Pruthvi-Neuracore/The-UMI-no-one-wants-hw/pg-chopstick/README.md

# PG Chopstick

**Collect robot-manipulation data with your own hands, then replay it on a robot with the same gripper.**

<p align="center">
  <a href="docs/media/pg_chopstick.mp4">PG Chopstick overview: the Insta360 X5 chopstick and HandUMI parallel grippers, the robot twins docking on UR5e, ABB GoFa, FANUC CRX and OpenArm, the wrist mount, and the D405 + Quest builds</a>
  <br><em>Overview (46 s). Click for the full-quality video.</em>
</p>

<p align="center">
  PG Chopstick handheld gripper with an Insta360 X5
  PG Chopstick handheld gripper with a RealSense D405 and a Quest Touch Pro controller
</p>

> Each kit also has its own branch: [`pg-chopstick-x5`](https://github.com/Pruthvi-Neuracore/The-UMI-no-one-wants-hw/tree/pg-chopstick-x5) (Insta360 X5) and
> [`pg-chopstick-d405`](https://github.com/Pruthvi-Neuracore/The-UMI-no-one-wants-hw/tree/pg-chopstick-d405) (D405 + Quest).

PG Chopstick is open hardware for handheld data collection. You hold a printed gripper, or wear a camera on your
wrist, and do the task. A camera on the device records what you see. Its robot twin carries the same jaws and the same
camera at the same spot, so a policy trained on your demonstrations sees the same thing on the robot.

<p align="center">
  Bimanual UR5 with PG Chopstick grippers
</p>

## Two camera kits × three ways to grasp

| | **Insta360 X5 kit** | **D405 + Quest kit** |
|---|---|---|
| Camera | Insta360 X5, 360° video | Intel RealSense D405 depth camera, on a tilting mount |
| Pose | from the X5's own IMU and visual mapping of its video | live, from a Meta Quest Touch Pro controller on the device (tracking only) |
| On the device | wireless: the PG pod (ESP32-S3, IMU, battery) | one USB-C cable: Pico 2 + IMU + USB 3 hub in a small box |
| **Chop-UMI**: geared chopstick jaws you pinch | [insta360_x5/chop-umi](insta360_x5/chop-umi/README.md) | [d405/chop-umi](d405/chop-umi/README.md) |
| **Para-UMI**: the HandUMI T-plate parallel gripper, swappable tips | [insta360_x5/para-umi](insta360_x5/para-umi/README.md) | [d405/para-umi](d405/para-umi/README.md) |
| **Hand**: camera on your wrist, bare hand | [insta360_x5/hand](insta360_x5/hand/README.md) | [d405/hand](d405/hand/README.md) |

- **Chop-UMI:** right-hand and left-hand builds and two robot twins, on **OpenArm** (link7 adapter) and on any cobot
  with an **ISO 9409-1-50-4-M6** flange (UR e-series, ABB GoFa, FANUC CRX, ...). On the D405 kit, the Quest controller
  sits in HandUMI's own controller support, facing forward, mirrored for the left hand.
- **Para-UMI:** [HandUMI](https://github.com/Pruthvi-Neuracore/The-UMI-no-one-wants) unchanged. On the X5 kit the
  only new part is the X5 cradle on its camera hinge. The tips swap (AgileX Piper, Robotiq Hand-E, Open-ENPIRE) to
  match the robot's own gripper, and a printed **camera post** for each robot (Hand-E on UR / ABB / FANUC, Piper,
  OpenArm) puts the same camera in the same place relative to the robot's fingers.
- **Hand:** the camera straps to your wrist, or to a dexterous robot hand's forearm. A thumb strap round the palm keeps
  it put and carries a soft **palm button**: curl your middle and ring fingers in to start and stop recording.
- **One button per gripper:** it sits under your index finger. **Green** on the right hand records (start / stop);
  **red** on the left hand cancels the take.

<table>
<tr>
<td align="center">HandUMI T-plate gripper with the Insta360 X5 on its camera post<br><b>Para-UMI</b>: HandUMI with the X5 on its post, swappable tips</td>
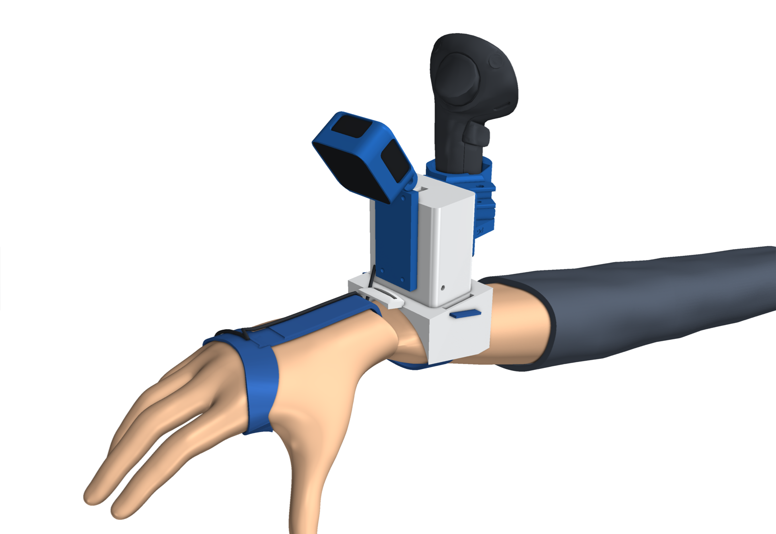
[picture p29: pg-chopstick/d405/hand/img/hand.png]
Insta360 X5 strapped to the wrist over a relaxed hand, with the thumb strap
<td align="center"><br><b>Hand</b>: the camera rides on your wrist</td>
</tr>
<tr>
<td align="center">The Para-UMI device beside a Robotiq Hand-E with the camera post: the X5 in the same place over both<br>Para-UMI's camera on the robot's own gripper</td>
<td align="center">FANUC CRX-5iA pair with chopsticks<br>FANUC CRX-5iA ×2, chopsticks</td>
</tr>
<tr>
<td align="center">The palm button on the thumb strap<br>The palm button, on the thumb strap</td>
<td align="center">The X5 on a Shadow Hand's forearm on a UR5e<br>The same wrist mount on a robot hand</td>
</tr>
</table>

## What the Chop-UMIs share

<p align="center">
  Chopstick jaws opening 0 to 45 degrees per jaw
</p>

- **One interface:** the chopsticks clip to the camera frame with a tongue and two M3 × 55 screws, and every robot plate
  bolts to the frame's back with four M3 inserts. Mix and match.
- **Elastic finger sleeves:** your fingers sit on a pad between two slotted fins, held by a soft hook-and-loop strap
  that fits any finger.
- **Blue tracking dots:** printed as inlays on the jaws, so the camera sees how far they are open.
- **Checked in CAD:** every build is clash-checked closed, half open and fully open, and every robot twin has a URDF.
- **Para-UMI grippers:** these are HandUMI's own design (finger sleeves, record button, tip flange), with the same
  green record / red cancel button covers.
- **PG look:** blue structure, white moving parts, an engraved PG badge on every part.

<p align="center">
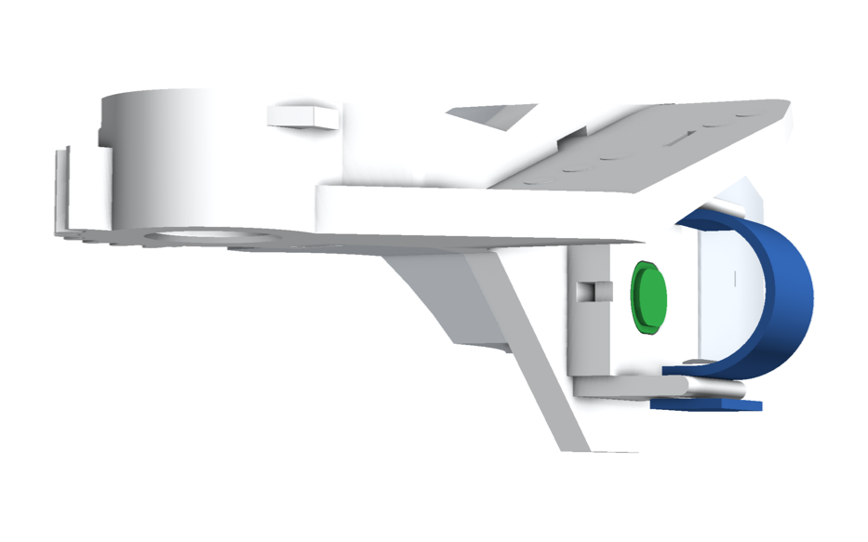
[picture p30: pg-chopstick/d405/chopstick/img/sleeve.png]
Elastic finger sleeve with the green record button
  
  OpenArm adapter and ISO 50 plate
</p>

## Repository layout

```
pg-chopstick/                               (this folder, on main)
  insta360_x5/{chop-umi,para-umi,hand}/     README · bom.md · electronics.md · STEP/ · STL/ · assembly/ · urdf/ · img/
  d405/{chop-umi,para-umi,hand}/            (same)
  tags/                                     ArUco tag sheet, one tag per device
  docs/media/                               pg_chopstick.mp4, pg_chopstick.gif
```

The build code is on the [`cad`](https://github.com/Pruthvi-Neuracore/The-UMI-no-one-wants-hw/tree/cad) branch, in
`pg-chopstick/cad/`: `insta360_x5/` and `d405/` hold each kit's generators (Python, build123d), and `make_video.py`
makes the overview video. Paths written as `cad/...` in these docs are there.

Each variant folder holds everything you need to print and build it: every part as STEP and STL, the assemblies
(GLB and STL), the URDFs, a bill of materials, the wiring, and a detailed README with renders.

## Rebuild from source

Use Python 3.12 with `build123d`, `bd_warehouse`, `trimesh`, `manifold3d`, `scipy`, `pyvista` and `yourdfpy`. On the `cad` branch, in
`pg-chopstick/cad/<kit>/`, run the part scripts, then `kinematics.py --check`, `urdf.py`, `assembly.py --check`, `render_docs.py`,
`robots.py`, `t_gripper.py` (the HandUMI parallel gripper), `robot_cameras.py` (its robot camera posts) and finally
`package.py`, which copies the results into
`pg-chopstick/<kit>/`. Generated intermediates go to
`build/` (not committed).

## Status

- **Designed and checked in CAD:** the chopstick and hand builds of both kits (clash checks, opening limits, gear
  mesh, robot flange fit, URDFs), and the X5 cradle on HandUMI (clash-free at every opening with every tip set).
- **Not yet printed or tested on hardware:** the new parts, the ISO plate's spigot and dowel on a real flange, and the
  firmware for the pod and the box.
- **Software (retargeting, tracking):** not in this repository yet.

Licences: [NOTICE.md](NOTICE.md) (Apache-2.0).
