Pruthvi-Neuracore/The-UMI-no-one-wants-hw/scissor-umi/cad/source/feetech/README.md

# Feetech STS3215 (reference model)

| File | Source | License |
|---|---|---|
| `STS3215_03a.step` | [TheRobotStudio/SO-ARM100](https://github.com/TheRobotStudio/SO-ARM100) `STEP/SO100/STS3215_03a.step` (as vendored in HandUMI) | Apache-2.0 |

It is used for the renders and the clearance checks, and to place the servo's mounting holes in the electronics box.
