Pruthvi-Neuracore/The-UMI-no-one-wants-hw/pg-chopstick/d405/hand/electronics.md

# Electronics: D405 + Quest · Hand

One USB-C cable from the electronics box to the laptop carries the D405 and the Pico. The Quest Touch Pro controller is
self-powered (built-in battery) and tracks itself with its own cameras; it has no wires and its buttons are not used.

```
 D405 depth camera ──USB 3 (out of the cup's top window, into the box's top slot)──┐
                                                                                   ├── USB 3 hub ══ USB-C ══ laptop
 Raspberry Pi Pico 2 ──USB─────────────────────────────────────────────────────────┘
   ├── I²C GP4 SDA / GP5 SCL ── IMU breakout (BNO085 class), flat under the box's top wall
   └── GP15 / GP14 free (no finger sleeve on the hand build; add a fingertip button here if you want one)

 Meta Quest Touch Pro controller in the cradle ── self-tracked by its own cameras (pose only; buttons unused)
```

| Part | Notes |
|---|---|
| USB 3 hub board, USB-C upstream (VL817-type, 4 port) | Stands against the box's front wall (bay 42 × 38 mm, ≤ 14 mm thick). The upstream USB-C leaves through the slot low in the back wall. **Check your board's size** |
| Raspberry Pi Pico 2 | On the box's back wall (M2 standoffs or foam tape), micro-USB to the hub with a short right-angle cable |
| IMU breakout, BNO085 class | Flat under the top wall, rigid to the head |
| D405 cable, USB-C to USB-A, USB 3, about 15 cm | From the cup's top window down into the box's top slot |

**Power.** Everything runs from the laptop's USB 3 port (900 mA covers the D405, the Pico and the IMU). If the camera
drops out, use a port that gives more current or a powered hub.
