Pruthvi-Neuracore/The-UMI-no-one-wants-hw/handumi/docs/img/fea/crank_mechanism_plate_0.png

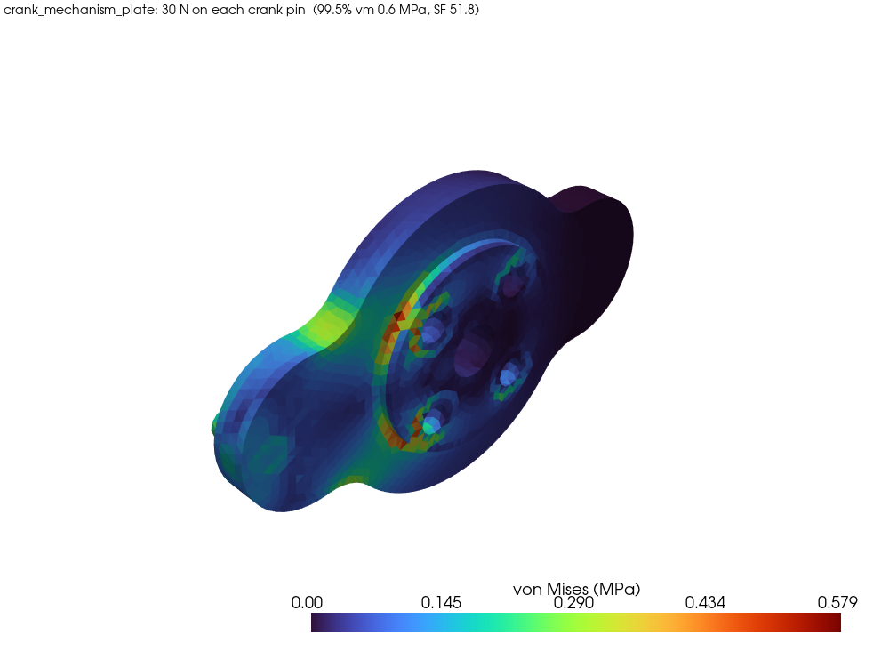
handumi/docs/img/fea/crank_mechanism_plate_0.png
