Pruthvi-Neuracore/The-UMI-no-one-wants-hw/handumi/docs/img/fea/finger_link_0.png

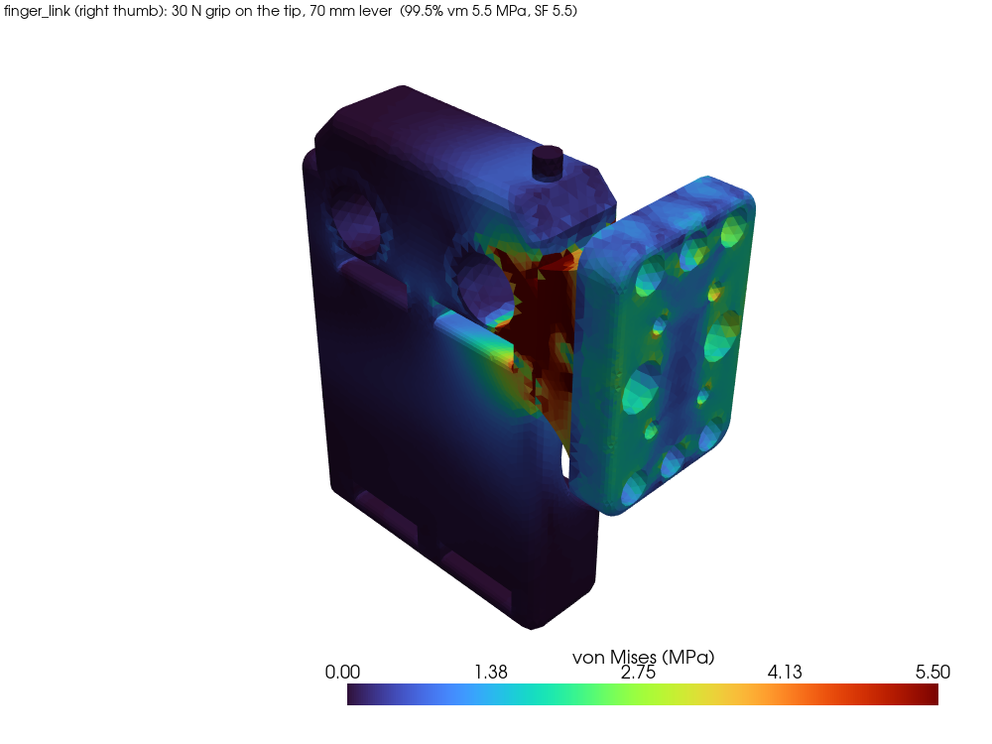
handumi/docs/img/fea/finger_link_0.png
