Pruthvi-Neuracore/The-UMI-no-one-wants-hw/handumi/docs/img/fea/main_support_3.png

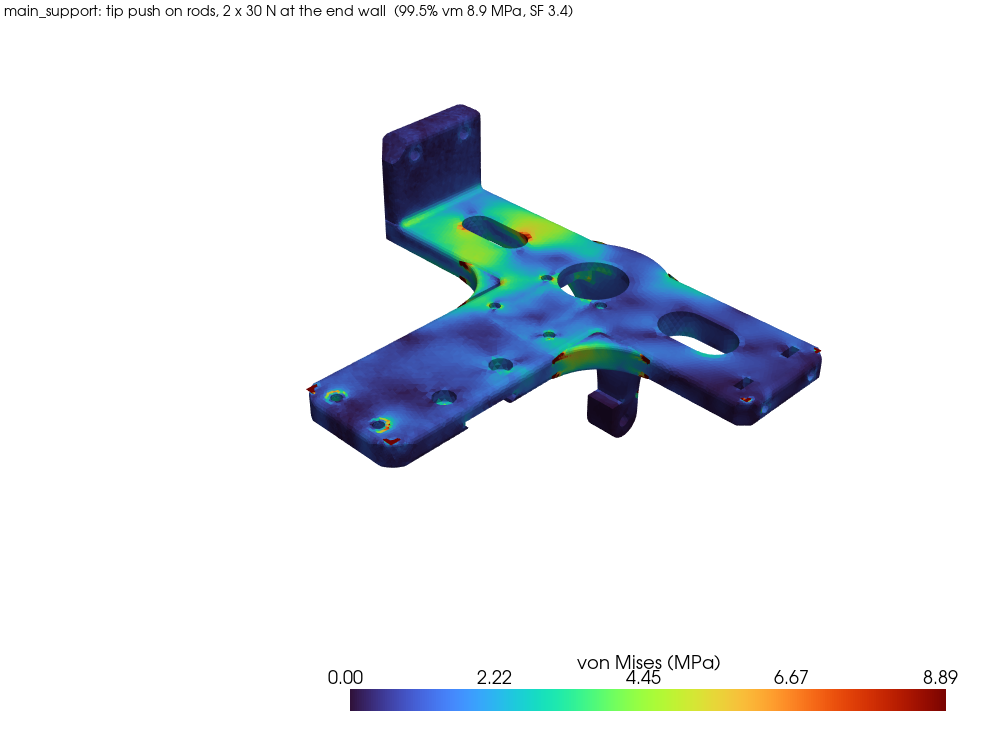
handumi/docs/img/fea/main_support_3.png
