Pruthvi-Neuracore/The-UMI-no-one-wants-hw/pg-chopstick/d405/chop-umi/img/opening.png

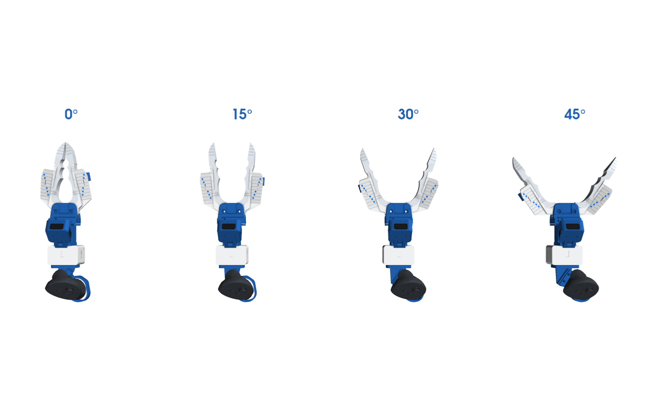
pg-chopstick/d405/chop-umi/img/opening.png
