Pruthvi-Neuracore/The-UMI-no-one-wants-hw/pg-chopstick/d405/hand/img/pod.png

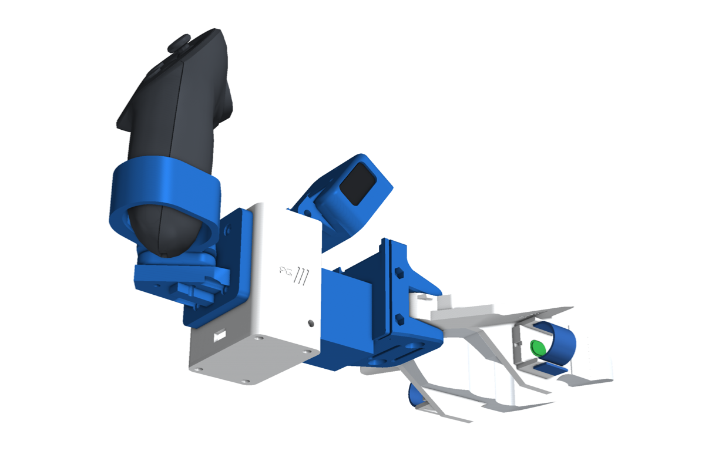
pg-chopstick/d405/hand/img/pod.png
