Pruthvi-Neuracore/The-UMI-no-one-wants-hw/pg-chopstick/insta360_x5/para-umi/img/camera_mount.png

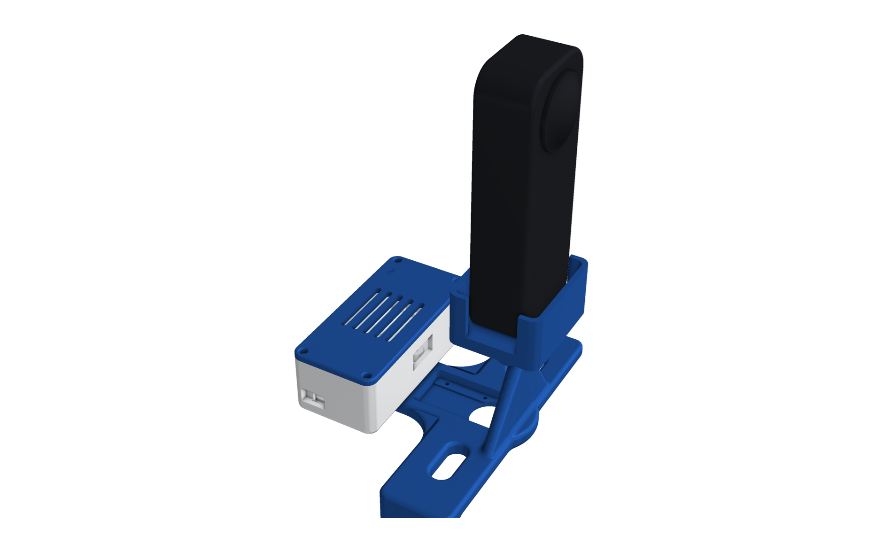
pg-chopstick/insta360_x5/para-umi/img/camera_mount.png
