Pruthvi-Neuracore/The-UMI-no-one-wants-hw/pg-chopstick/insta360_x5/para-umi/img/robot_camera_openarm.png

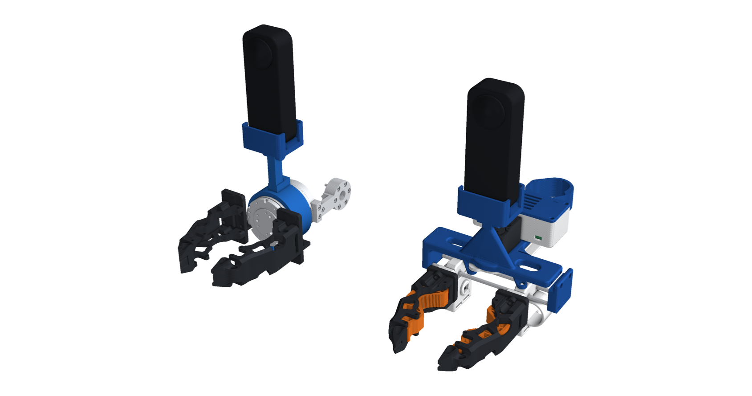
pg-chopstick/insta360_x5/para-umi/img/robot_camera_openarm.png
