Pruthvi-Neuracore/The-UMI-no-one-wants-hw/pg-chopstick/insta360_x5/para-umi/img/tips_open-enpire.png

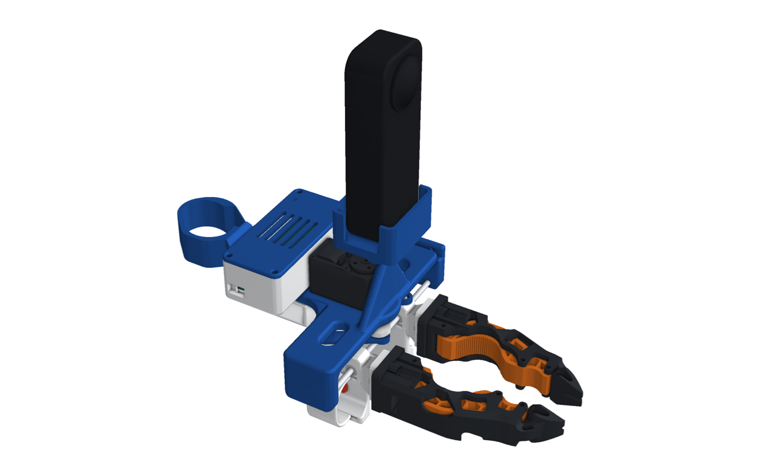
pg-chopstick/insta360_x5/para-umi/img/tips_open-enpire.png
