Pruthvi-Neuracore/The-UMI-no-one-wants-hw/pg-chopstick/insta360_x5/parallel/img/parallel_opening.png

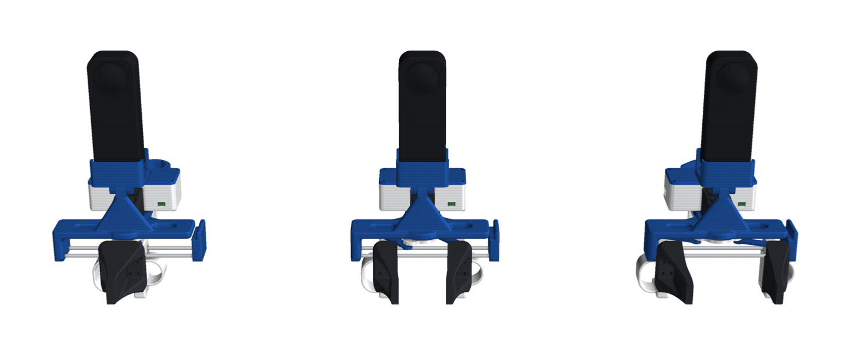
pg-chopstick/insta360_x5/parallel/img/parallel_opening.png
