Pruthvi-Neuracore/The-UMI-no-one-wants-hw/scissor-umi/2f-85/img/hands.png

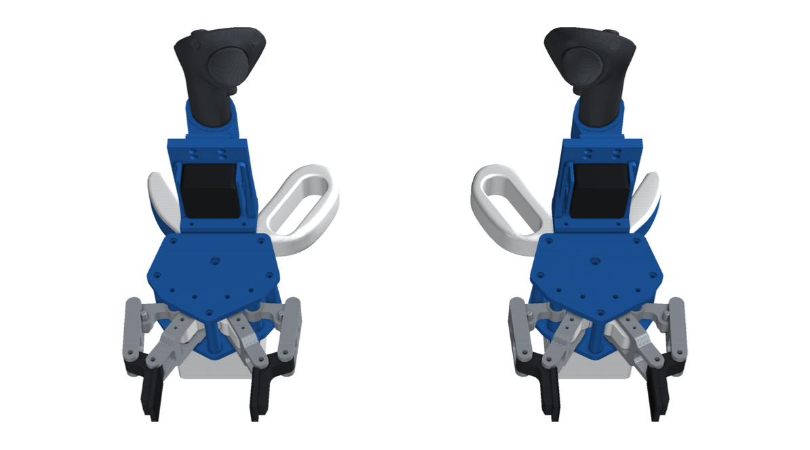
scissor-umi/2f-85/img/hands.png
