Pruthvi-Neuracore/The-UMI-no-one-wants-hw/handumi/docs/bom.md

# Bill of materials

Quantities are for a **pair** (one right-hand and one left-hand device).

## Printed parts

| Part | Material | Qty |
|---|---|---|
| Everything in `hardware/STL/right/` and `hardware/STL/left/` except the button cover | PLA or PETG, ~200 g per device | 1 set each |
| `button_cover_tpu.stl` | TPU 95A | 2 |
| Tips from `hardware/STL/gripper_tips/` (Piper, Open-ENPIRE or Hand-E) | PLA / PETG (ENPIRE soft inserts in TPU) | 2 pairs |

## Mechanics

| Part | Qty |
|---|---|
| MR63ZZ bearing, 3 × 6 × 2.5 mm | 8 |
| LM4UU linear bearing, 4 × 8 × 12 mm | 8 |
| Ø4 mm × 135 mm stainless rod | 4 |
| Feetech STS3215 servo (used as the jaw-width encoder, torque off) | 2 |
| M4×30 bolt + nyloc nut (camera hinge) | 2 |
| M3×5 screws (D405 to its cup) | 4 |
| M3 screws: 4× M3×20, 8× M3×12, 8× M3×15 (mechanism); 4× M3×8 (box to arm); 8× M3×6 (lid) | 32 |
| M3 heat-set inserts, Ø4.0 × 5 (box, lid, M3 tip pattern) | ~24 |
| M2 screws + nuts (mechanism, tips, Pico) | ~40 |
| Hook-and-loop straps, 15 cm | 8 |

## Electronics

| Part | Qty |
|---|---|
| Intel RealSense D405 | 2 |
| Raspberry Pi Pico 2 | 2 |
| BNO085 IMU breakout | 2 |
| USB 3 hub board, USB-C upstream (fits a 38 × 42 × 14 mm bay) | 2 |
| 6 × 6 mm tactile switch, stiff (~250–320 gf) | 2 |
| Short USB cables (D405 to hub, Pico to hub) and one USB-C cable to the laptop per device | 2 sets |
| 74LVC1G125 buffer or 1 kΩ resistor (servo bus) | 2 |
| Thin 2-core wire, ~30 cm | 2 |

Wiring and power are in [electronics.md](electronics.md).
