Pruthvi-Neuracore/The-UMI-no-one-wants-hw/pg-chopstick/d405/chopstick/bom.md

# Bill of materials: D405 + Quest · Chopstick

Per gripper. A bimanual kit is one `chopstick_right` and one `chopstick_left`, plus two robot twins.

## Printed parts

| Part | Material | Handheld | Robot |
|---|---|---|---|
| `d405_frame` | blue PLA | 1 | 1 |
| `d405_cup` | blue PLA | 1 | 1 |
| `ebox`, `ebox_lid` | white PLA | 1, 1 | |
| `quest_cradle` | blue PLA | 1 | |
| `chopstick_base_dc` / `chopstick_base_sa` | blue PLA | 1 | 1 |
| `chopstick_clip_dc` / `chopstick_clip_sa` | blue PLA | 1 | 1 |
| `jaw_left_dc` + `jaw_right_dc_button` (right hand) or `jaw_left_dc_button` + `jaw_right_dc` (left hand) | white PLA + blue dot inlays | 1 + 1 | |
| `jaw_left_sa`, `jaw_right` | white PLA + blue dot inlays | | 1, 1 |
| `tip_tpu_left`, `tip_tpu_right` | white TPU 95A | 1, 1 | 1, 1 |
| `sleeve_button_cover_right` (record) / `_left` (cancel) | green / red TPU 95A | 1 | |
| `openarm_adapter` or `iso_flange_plate` | blue PETG | | 1 |

## Bought parts

| Item | Handheld | Robot | Notes |
|---|---|---|---|
| Intel RealSense D405 | 1 | 1 | |
| M3 × 6 socket screw | 2 | 2 | D405 into the cup |
| M4 × 30 bolt + M4 nyloc nut | 1 | 1 | Tilt hinge |
| Meta Quest Touch Pro controller (paired to a Quest 3S or 3 headset) | 1 | | Tracking only |
| Hook-and-loop strap, 20 mm, + 2 mm foam | 2 × 20 cm | | Controller in the cradle |
| M3 × 8 + M3 heat-set inserts | 4 + 4 | | Cradle to the box |
| M3 × 10 + M3 heat-set inserts | 4 + 4 | 4 + 4 | Box (or mount plate) to the frame's back plate |
| Electronics box parts | 1 set | | [electronics.md](electronics.md) |
| M2 × 6 self-tapping screw | 4 | | Box lid |
| 624 ball bearing | 4 | 2 | |
| Shoulder screw M3, Ø4 × 18 mm shoulder | 2 | 2 | |
| Socket screw M3 × 55, button head, + nut + washer (9 mm OD) | 2 | 4 | Frame + base + clip |
| Heat-set insert M2 × 4 / M3 × 4 | 2 / 2 | 4 / 1 | Base |
| Rubber band | 1 | | |
| Elastic hook-and-loop strap, 16 mm | 2 × 12 cm | | Finger straps |
| Tactile switch 6 × 6 mm, 250–320 gf + 30 cm 2-core wire | 1 | | Index-finger button to the Pico |
| Feetech SM40BL servo set + 4 × M3 × 12 | | 1 | |
| OpenArm: M3 × 16 / ISO 50: M6 × 14 + dowel Ø6 × 10 | | 6 / 4 + 1 | |
