Pruthvi-Neuracore/The-UMI-no-one-wants-hw/pg-chopstick/insta360_x5/chopstick/bom.md

# Bill of materials: Insta360 X5 · Chopstick

Quantities are per gripper. A bimanual kit is one `chopstick_right` and one `chopstick_left`, plus two robot twins.

## Printed parts

| Part | Material | Handheld | Robot |
|---|---|---|---|
| `x5_lite_frame` | blue PLA | 1 | |
| `x5_frame`, `x5_clip_b` | blue PLA | | 1, 1 |
| `chopstick_base_dc` / `chopstick_base_sa` | blue PLA | 1 | 1 |
| `chopstick_clip_dc` / `chopstick_clip_sa` | blue PLA | 1 | 1 |
| `jaw_left_dc` + `jaw_right_dc_button` (right hand) or `jaw_left_dc_button` + `jaw_right_dc` (left hand) | white PLA + blue dot inlays | 1 + 1 | |
| `jaw_left_sa`, `jaw_right` | white PLA + blue dot inlays | | 1, 1 |
| `tip_tpu_left`, `tip_tpu_right` | white TPU 95A | 1, 1 | 1, 1 |
| `sleeve_button_cover_right` (right hand, record) / `_left` (left hand, cancel) | green / red TPU 95A | 1 | |
| `pg_pod`, `pg_pod_lid` | white PLA | 1, 1 | |
| `openarm_adapter` or `iso_flange_plate` | blue PETG | | 1 |

## Bought parts

| Item | Handheld | Robot | Notes |
|---|---|---|---|
| Insta360 X5 | 1 | 1 | Voice control on, auto power-off off, 4K 120 fps, battery cover removed |
| 624 ball bearing (4 × 13 × 5) | 4 | 2 | |
| Shoulder screw M3, Ø4 × 18 mm shoulder | 2 | 2 | Jaw pivots |
| Socket screw M3 × 55, button head, + M3 nut + washer (9 mm OD) | 2 | 4 | Frame + base + clip |
| Heat-set insert M2 × 4 / M3 × 4 | 2 / 2 | 4 / 1 | Base |
| Socket cap screw M2 × 4 | 2 | 4 | Locating screws |
| Rubber band | 1 | | Opens the jaws |
| Elastic hook-and-loop strap, 16 mm wide | 2 × 12 cm | | Finger straps |
| Tactile switch 6 × 6 mm, 250–320 gf, 4.3 mm tall | 1 | | Index-finger button |
| Thin 2-core silicone wire | 25 cm | | Button to the pod |
| Button-head screw 1/4"-20 × 5/8" | 1 | | Pod + frame + camera |
| PG pod electronics | 1 set | | See [electronics.md](electronics.md) |
| ArUco tag, DICT_4X4_50, 14 mm | 1 | | `pg-chopstick/tags/` |
| Feetech SM40BL servo set + 4 × M3 × 12 | | 1 | Drives the left jaw |
| Mount: M3 heat-set inserts (Ø4.0, ≤ 6 mm) + M3 × 10 | | 4 + 4 | X5 frame to the plate |
| OpenArm: M3 × 16 | | 6 | Adapter to link7 |
| ISO 50: M6 × 14, dowel pin Ø6 × 10 | | 4, 1 | Plate to the tool flange |
| Super glue | ✓ | ✓ | TPU tips |
