Pruthvi-Neuracore/The-UMI-no-one-wants-hw/pg-chopstick/insta360_x5/hand/bom.md

# Bill of materials: Insta360 X5 · Hand

| Item | Qty | Notes |
|---|---|---|
| `x5_lite_frame` | 1 | blue PLA |
| `pg_pod`, `pg_wrist_saddle` | 1 each | white PLA |
| Insta360 X5 | 1 | |
| Button-head screw 1/4"-20 × 5/8" | 1 | Pod + frame + camera |
| M2 × 6 self-tapping screw | 4 | Saddle to the pod |
| PG pod electronics (XIAO ESP32-S3, IMU, 300 mAh LiPo, slide switch) | 1 set | [electronics.md](electronics.md) |
| Hook-and-loop strap, 25 mm wide | about 35 cm | Round the forearm |
| Thin foam pad | 1 | Under the saddle |
| `pg_wrist_saddle_robot` (robot hand only, instead of `pg_wrist_saddle`) | 1 | PETG, for round robot forearms up to Ø137 mm |
