Pruthvi-Neuracore/The-UMI-no-one-wants-hw/assembly/d405/hand/bom.md

# Bill of materials: D405 + Quest · Hand

| Item | Qty | Notes |
|---|---|---|
| `d405_frame`, `d405_cup`, `quest_cradle` | 1 each | blue PLA |
| `ebox`, `ebox_wrist_saddle` | 1 each | white PLA |
| Intel RealSense D405 + 2 × M3 × 6 | 1 | |
| M4 × 30 bolt + M4 nyloc nut | 1 | Tilt hinge |
| Meta Quest 3S Touch Plus controller (and the headset) | 1 | Tracking only |
| Hook-and-loop strap, 20 mm, + 2 mm foam | 2 × 20 cm | Controller in the cradle |
| M3 × 8 + M3 heat-set insert | 4 + 4 | Cradle to the box |
| M3 × 10 + M3 heat-set insert | 4 + 4 | Box to the frame's back plate |
| M2 × 6 self-tapping screw | 4 | Saddle to the box |
| Electronics box parts | 1 set | [electronics.md](electronics.md) |
| Hook-and-loop strap, 25 mm | about 35 cm | Round the forearm |
| Thin foam pad | 1 | Under the saddle |
