Pruthvi-Neuracore/The-UMI-no-one-wants-hw/assembly/d405/parallel/bom.md

# Bill of materials: D405 + Quest · Parallel

Per gripper. A bimanual kit is one `chopstick_right` and one `chopstick_left`, plus two robot twins.

## Printed parts

| Part | Material | Handheld | Robot |
|---|---|---|---|
| `d405_frame` | blue PLA | 1 | 1 |
| `d405_cup` | blue PLA | 1 | 1 |
| `ebox`, `ebox_lid` | white PLA | 1, 1 | |
| `quest_cradle` | blue PLA | 1 | |
| `parallel_base_dc` / `parallel_base_sa` | blue PLA | 1 | 1 |
| `chopstick_clip_dc` / `chopstick_clip_sa` | blue PLA | 1 | 1 |
| `parallel_carriage_left`, `_right` | white PLA | 1, 1 | 1, 1 |
| `parallel_pinion` / `parallel_pinion_servo` | white PLA | 1 | 1 |
| `parallel_finger_left_sleeve` + `parallel_finger_right_button` (right hand), or `_left_button` + `_right_sleeve` (left hand) | white PLA + blue dot inlays | 1 + 1 | |
| `parallel_finger_left`, `_right` | white PLA + blue dot inlays | | 1, 1 |
| `parallel_pad_left`, `_right` | white TPU 95A | 1, 1 | 1, 1 |
| `parallel_button_cover_right` (record) / `_left` (cancel) | green / red TPU 95A | 1 | |
| `openarm_adapter` or `iso_flange_plate` | blue PETG | | 1 |

## Bought parts

| Item | Handheld | Robot | Notes |
|---|---|---|---|
| Intel RealSense D405 | 1 | 1 | |
| M3 × 6 socket screw | 2 | 2 | D405 into the cup |
| M4 × 30 bolt + M4 nyloc nut | 1 | 1 | Tilt hinge |
| Meta Quest 3S Touch Plus controller (and the headset) | 1 | | Tracking only |
| Hook-and-loop strap, 20 mm, + 2 mm foam | 2 × 20 cm | | Controller in the cradle |
| M3 × 8 + M3 heat-set inserts | 4 + 4 | | Cradle to the box |
| M3 × 10 + M3 heat-set inserts | 4 + 4 | 4 + 4 | Box (or mount plate) to the frame's back plate |
| Electronics box parts | 1 set | | [electronics.md](electronics.md) |
| M2 × 6 self-tapping screw | 4 | | Box lid |
| Steel rod Ø6 h6 × 156 mm | 2 | 2 | |
| LM6UU linear bushing | 4 | 4 | |
| Compression spring, ID ≥ 6.5, OD ≤ 11, free about 95 mm | 2 | | Between the carriages |
| M4 × 45 shoulder bolt or Ø4 pin + nyloc nut | 1 | | Pinion axle |
| Socket screw M3 × 14 + M3 heat-set insert | 4 + 4 | 4 + 4 | Fingers to carriages |
| Socket screw M3 × 55, button head, + nut + washer (9 mm OD) | 2 | 4 | Frame + base + clip |
| Elastic hook-and-loop strap, 16 mm | 2 × 12 cm | | Finger straps |
| Tactile switch 6 × 6 mm, 250–320 gf + 30 cm 2-core wire | 1 | | Index-finger button to the Pico |
| Feetech SM40BL servo set + 4 × M3 | | 1 | Turns the pinion |
| OpenArm: M3 × 16 / ISO 50: M6 × 14 + dowel Ø6 × 10 | | 6 / 4 + 1 | |
