Pruthvi-Neuracore/The-UMI-no-one-wants-hw/assembly/insta360_x5/parallel/bom.md

# Bill of materials: Insta360 X5 · Parallel

Per gripper. A bimanual kit is one `parallel_right` and one `parallel_left`, plus two robot twins.

## Printed parts

| Part | Material | Handheld | Robot |
|---|---|---|---|
| `x5_lite_frame` / `x5_frame` + `x5_clip_b` | blue PLA | 1 | 1 + 1 |
| `parallel_base_dc` / `parallel_base_sa` | blue PLA | 1 | 1 |
| `chopstick_clip_dc` / `chopstick_clip_sa` | blue PLA | 1 | 1 |
| `parallel_carriage_left`, `_right` | white PLA | 1, 1 | 1, 1 |
| `parallel_pinion` / `parallel_pinion_servo` | white PLA (or PETG) | 1 | 1 |
| `parallel_finger_left_sleeve` + `parallel_finger_right_button` (right hand), or `_left_button` + `_right_sleeve` (left hand) | white PLA + blue dot inlays | 1 + 1 | |
| `parallel_finger_left`, `_right` | white PLA + blue dot inlays | | 1, 1 |
| `parallel_pad_left`, `_right` | white TPU 95A | 1, 1 | 1, 1 |
| `parallel_button_cover_right` (record) / `_left` (cancel) | green / red TPU 95A | 1 | |
| `pg_pod`, `pg_pod_lid` | white PLA | 1, 1 | |
| `openarm_adapter` or `iso_flange_plate` | blue PETG | | 1 |

## Bought parts

| Item | Handheld | Robot | Notes |
|---|---|---|---|
| Insta360 X5 | 1 | 1 | |
| Steel rod Ø6 h6 × 156 mm | 2 | 2 | Press fit in the end walls |
| LM6UU linear bushing (Ø12 × 19) | 4 | 4 | Press fit in the carriages |
| Compression spring, ID ≥ 6.5, OD ≤ 11, free length about 95 mm | 2 | | On the rods, between the carriages |
| M4 × 45 shoulder bolt or Ø4 pin, + nyloc nut | 1 | | Pinion axle |
| Socket screw M3 × 14 + M3 heat-set insert | 4 + 4 | 4 + 4 | Fingers to carriages |
| Socket screw M3 × 55, button head, + nut + washer (9 mm OD) | 2 | 4 | Frame + base + clip |
| Elastic hook-and-loop strap, 16 mm | 2 × 12 cm | | Finger straps |
| Tactile switch 6 × 6 mm, 250–320 gf + 25 cm 2-core wire | 1 | | Index-finger button |
| Button-head screw 1/4"-20 × 5/8" | 1 | | Pod + frame + camera |
| PG pod electronics | 1 set | | [electronics.md](electronics.md) |
| Feetech SM40BL servo set + 4 × M3 | | 1 | Turns the pinion |
| Mount hardware | | as for the chopstick | |
