Pruthvi-Neuracore/The-UMI-no-one-wants-hw/handumi/docs/assembly_guide/page_00_parts.png

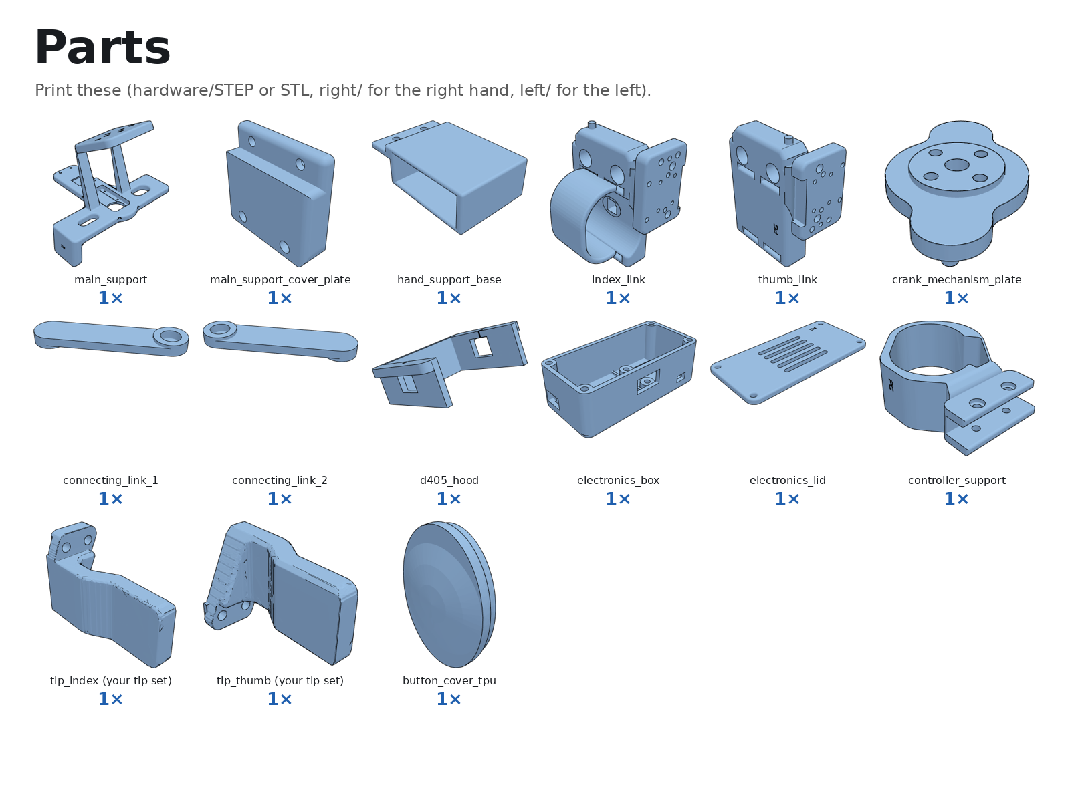
handumi/docs/assembly_guide/page_00_parts.png
