Pruthvi-Neuracore/The-UMI-no-one-wants-hw/handumi/hardware/STL/right/main_support.stl

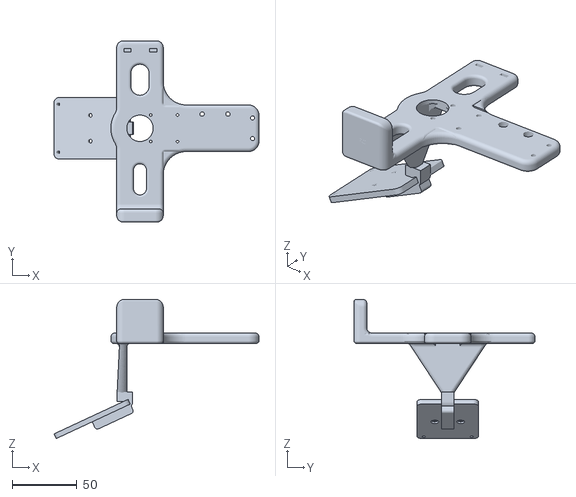
[picture p60: CAD file, 2026-11-05]
handumi/hardware/STL/right/main_support.stl
158.5 x 140.0 x 107.6
