Pruthvi-Neuracore/The-UMI-no-one-wants-hw/pg-chopstick/d405/para-umi/STEP/right/main_support.step

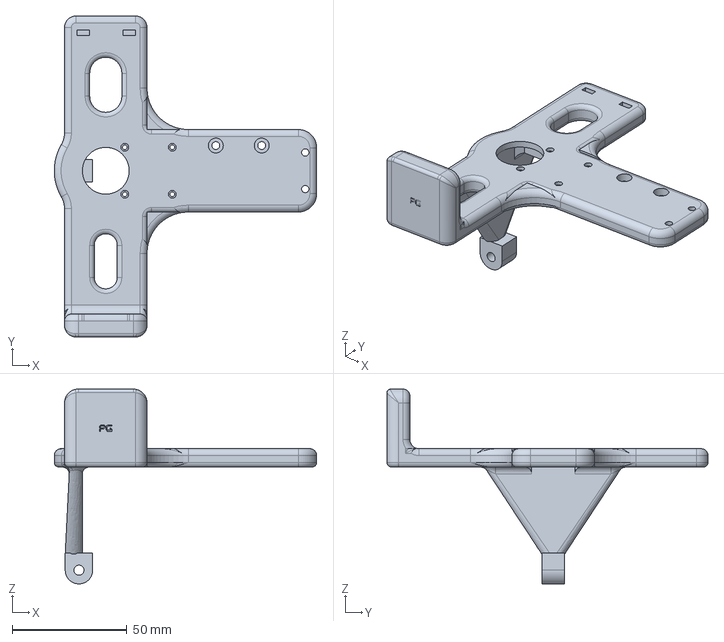
[picture p61: CAD file, 2026-10-13]
pg-chopstick/d405/para-umi/STEP/right/main_support.step
114.5 x 140.0 x 85.0 mm
