Pruthvi-Neuracore/The-UMI-no-one-wants-hw/assembly/d405/chopstick/assembly/chopstick_right.stl

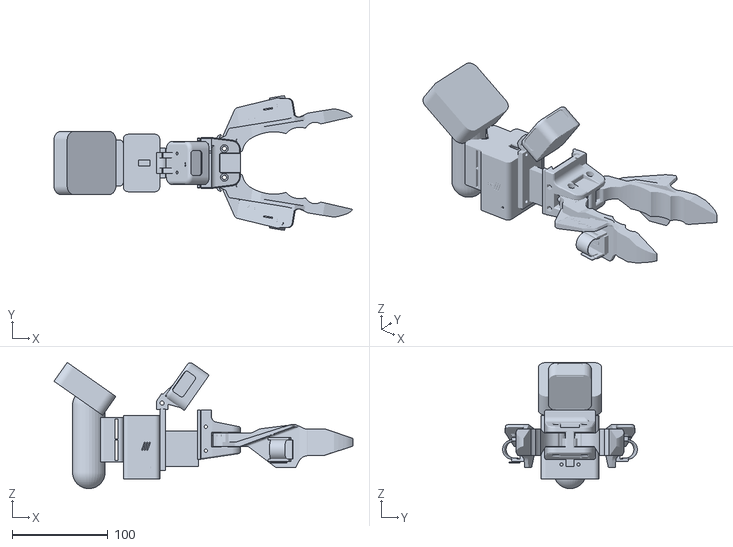
[picture p62: CAD file, 2026-10-12]
assembly/d405/chopstick/assembly/chopstick_right.stl
311.8 x 140.5 x 131.6
