Pruthvi-Neuracore/The-UMI-no-one-wants-hw/assembly/d405/chopstick/STEP/tip_tpu_left.step

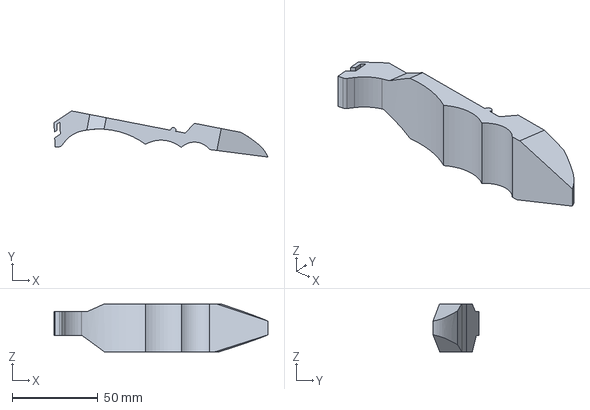
[picture p63: CAD file, 2026-10-12]
assembly/d405/chopstick/STEP/tip_tpu_left.step
124.9 x 27.0 x 28.0 mm
