Pruthvi-Neuracore/The-UMI-no-one-wants-hw/assembly/d405/chopstick/urdf/meshes/d405_frame.stl

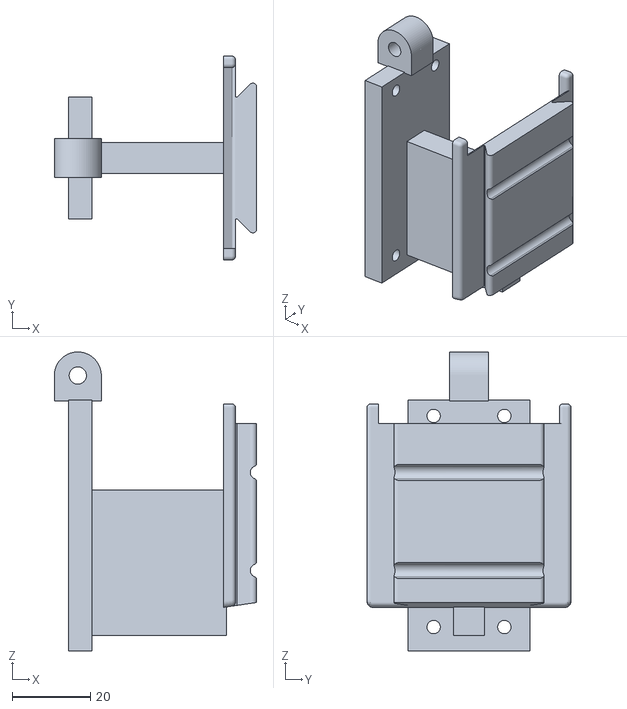
[picture p64: CAD file, 2026-10-12]
assembly/d405/chopstick/urdf/meshes/d405_frame.stl
51.6 x 52.0 x 76.2
