Pruthvi-Neuracore/The-UMI-no-one-wants-hw/assembly/d405/hand/assembly/hand.stl

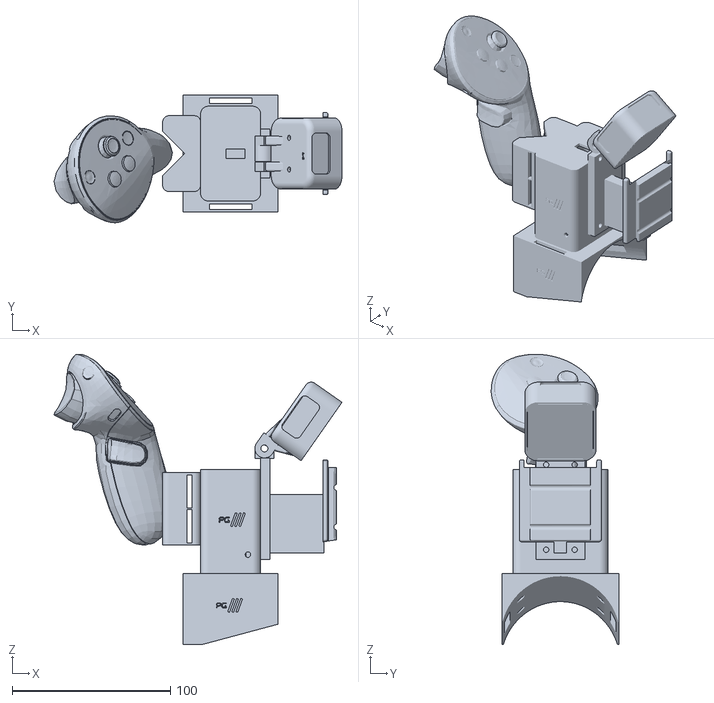
[picture p65: CAD file, 2026-10-12]
assembly/d405/hand/assembly/hand.stl
182.3 x 80.8 x 183.8
