Pruthvi-Neuracore/The-UMI-no-one-wants-hw/assembly/d405/hand/STEP/quest_cradle.step

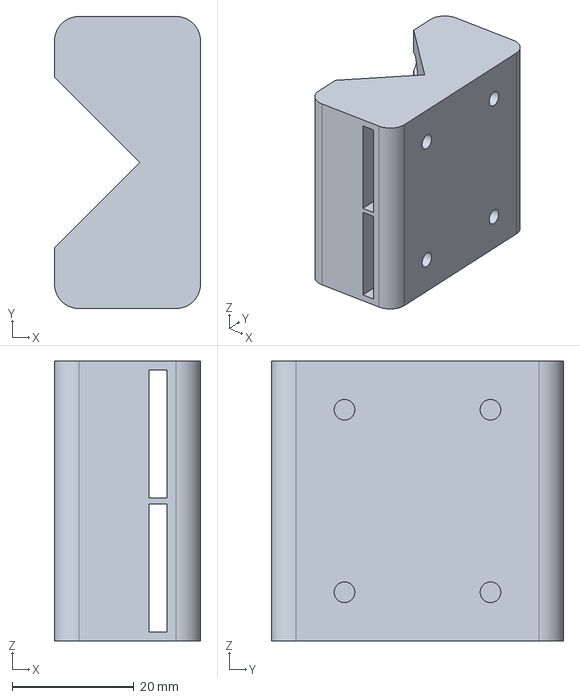
[picture p66: CAD file, 2026-10-12]
assembly/d405/hand/STEP/quest_cradle.step
24.0 x 48.0 x 46.0 mm
