Pruthvi-Neuracore/The-UMI-no-one-wants-hw/assembly/d405/hand/STL/ebox.stl

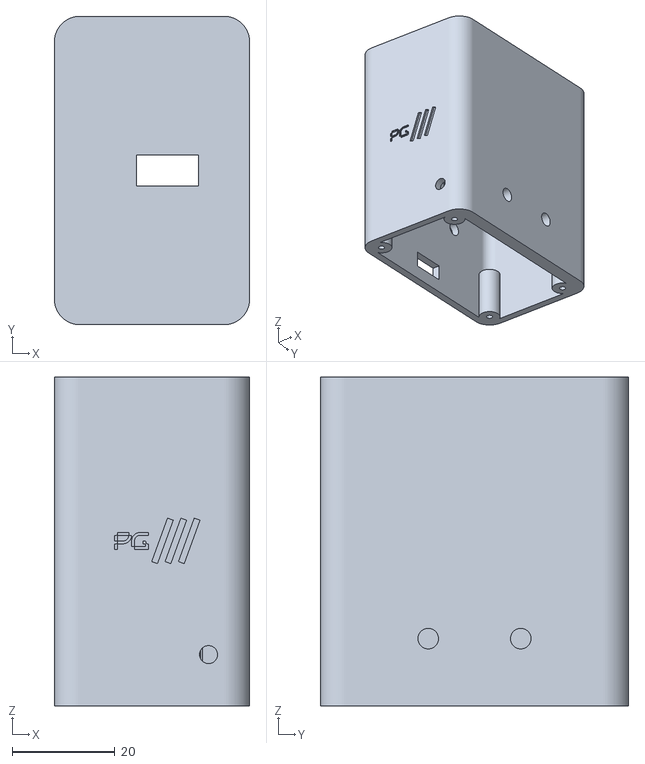
[picture p67: CAD file, 2026-10-12]
assembly/d405/hand/STL/ebox.stl
38.0 x 60.0 x 64.0
