Pruthvi-Neuracore/The-UMI-no-one-wants-hw/assembly/d405/parallel/assembly/d405_parallel_right_robotiq-hand-e.stl

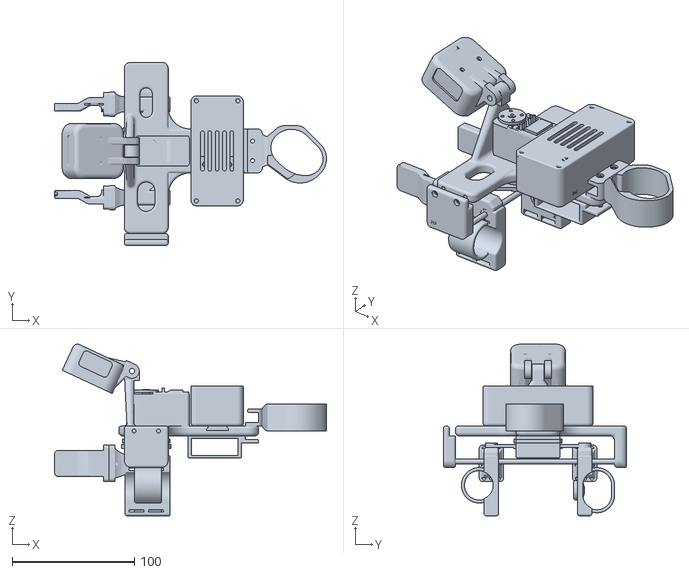
[picture p68: CAD file, 2026-10-12]
assembly/d405/parallel/assembly/d405_parallel_right_robotiq-hand-e.stl
222.6 x 150.0 x 140.6
