Pruthvi-Neuracore/The-UMI-no-one-wants-hw/assembly/d405/parallel/STEP/parallel_finger_right_sleeve.step

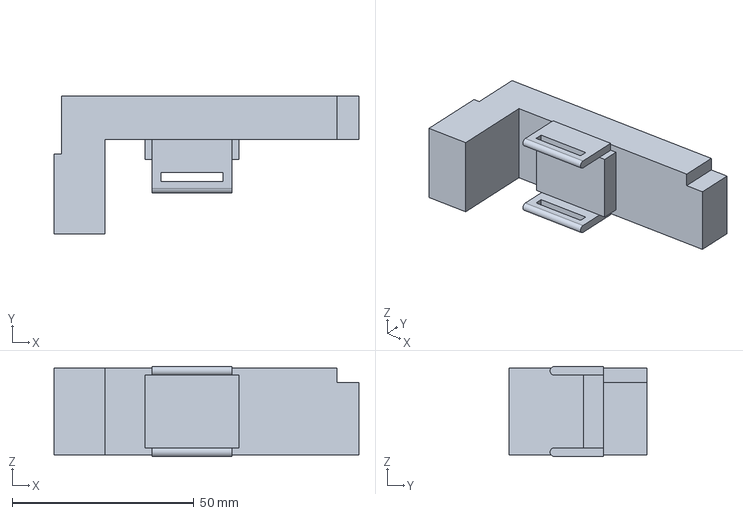
[picture p69: CAD file, 2026-10-12]
assembly/d405/parallel/STEP/parallel_finger_right_sleeve.step
84.0 x 38.0 x 24.8 mm
