Pruthvi-Neuracore/The-UMI-no-one-wants-hw/assembly/d405/parallel/STEP/right/right_thumb_link.step

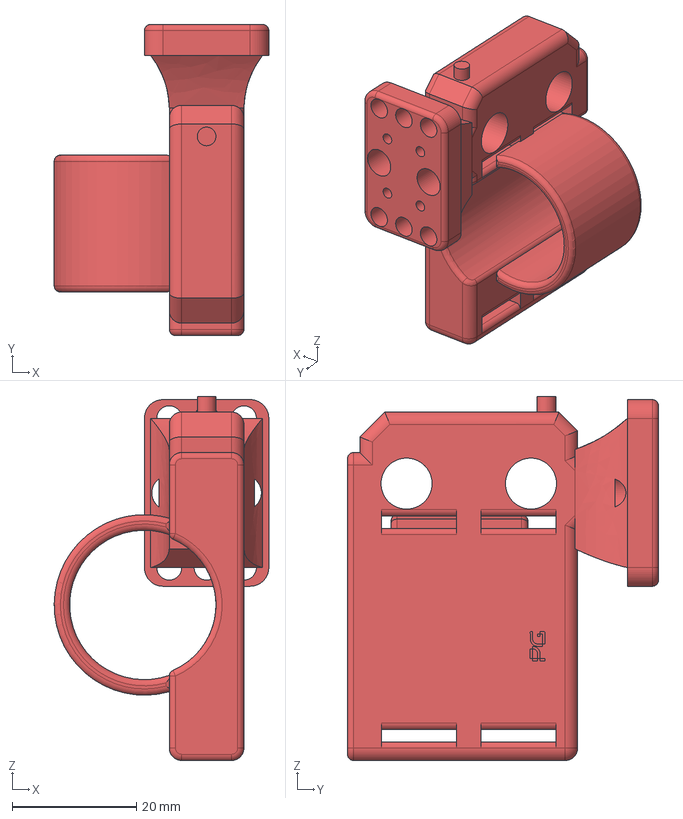
[picture p70: CAD file, 2026-10-12]
assembly/d405/parallel/STEP/right/right_thumb_link.step
34.5 x 50.0 x 58.5 mm
