Pruthvi-Neuracore/The-UMI-no-one-wants-hw/assembly/d405/parallel/STL/gripper_tips/Robotiq-Hand-E/Hand-E-Finger.stl

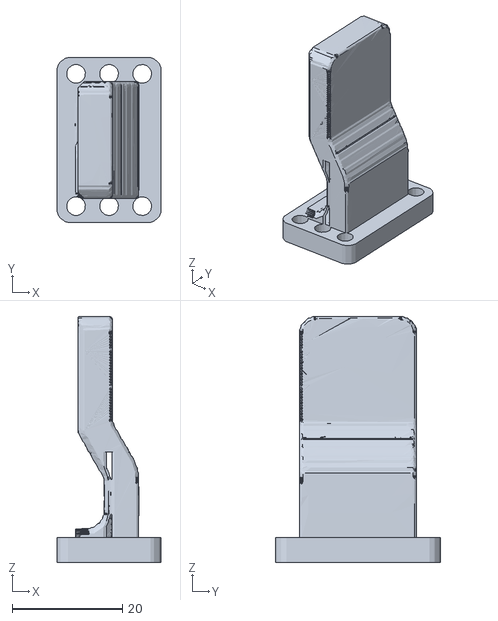
[picture p71: CAD file, 2026-10-12]
assembly/d405/parallel/STL/gripper_tips/Robotiq-Hand-E/Hand-E-Finger.stl
19.0 x 29.9 x 44.6
