Pruthvi-Neuracore/The-UMI-no-one-wants-hw/assembly/d405/parallel/STL/parallel_finger_left_dots.stl

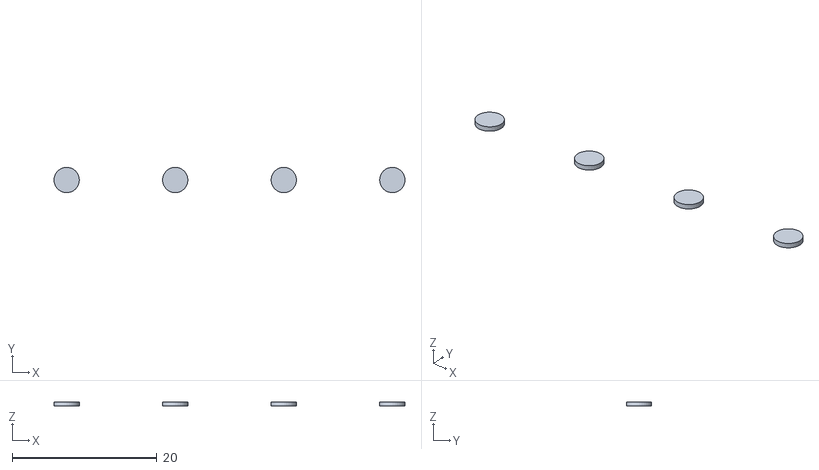
[picture p72: CAD file, 2026-10-12]
assembly/d405/parallel/STL/parallel_finger_left_dots.stl
48.5 x 3.50 x 0.6
