Pruthvi-Neuracore/The-UMI-no-one-wants-hw/assembly/d405/parallel/STL/right/hand_support_base.stl

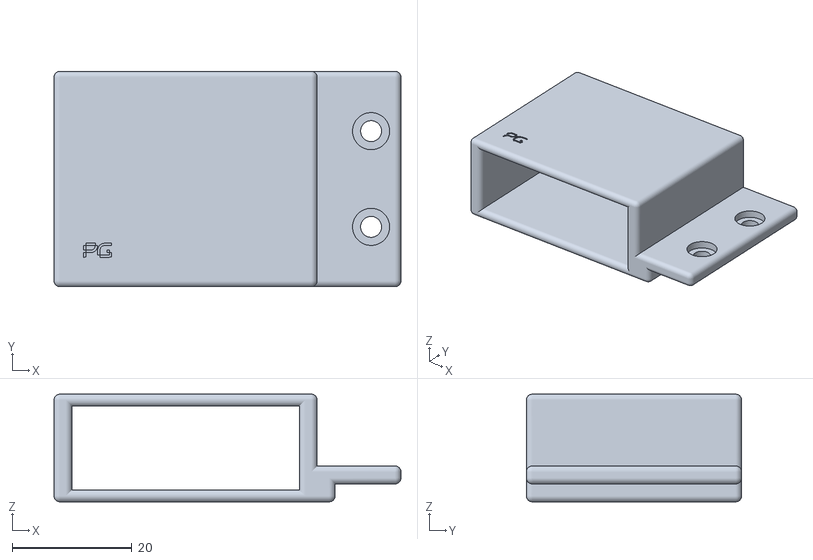
[picture p73: CAD file, 2026-10-12]
assembly/d405/parallel/STL/right/hand_support_base.stl
58.0 x 36.0 x 18.0
