Pruthvi-Neuracore/The-UMI-no-one-wants-hw/assembly/d405/parallel/urdf/meshes/parallel_pinion_servo_pinionframe.stl

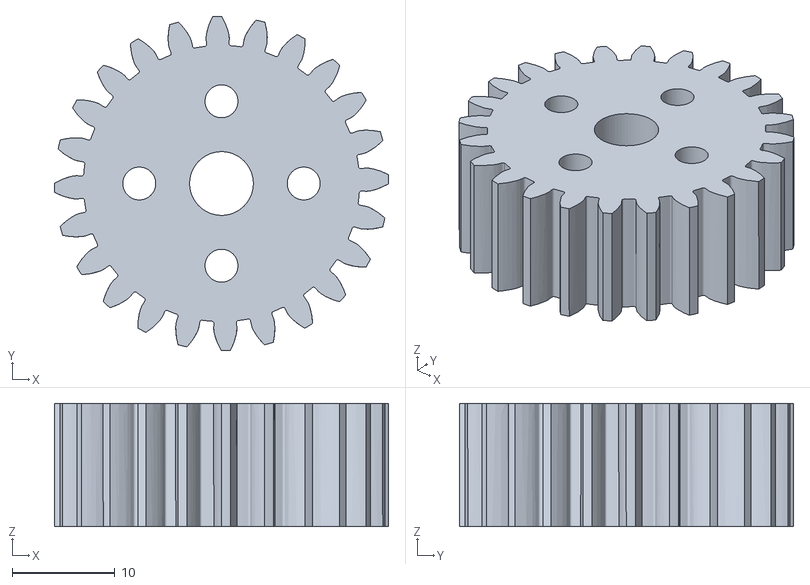
[picture p74: CAD file, 2026-10-12]
assembly/d405/parallel/urdf/meshes/parallel_pinion_servo_pinionframe.stl
32.5 x 32.5 x 12.0
