Pruthvi-Neuracore/The-UMI-no-one-wants-hw/assembly/insta360_x5/chopstick/assembly/chopstick_right.stl

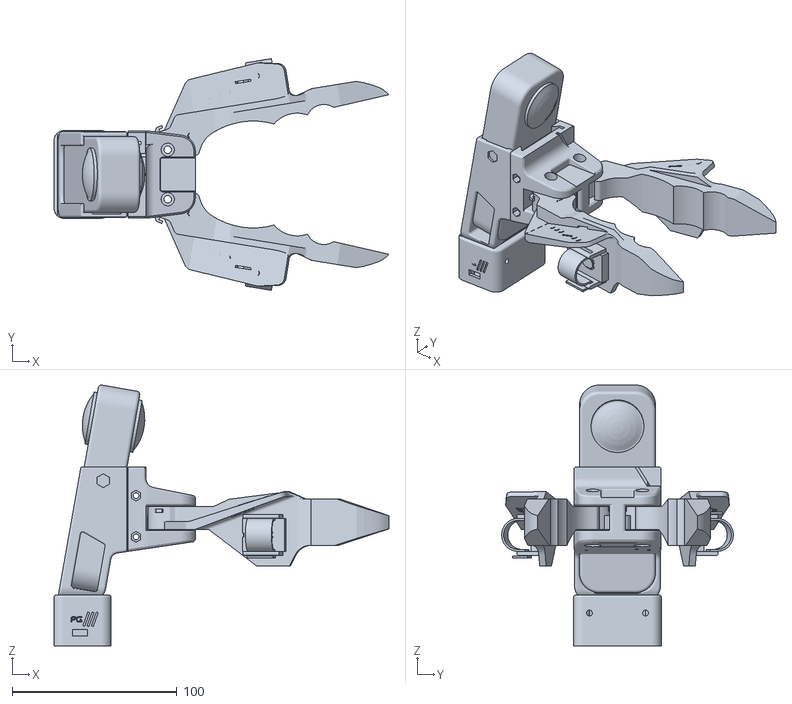
[picture p75: CAD file, 2026-10-12]
assembly/insta360_x5/chopstick/assembly/chopstick_right.stl
203.2 x 140.5 x 158.3
