Pruthvi-Neuracore/The-UMI-no-one-wants-hw/assembly/insta360_x5/chopstick/STEP/chopstick_clip_dc.step

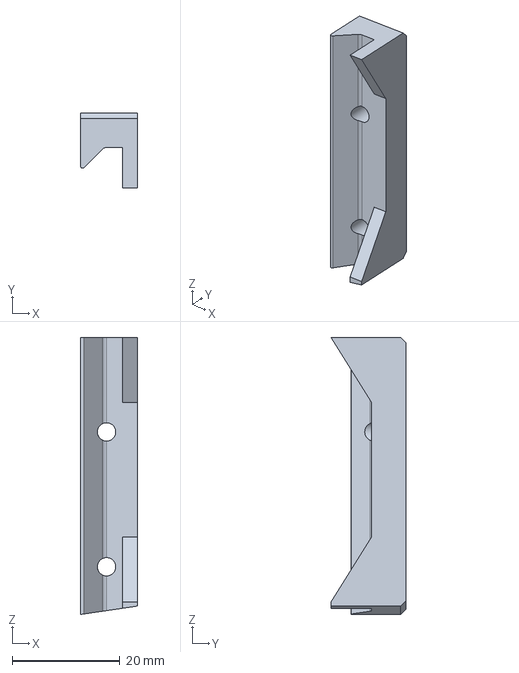
[picture p76: CAD file, 2026-10-12]
assembly/insta360_x5/chopstick/STEP/chopstick_clip_dc.step
10.6 x 13.9 x 51.3 mm
