Pruthvi-Neuracore/The-UMI-no-one-wants-hw/assembly/insta360_x5/chopstick/urdf/meshes/sleeve_button_cover_right_jawframe.stl

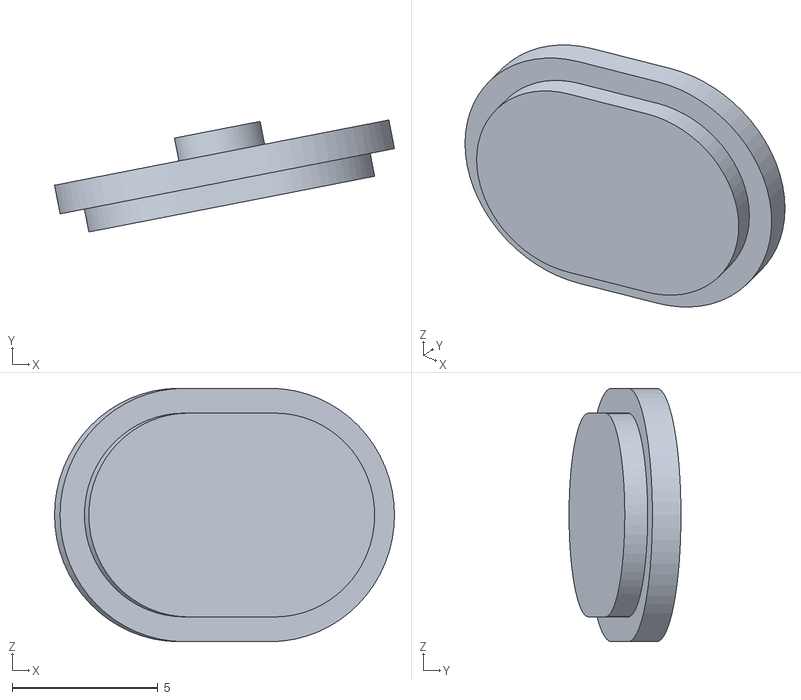
[picture p77: CAD file, 2026-10-12]
assembly/insta360_x5/chopstick/urdf/meshes/sleeve_button_cover_right_jawframe.stl
11.7 x 3.84 x 8.70
