Pruthvi-Neuracore/The-UMI-no-one-wants-hw/assembly/insta360_x5/hand/assembly/hand.stl

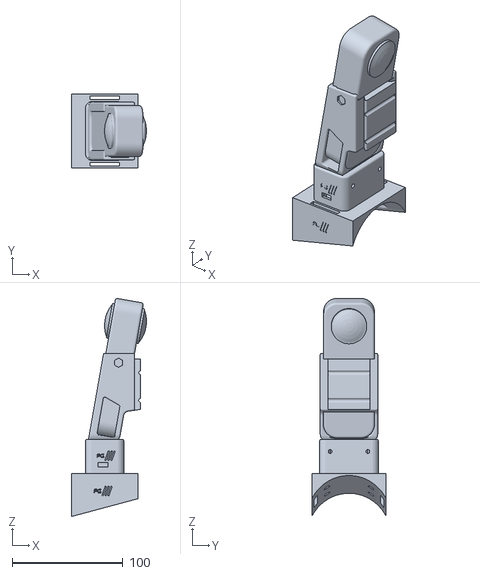
[picture p78: CAD file, 2026-10-12]
assembly/insta360_x5/hand/assembly/hand.stl
67.7 x 67.2 x 197.0
