Pruthvi-Neuracore/The-UMI-no-one-wants-hw/assembly/insta360_x5/hand/STEP/pg_wrist_saddle.step

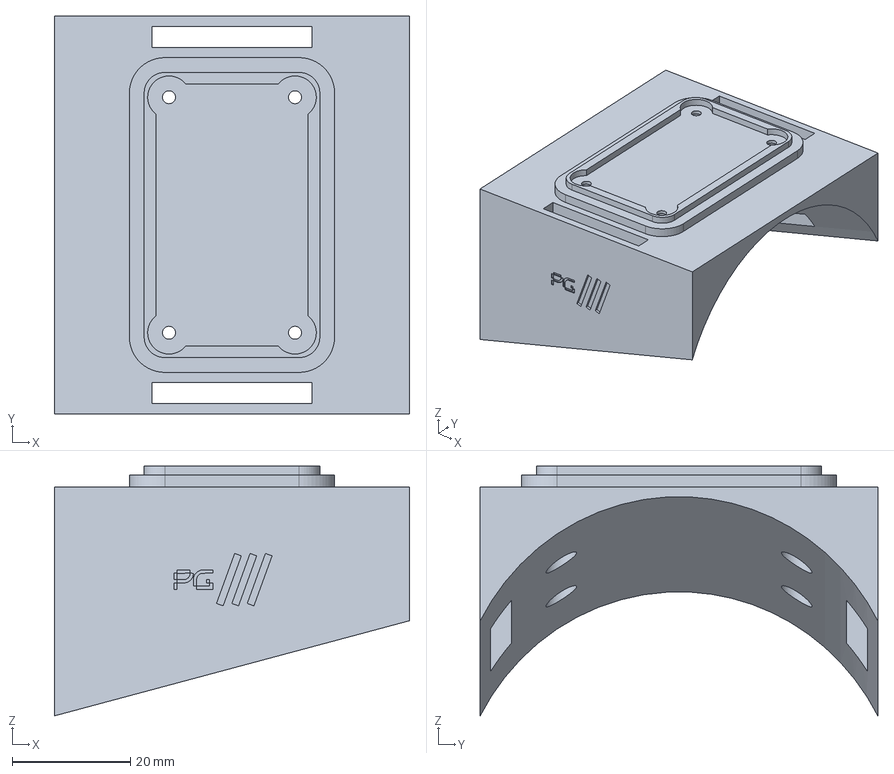
[picture p79: CAD file, 2026-10-12]
assembly/insta360_x5/hand/STEP/pg_wrist_saddle.step
60.0 x 67.2 x 42.2 mm
