Pruthvi-Neuracore/The-UMI-no-one-wants-hw/assembly/insta360_x5/hand/urdf/meshes/pg_pod.stl

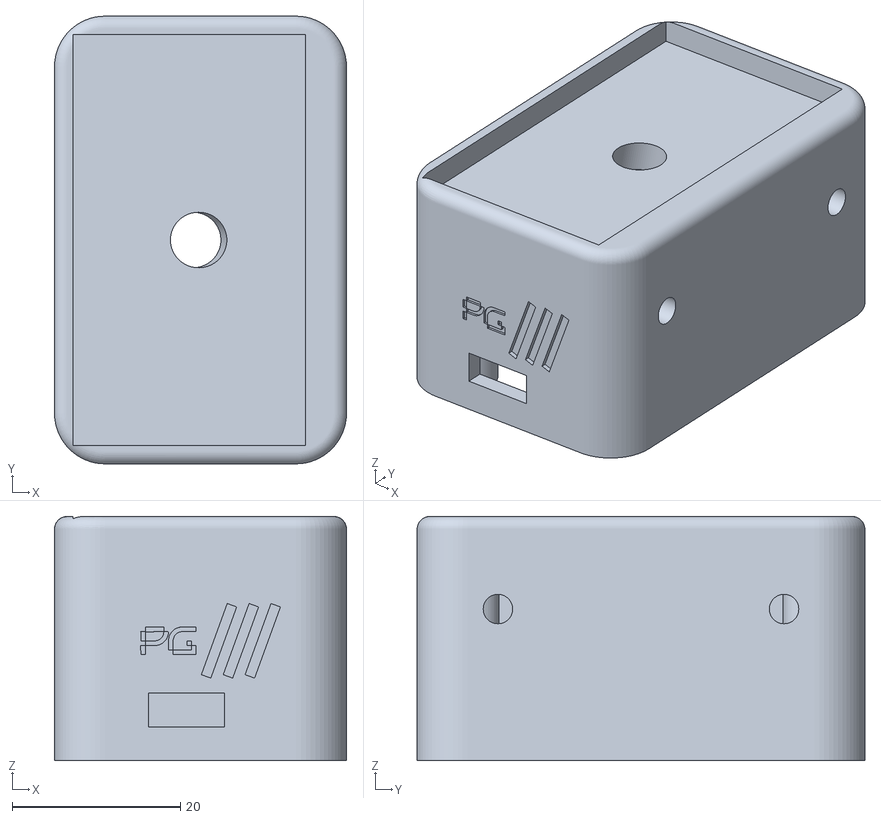
[picture p80: CAD file, 2026-10-12]
assembly/insta360_x5/hand/urdf/meshes/pg_pod.stl
34.7 x 53.2 x 29.0
