Pruthvi-Neuracore/The-UMI-no-one-wants-hw/assembly/insta360_x5/parallel/assembly/parallel_openarm.stl

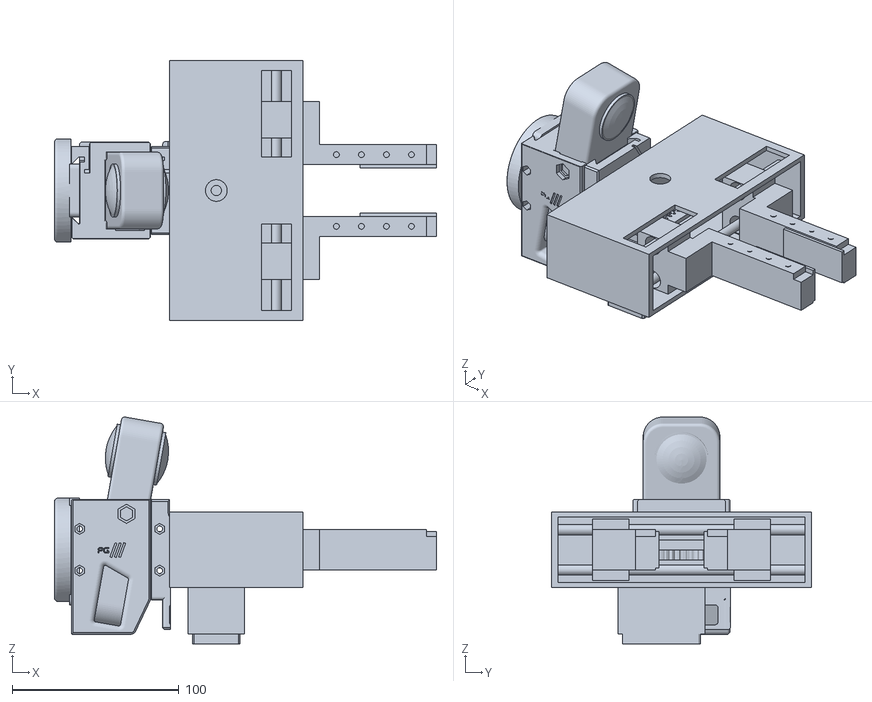
[picture p81: CAD file, 2026-10-12]
assembly/insta360_x5/parallel/assembly/parallel_openarm.stl
229.0 x 156.0 x 136.1
