Pruthvi-Neuracore/The-UMI-no-one-wants-hw/assembly/insta360_x5/parallel/STEP/parallel_pad_right.step

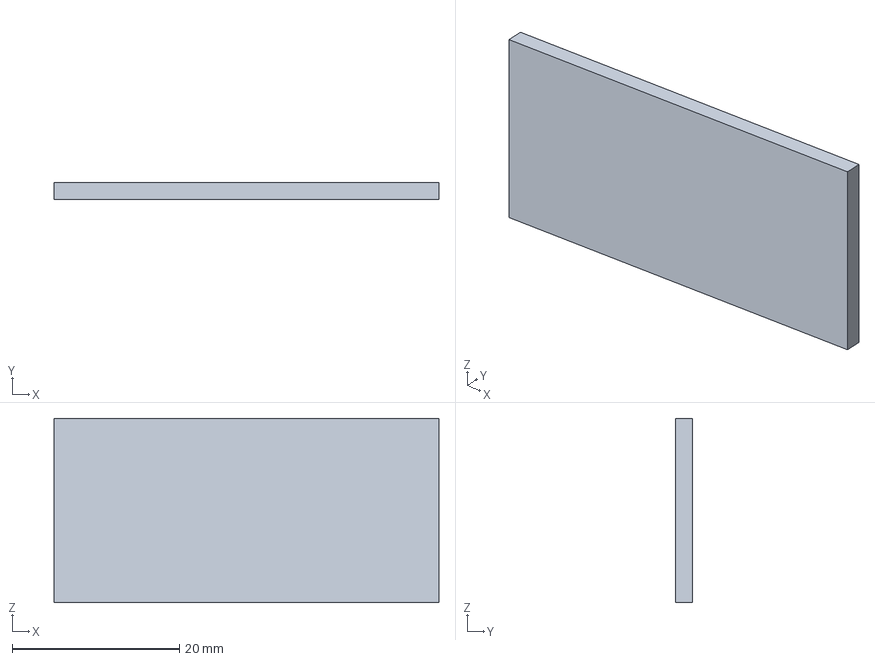
[picture p82: CAD file, 2026-10-12]
assembly/insta360_x5/parallel/STEP/parallel_pad_right.step
46.0 x 2.00 x 22.0 mm
