Pruthvi-Neuracore/The-UMI-no-one-wants-hw/cad/d405/handumi/hardware/STEP/left/d405_wrist_mount.step

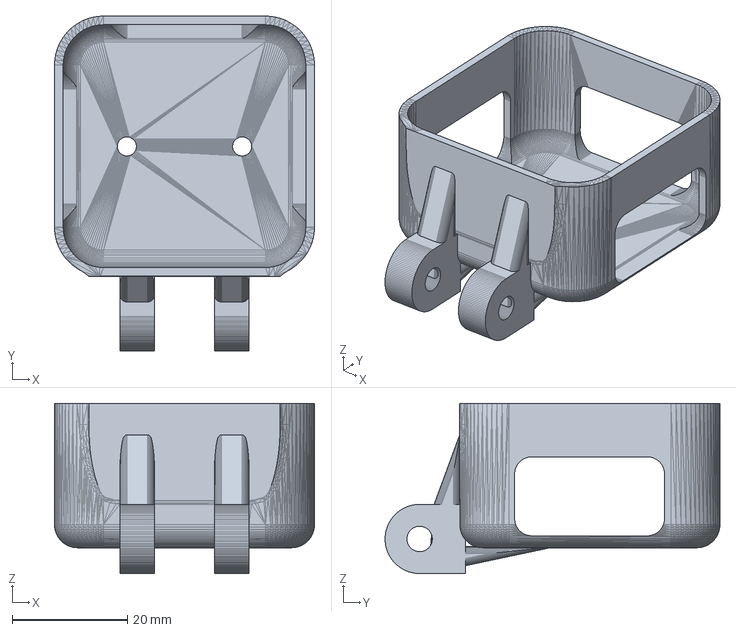
[picture p83: CAD file, 2026-10-12]
cad/d405/handumi/hardware/STEP/left/d405_wrist_mount.step
45.1 x 58.1 x 29.5 mm
