Pruthvi-Neuracore/The-UMI-no-one-wants-hw/cad/d405/source/upstream/robot_gripper.step

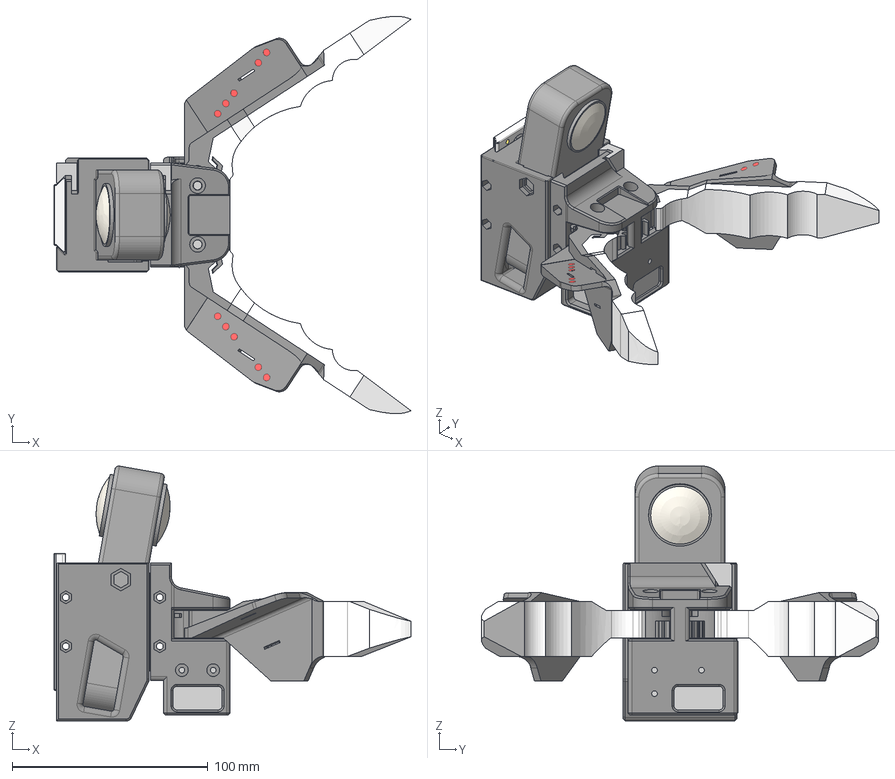
[picture p84: CAD file, 2026-10-12]
cad/d405/source/upstream/robot_gripper.step
182.4 x 203.0 x 130.2 mm
ChopstickBase-SA
Insta360X5 Frame
Left Finger SA Spur Gear 24 teeth 1%
Plate - FrankaRobot
Chopstick - TPU left finger
Right Finger DC/SA Spur Gear 24 teeth 1%
ChopstickClip-SA
Insta360X5 ClipB
Insta360 X5
Servo
Chopstick - TPU right finger
