Pruthvi-Neuracore/The-UMI-no-one-wants-hw/handumi/assembly/umi_right_agilex-piper.stl

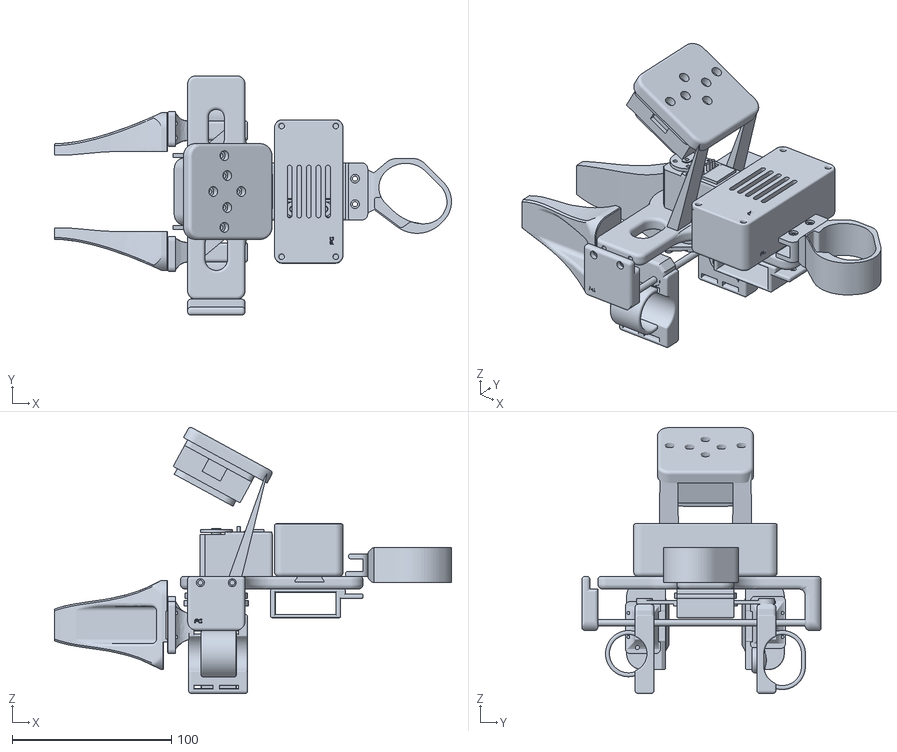
[picture p85: CAD file, 2026-11-06]
handumi/assembly/umi_right_agilex-piper.stl
249.0 x 150.0 x 166.9
