Pruthvi-Neuracore/The-UMI-no-one-wants-hw/handumi/hardware/STEP/gripper_tips/OpenArm/OpenArm-LEFT-Finger.step

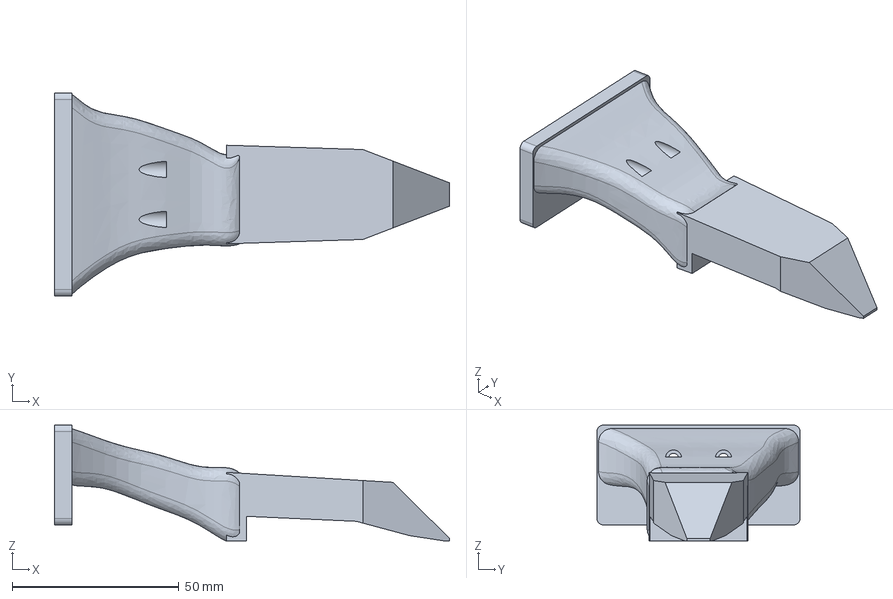
[picture p86: CAD file, 2026-11-05]
handumi/hardware/STEP/gripper_tips/OpenArm/OpenArm-LEFT-Finger.step
118.6 x 61.0 x 34.8 mm
