Pruthvi-Neuracore/The-UMI-no-one-wants-hw/handumi/hardware/STEP/left/d405_hood.step

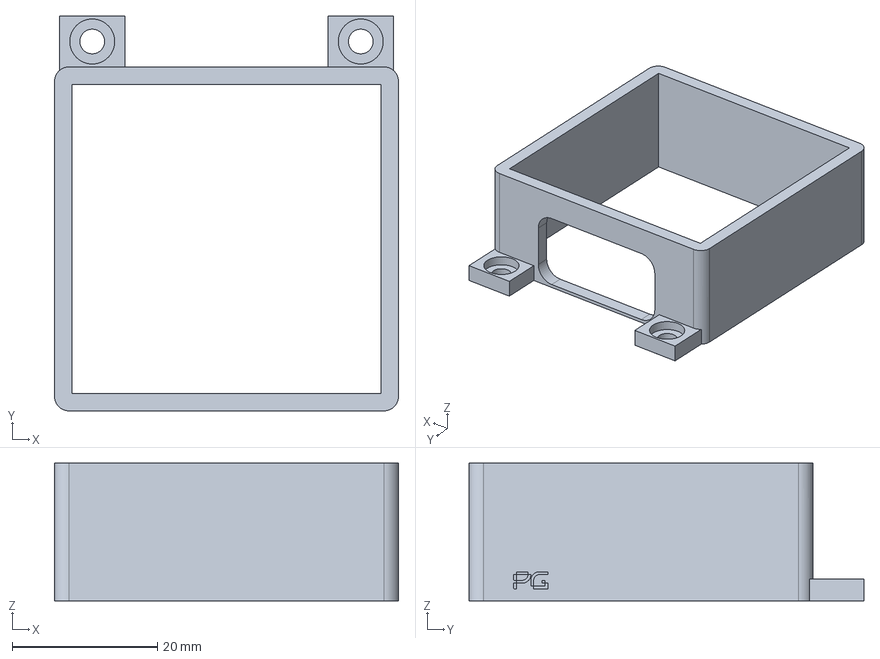
[picture p87: CAD file, 2026-11-05]
handumi/hardware/STEP/left/d405_hood.step
47.4 x 54.4 x 19.0 mm
