Pruthvi-Neuracore/The-UMI-no-one-wants-hw/handumi/hardware/STEP/right/d405_hood.step

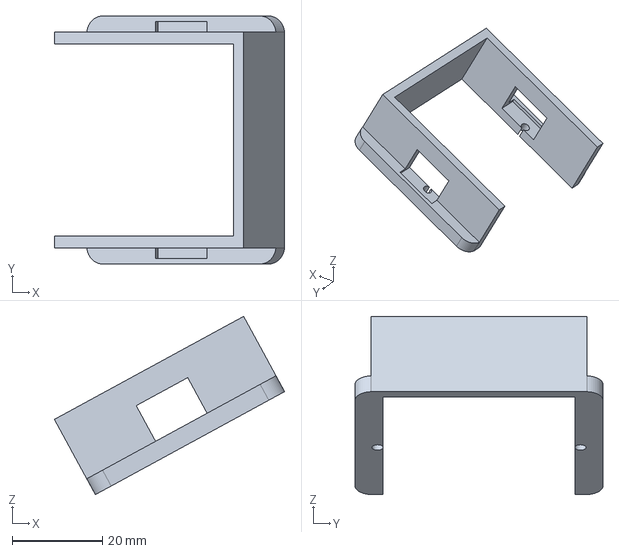
[picture p88: CAD file, 2026-11-06]
handumi/hardware/STEP/right/d405_hood.step
51.1 x 55.0 x 39.5 mm
