Pruthvi-Neuracore/The-UMI-no-one-wants-hw/handumi/hardware/STEP/robot/hande_camera_plate.step

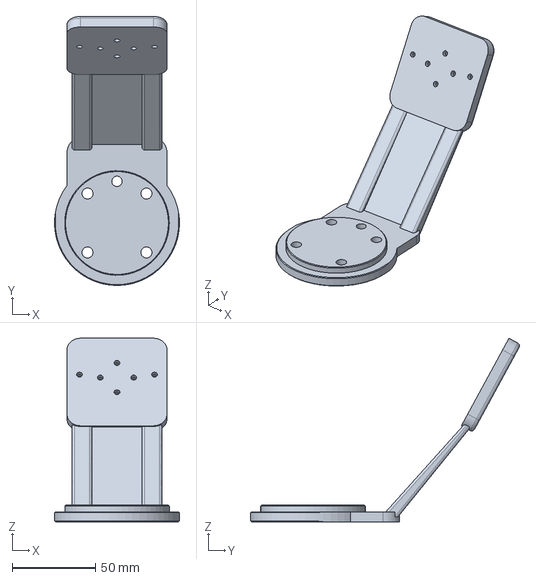
[picture p89: CAD file, 2026-11-06]
handumi/hardware/STEP/robot/hande_camera_plate.step
75.0 x 161.4 x 110.1 mm
