Pruthvi-Neuracore/The-UMI-no-one-wants-hw/handumi/hardware/STL/gripper_tips/Open-ENPIRE/ENPIRE-LEFT-Jaw.stl

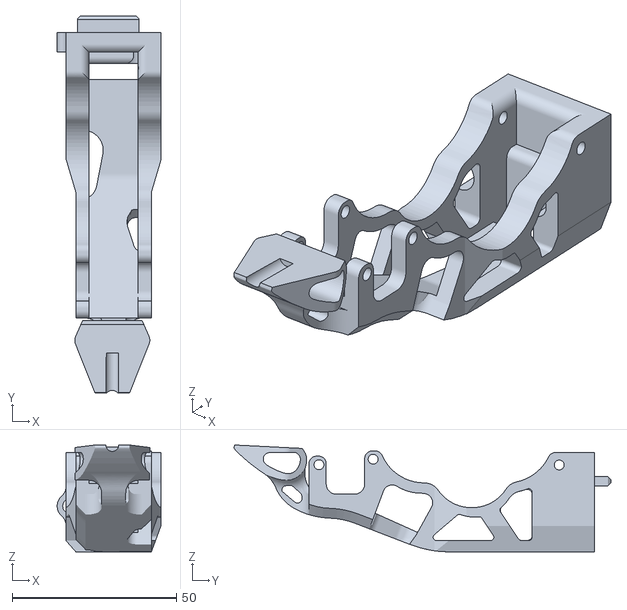
[picture p90: CAD file, 2026-11-05]
handumi/hardware/STL/gripper_tips/Open-ENPIRE/ENPIRE-LEFT-Jaw.stl
31.6 x 114.9 x 32.6
