Pruthvi-Neuracore/The-UMI-no-one-wants-hw/handumi/hardware/STL/gripper_tips/OpenArm/OpenArm-LEFT-Soft.stl

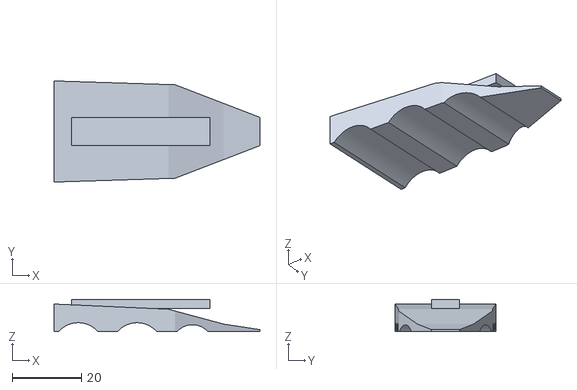
[picture p91: CAD file, 2026-11-05]
handumi/hardware/STL/gripper_tips/OpenArm/OpenArm-LEFT-Soft.stl
59.5 x 29.2 x 9.36
