Pruthvi-Neuracore/The-UMI-no-one-wants-hw/handumi/hardware/STL/gripper_tips/Robotiq-Hand-E/Hand-E-Finger.stl

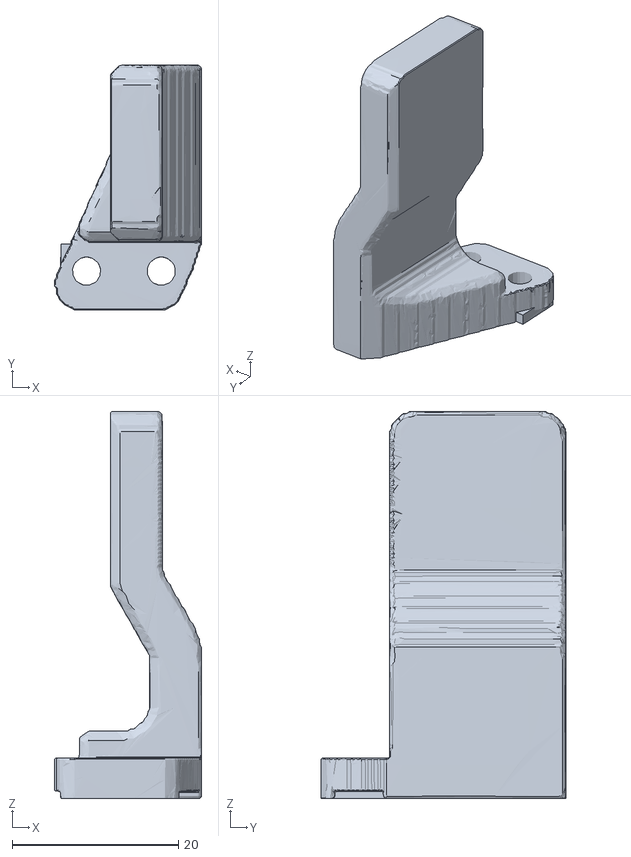
[picture p92: CAD file, 2026-11-05]
handumi/hardware/STL/gripper_tips/Robotiq-Hand-E/Hand-E-Finger.stl
17.8 x 29.5 x 46.6
