Pruthvi-Neuracore/The-UMI-no-one-wants-hw/handumi/hardware/STL/left/left_thumb_link.stl

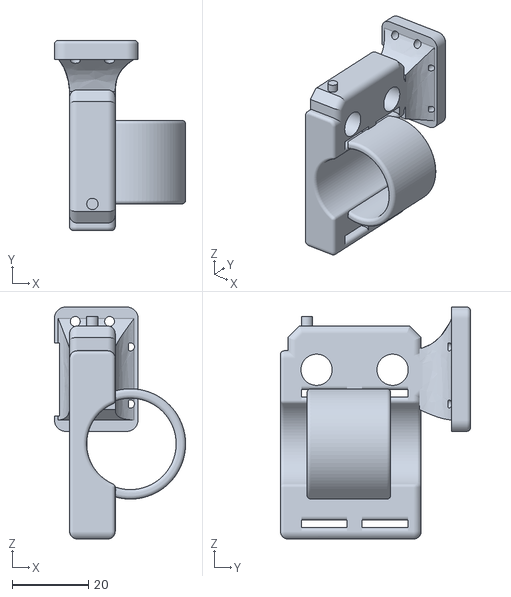
[picture p93: CAD file, 2026-11-05]
handumi/hardware/STL/left/left_thumb_link.stl
34.5 x 50.0 x 61.0
