Pruthvi-Neuracore/The-UMI-no-one-wants-hw/pg-chopstick/d405/chop-umi/assembly/chop-umi_right.stl

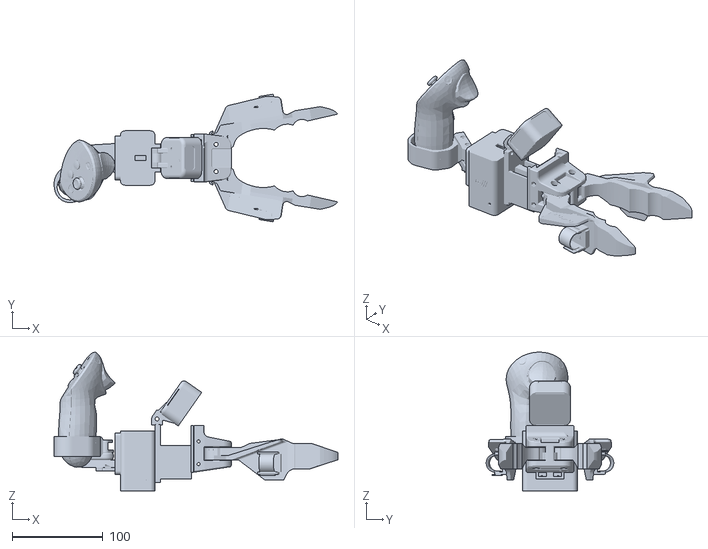
[picture p94: CAD file, 2026-11-05]
pg-chopstick/d405/chop-umi/assembly/chop-umi_right.stl
312.6 x 140.5 x 152.8
