Pruthvi-Neuracore/The-UMI-no-one-wants-hw/pg-chopstick/d405/chop-umi/STEP/jaw_left_dc_button.step

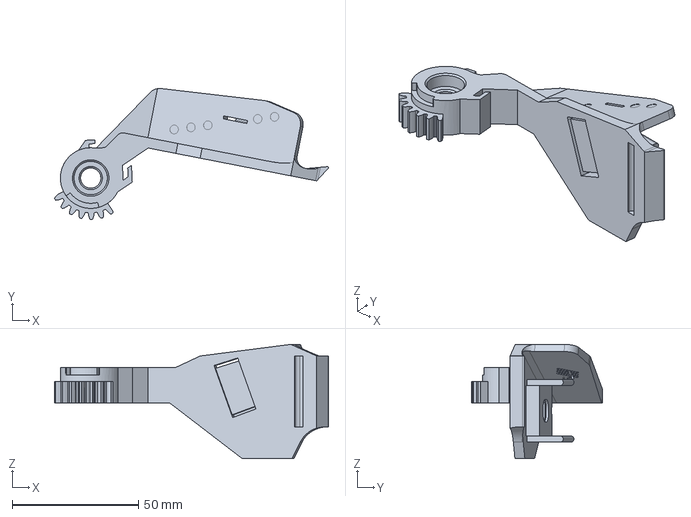
[picture p95: CAD file, 2026-10-13]
pg-chopstick/d405/chop-umi/STEP/jaw_left_dc_button.step
108.3 x 51.8 x 45.2 mm
