Pruthvi-Neuracore/The-UMI-no-one-wants-hw/pg-chopstick/d405/chop-umi/STL/d405_cup.stl

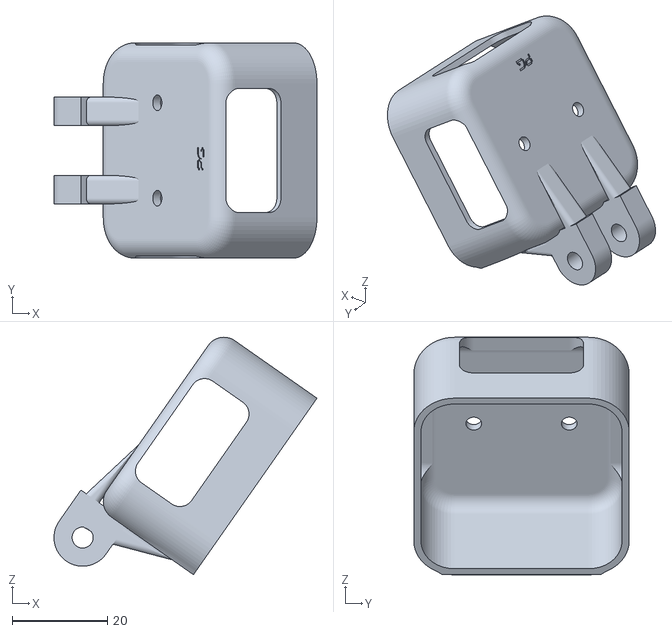
[picture p96: CAD file, 2026-10-13]
pg-chopstick/d405/chop-umi/STL/d405_cup.stl
55.1 x 45.1 x 49.8
