Pruthvi-Neuracore/The-UMI-no-one-wants-hw/pg-chopstick/d405/chop-umi/urdf/meshes/quest_controller_envelope_left.stl

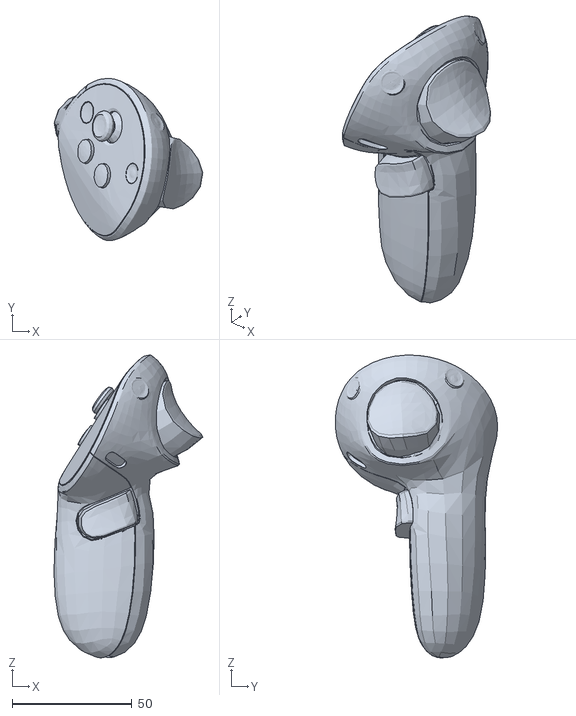
[picture p97: CAD file, 2026-11-05]
pg-chopstick/d405/chop-umi/urdf/meshes/quest_controller_envelope_left.stl
62.2 x 67.9 x 126.8
