Pruthvi-Neuracore/The-UMI-no-one-wants-hw/pg-chopstick/d405/chopstick/assembly/chopstick_openarm.stl

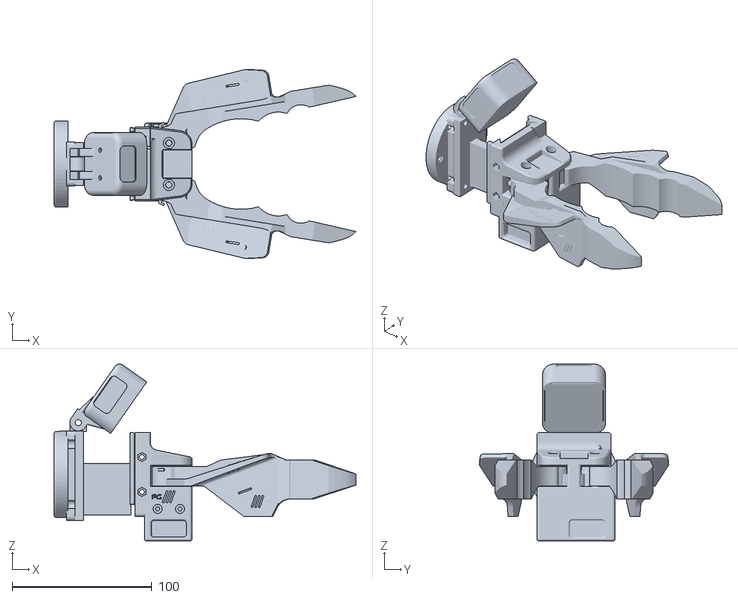
[picture p98: CAD file, 2026-10-13]
pg-chopstick/d405/chopstick/assembly/chopstick_openarm.stl
216.5 x 135.7 x 126.9
