Pruthvi-Neuracore/The-UMI-no-one-wants-hw/pg-chopstick/d405/hand/STEP/d405_frame_hand.step

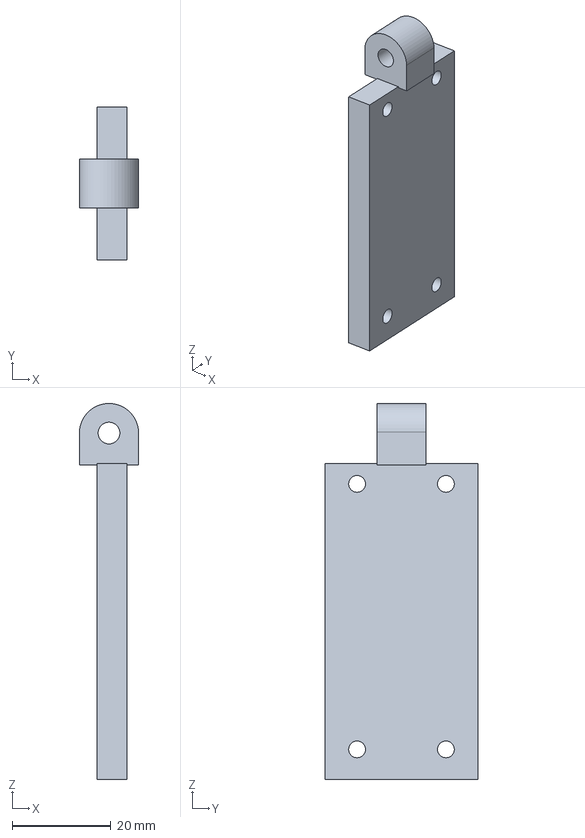
[picture p99: CAD file, 2026-10-13]
pg-chopstick/d405/hand/STEP/d405_frame_hand.step
12.0 x 31.0 x 76.2 mm
