Pruthvi-Neuracore/The-UMI-no-one-wants-hw/pg-chopstick/d405/hand/STL/quest_support_right.stl

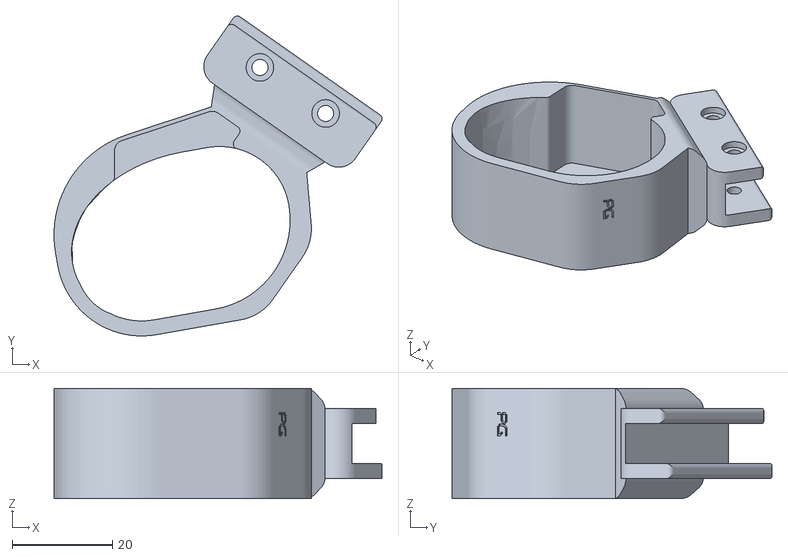
[picture p100: CAD file, 2026-10-13]
pg-chopstick/d405/hand/STL/quest_support_right.stl
65.4 x 63.8 x 22.0
