Pruthvi-Neuracore/The-UMI-no-one-wants-hw/pg-chopstick/d405/para-umi/assembly/para-umi_right_agilex-piper.stl

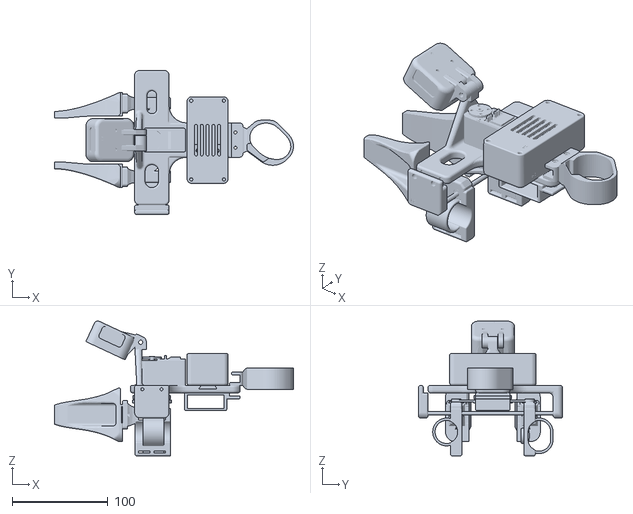
[picture p101: CAD file, 2026-10-13]
pg-chopstick/d405/para-umi/assembly/para-umi_right_agilex-piper.stl
249.0 x 150.0 x 140.6
