Pruthvi-Neuracore/The-UMI-no-one-wants-hw/pg-chopstick/d405/para-umi/STEP/robot/camera_post_piper.step

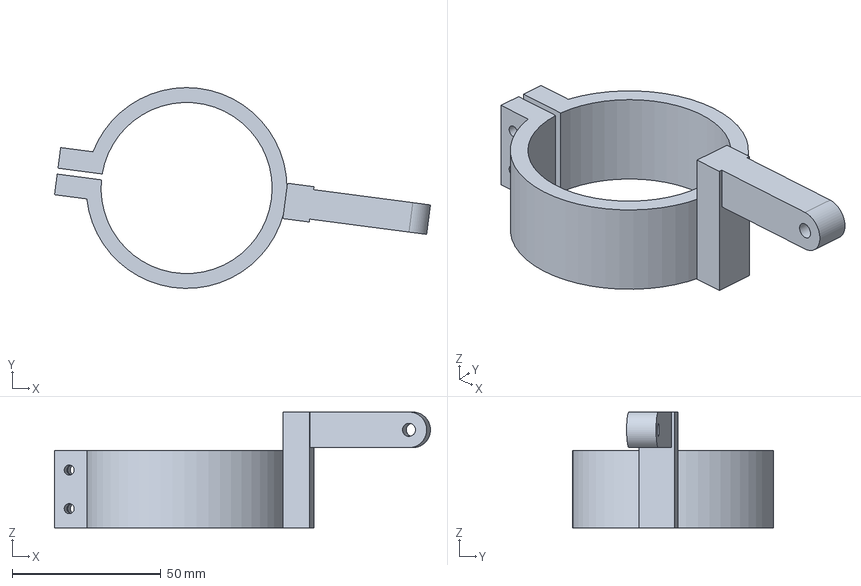
[picture p102: CAD file, 2026-10-13]
pg-chopstick/d405/para-umi/STEP/robot/camera_post_piper.step
126.6 x 67.6 x 39.0 mm
