Pruthvi-Neuracore/The-UMI-no-one-wants-hw/pg-chopstick/d405/para-umi/STL/gripper_tips/Open-ENPIRE/robot/OpenArm_Hard.stl

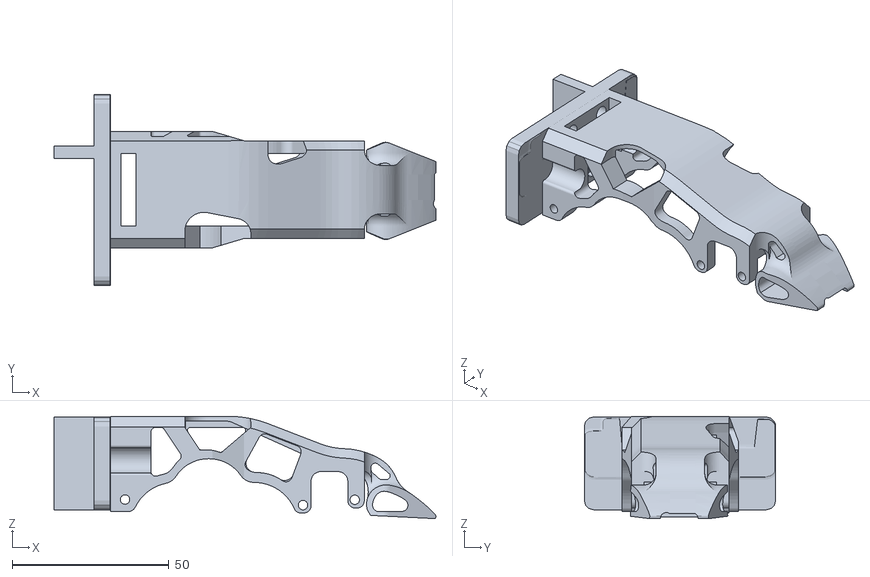
[picture p103: CAD file, 2026-10-13]
pg-chopstick/d405/para-umi/STL/gripper_tips/Open-ENPIRE/robot/OpenArm_Hard.stl
121.7 x 61.0 x 32.6
