Pruthvi-Neuracore/The-UMI-no-one-wants-hw/pg-chopstick/d405/parallel/STEP/left/left_index_middle_finger_link.step

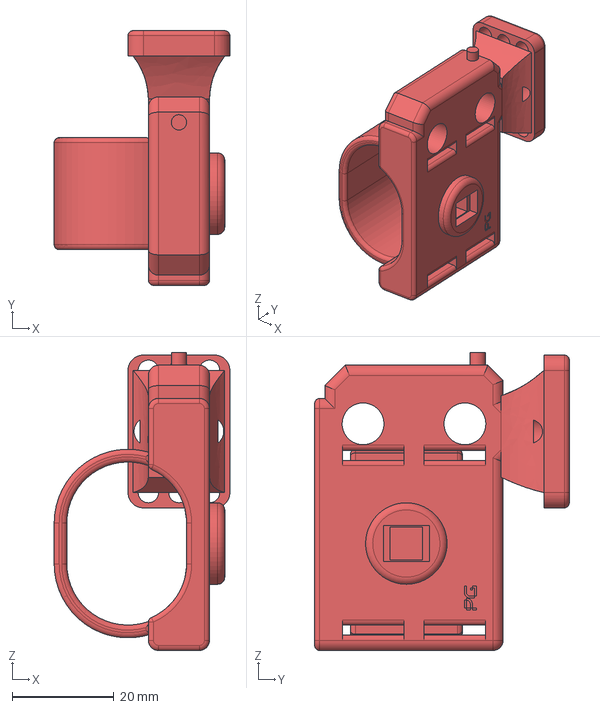
[picture p104: CAD file, 2026-10-13]
pg-chopstick/d405/parallel/STEP/left/left_index_middle_finger_link.step
34.5 x 50.0 x 58.5 mm
