Pruthvi-Neuracore/The-UMI-no-one-wants-hw/pg-chopstick/insta360_x5/chop-umi/STEP/x5_frame.step

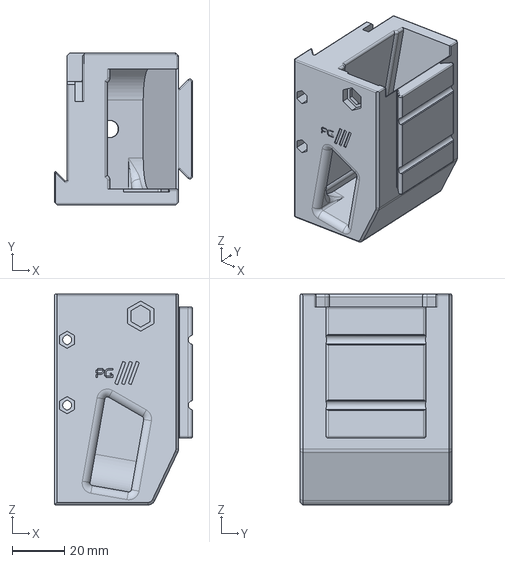
[picture p105: CAD file, 2026-10-13]
pg-chopstick/insta360_x5/chop-umi/STEP/x5_frame.step
52.8 x 58.0 x 80.7 mm
