Pruthvi-Neuracore/The-UMI-no-one-wants-hw/pg-chopstick/insta360_x5/chop-umi/urdf/meshes/jaw_right_jawframe.stl

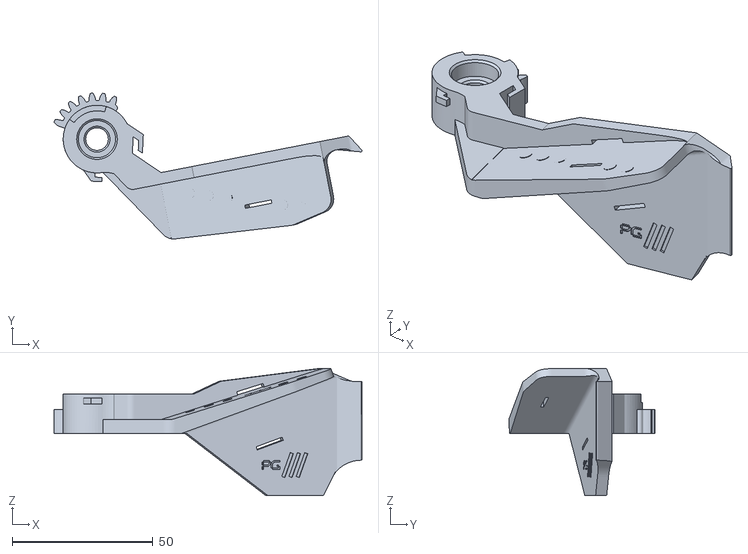
[picture p106: CAD file, 2026-10-13]
pg-chopstick/insta360_x5/chop-umi/urdf/meshes/jaw_right_jawframe.stl
109.3 x 51.8 x 45.2
