Pruthvi-Neuracore/The-UMI-no-one-wants-hw/pg-chopstick/insta360_x5/chopstick/assembly/chopstick_iso50.stl

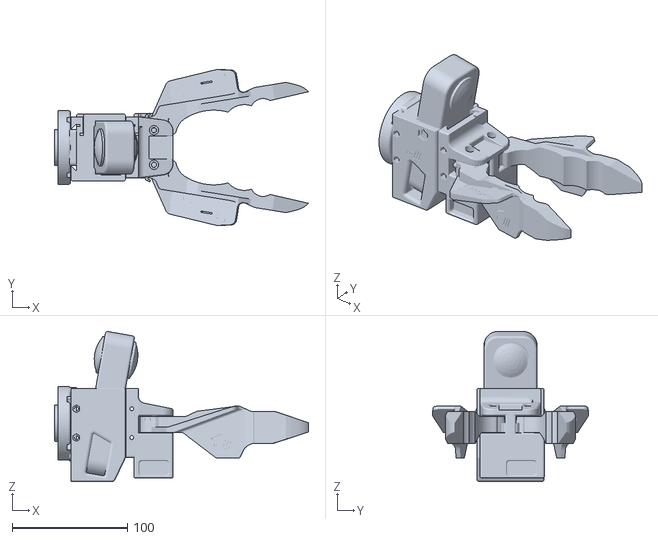
[picture p107: CAD file, 2026-10-13]
pg-chopstick/insta360_x5/chopstick/assembly/chopstick_iso50.stl
220.5 x 135.7 x 130.2
