Pruthvi-Neuracore/The-UMI-no-one-wants-hw/pg-chopstick/insta360_x5/chopstick/STEP/pg_pod_lid.step

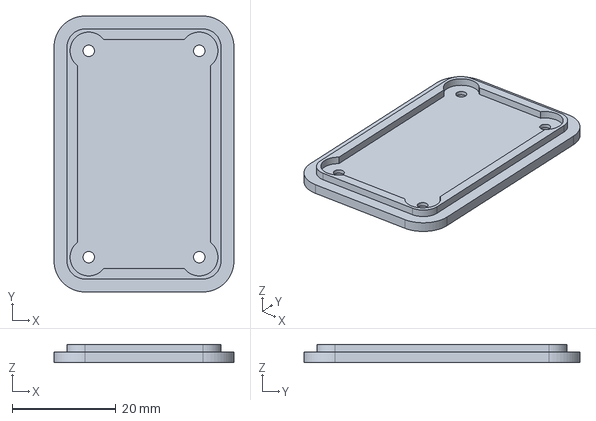
[picture p108: CAD file, 2026-10-13]
pg-chopstick/insta360_x5/chopstick/STEP/pg_pod_lid.step
34.7 x 53.2 x 3.50 mm
