Pruthvi-Neuracore/The-UMI-no-one-wants-hw/pg-chopstick/insta360_x5/chopstick/STL/jaw_right_dc_dots.stl

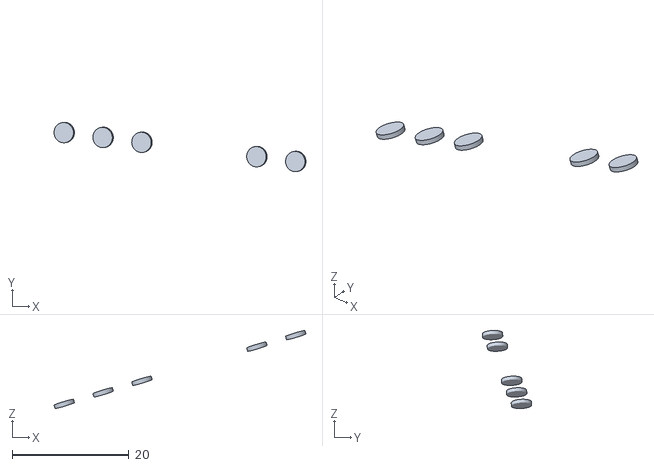
[picture p109: CAD file, 2026-10-13]
pg-chopstick/insta360_x5/chopstick/STL/jaw_right_dc_dots.stl
43.2 x 8.48 x 13.4
