Pruthvi-Neuracore/The-UMI-no-one-wants-hw/pg-chopstick/insta360_x5/chopstick/urdf/meshes/openarm_adapter.stl

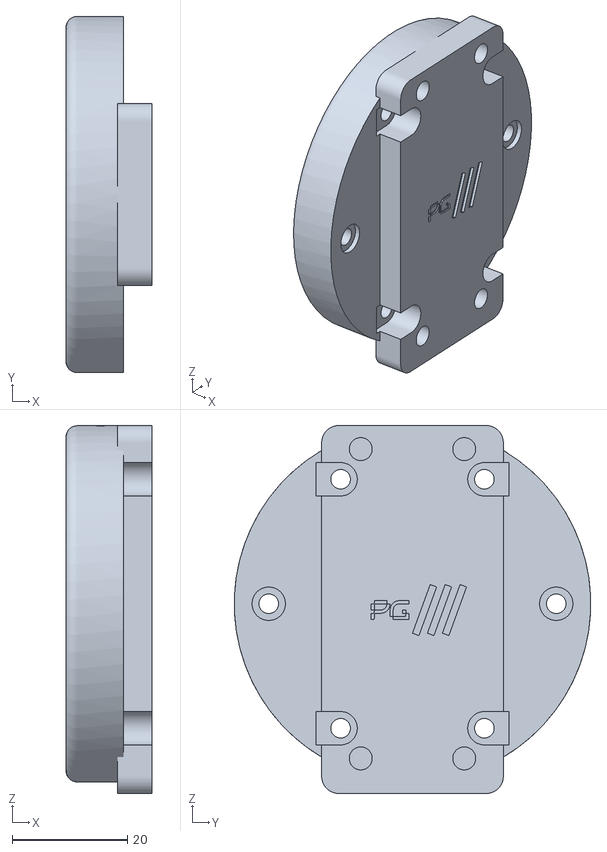
[picture p110: CAD file, 2026-10-13]
pg-chopstick/insta360_x5/chopstick/urdf/meshes/openarm_adapter.stl
15.0 x 62.0 x 64.0
