Pruthvi-Neuracore/The-UMI-no-one-wants-hw/pg-chopstick/insta360_x5/hand/STL/palm_button.stl

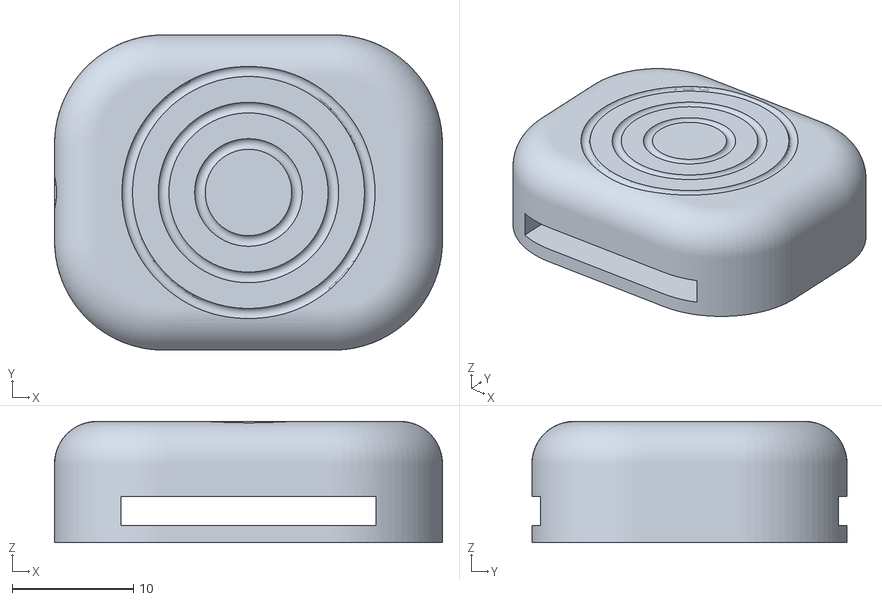
[picture p111: CAD file, 2026-10-13]
pg-chopstick/insta360_x5/hand/STL/palm_button.stl
32.0 x 26.0 x 10.0
