Pruthvi-Neuracore/The-UMI-no-one-wants-hw/pg-chopstick/insta360_x5/para-umi/STEP/left/left_controller_support.step

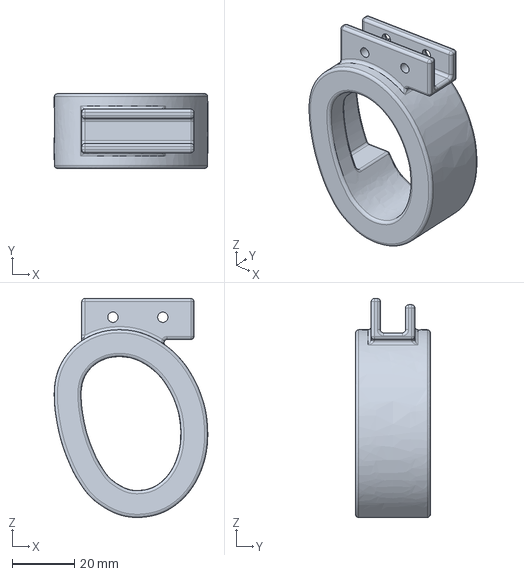
[picture p113: CAD file, 2026-10-13]
pg-chopstick/insta360_x5/para-umi/STEP/left/left_controller_support.step
49.2 x 24.0 x 70.2 mm
