Pruthvi-Neuracore/The-UMI-no-one-wants-hw/pg-chopstick/insta360_x5/parallel/assembly/x5_parallel_right_open-enpire.stl

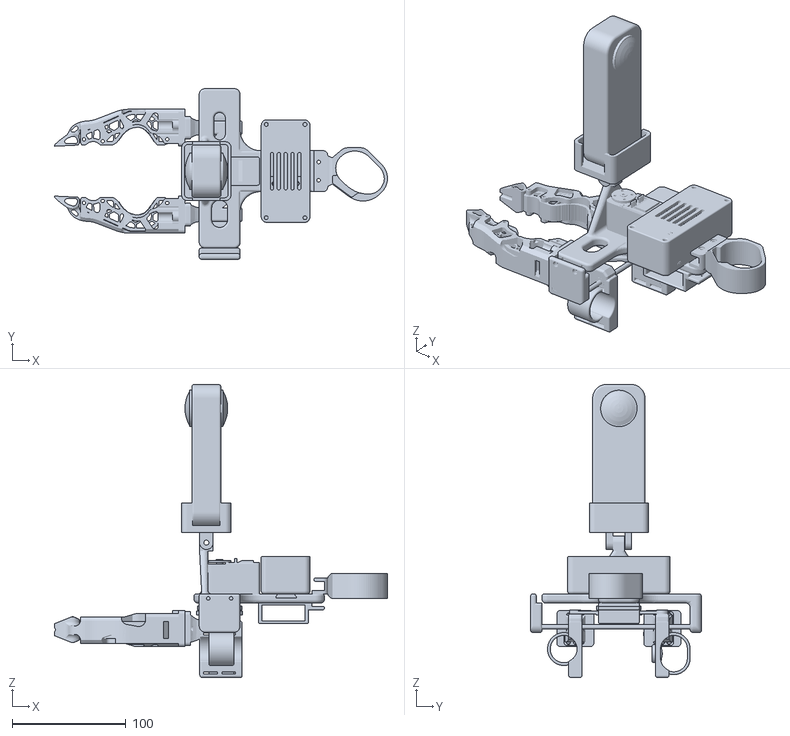
[picture p114: CAD file, 2026-10-13]
pg-chopstick/insta360_x5/parallel/assembly/x5_parallel_right_open-enpire.stl
292.6 x 150.0 x 257.5
