Pruthvi-Neuracore/The-UMI-no-one-wants-hw/scissor-umi/2f-140/STEP/tab_mast.step

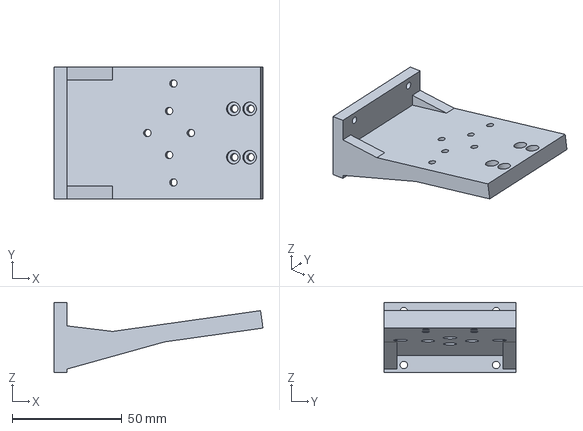
[picture p115: CAD file, 2026-11-05]
scissor-umi/2f-140/STEP/tab_mast.step
95.0 x 60.0 x 32.0 mm
