Pruthvi-Neuracore/The-UMI-no-one-wants-hw/scissor-umi/2f-85/STEP/inner_knuckle_2f85.step

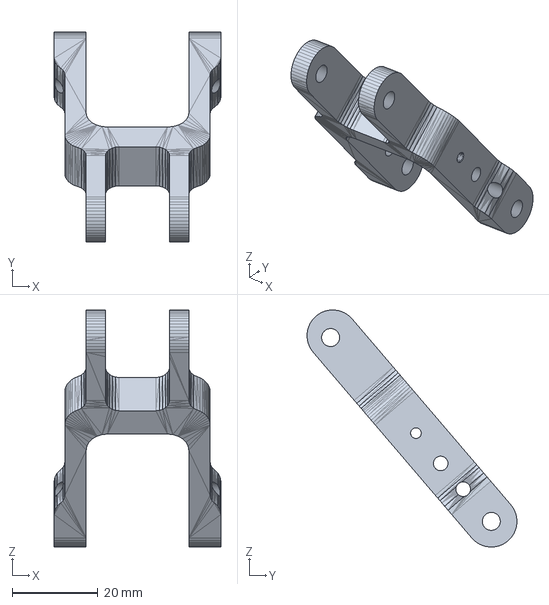
[picture p116: CAD file, 2026-11-05]
scissor-umi/2f-85/STEP/inner_knuckle_2f85.step
39.0 x 49.1 x 55.4 mm
