Pruthvi-Neuracore/The-UMI-no-one-wants-hw/assembly/d405/chopstick/STEP/chopstick_base_sa.step

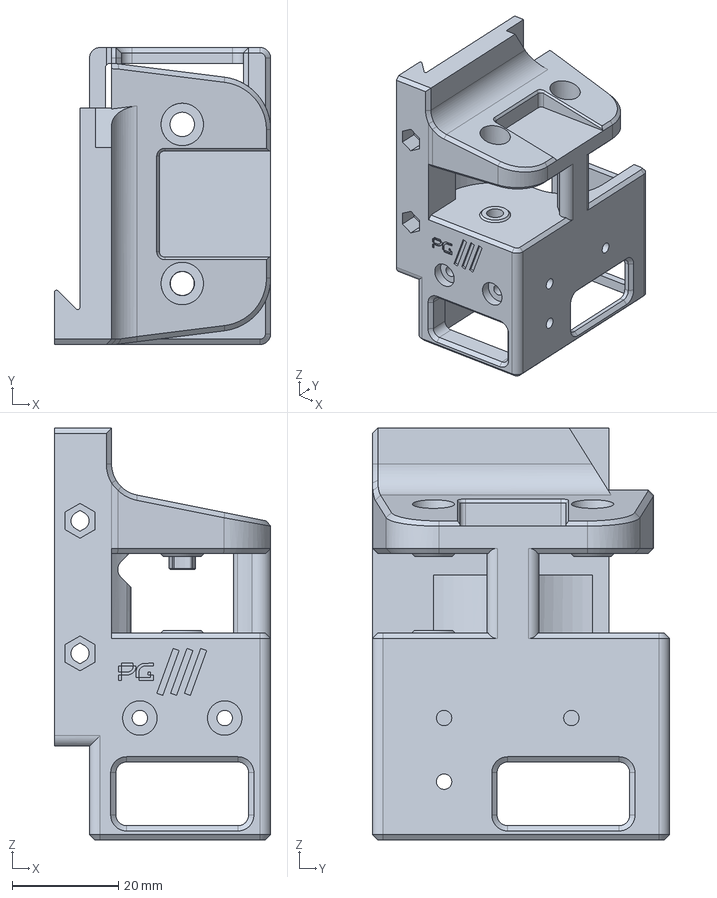
[picture p117: CAD file, 2026-10-12]
assembly/d405/chopstick/STEP/chopstick_base_sa.step
40.8 x 56.0 x 77.7 mm
