Pruthvi-Neuracore/The-UMI-no-one-wants-hw/assembly/d405/hand/STEP/ebox_wrist_saddle.step

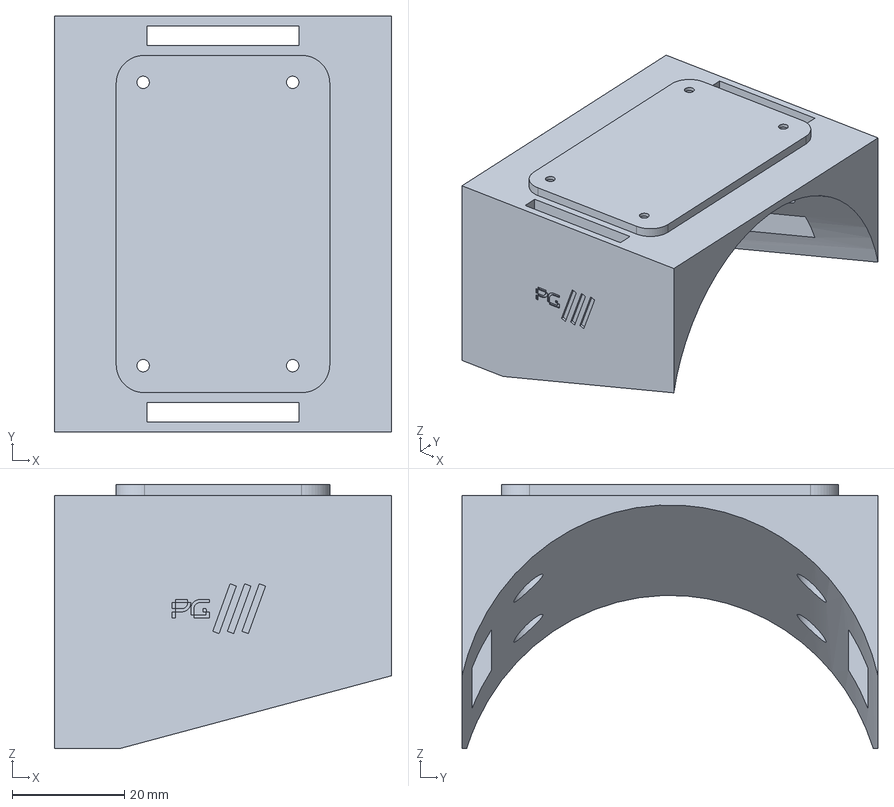
[picture p118: CAD file, 2026-10-12]
assembly/d405/hand/STEP/ebox_wrist_saddle.step
60.0 x 74.0 x 47.0 mm
