Pruthvi-Neuracore/The-UMI-no-one-wants-hw/assembly/d405/parallel/assembly/parallel_openarm.stl

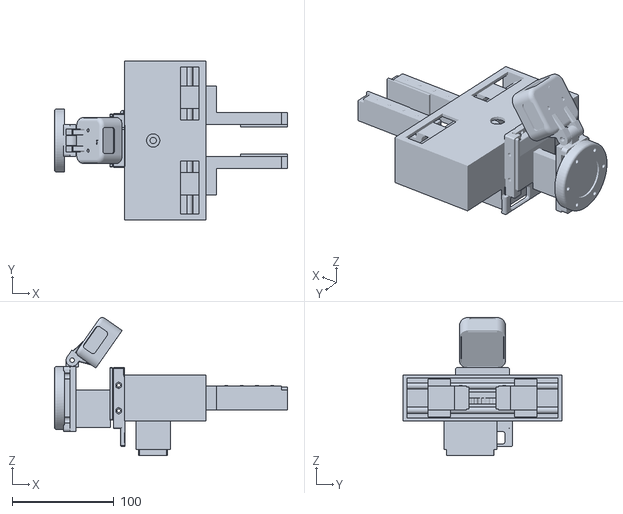
[picture p119: CAD file, 2026-10-12]
assembly/d405/parallel/assembly/parallel_openarm.stl
229.0 x 156.0 x 135.7
