Pruthvi-Neuracore/The-UMI-no-one-wants-hw/assembly/d405/parallel/STEP/parallel_carriage_left.step

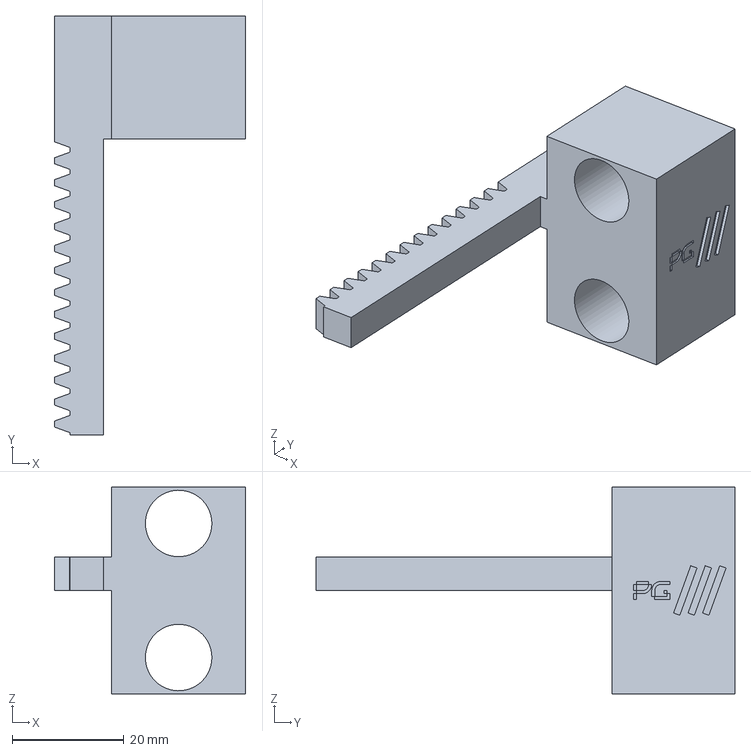
[picture p120: CAD file, 2026-10-12]
assembly/d405/parallel/STEP/parallel_carriage_left.step
34.2 x 75.0 x 37.0 mm
