Pruthvi-Neuracore/The-UMI-no-one-wants-hw/assembly/d405/parallel/STL/ebox_lid.stl

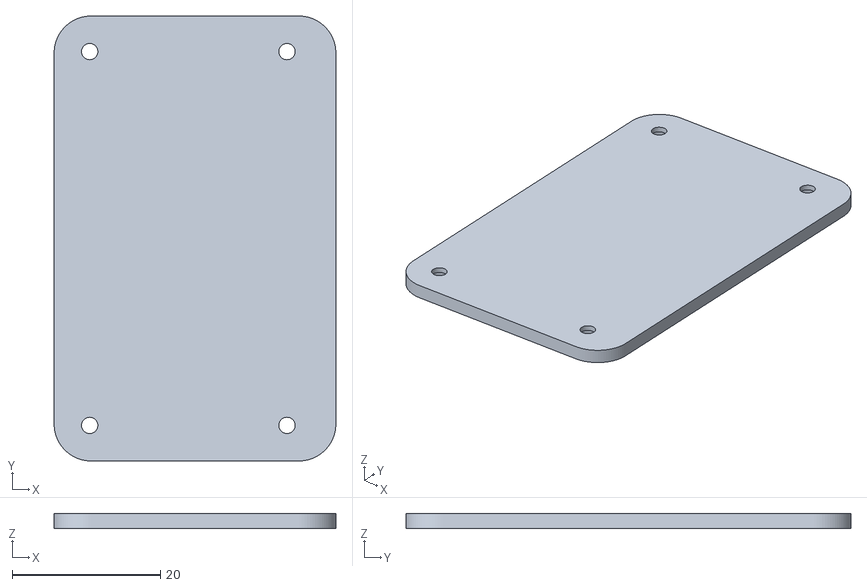
[picture p121: CAD file, 2026-10-12]
assembly/d405/parallel/STL/ebox_lid.stl
38.0 x 60.0 x 2.00
