Pruthvi-Neuracore/The-UMI-no-one-wants-hw/assembly/d405/parallel/urdf/meshes/servo_envelope.stl

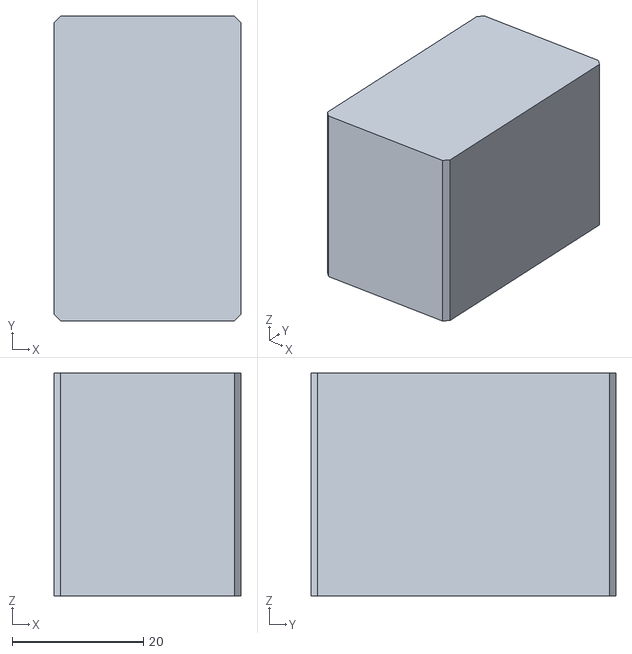
[picture p122: CAD file, 2026-10-12]
assembly/d405/parallel/urdf/meshes/servo_envelope.stl
28.5 x 46.5 x 34.0
