Pruthvi-Neuracore/The-UMI-no-one-wants-hw/assembly/insta360_x5/parallel/assembly/parallel_left.stl

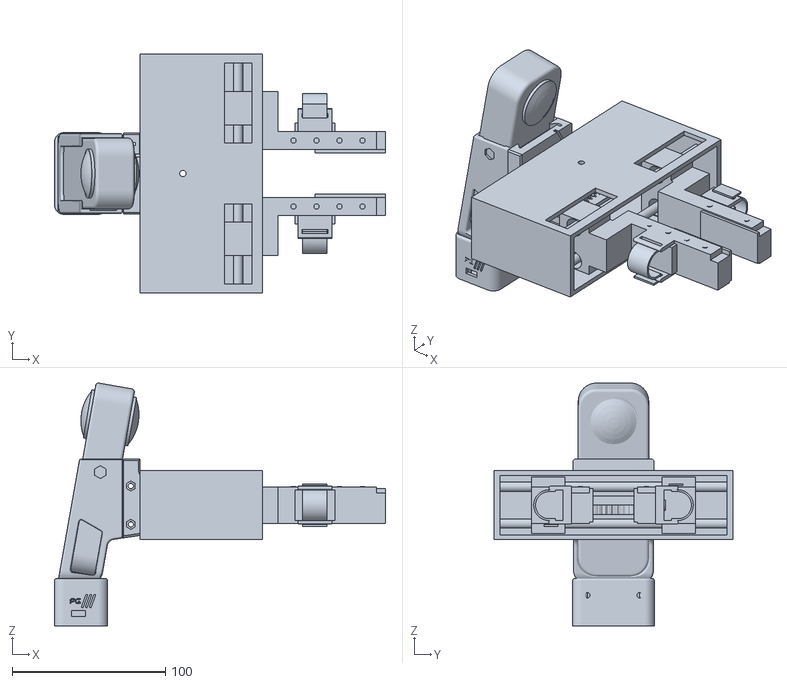
[picture p123: CAD file, 2026-10-12]
assembly/insta360_x5/parallel/assembly/parallel_left.stl
215.7 x 156.0 x 158.3
