Pruthvi-Neuracore/The-UMI-no-one-wants-hw/assembly/insta360_x5/parallel/STEP/parallel_pinion.step

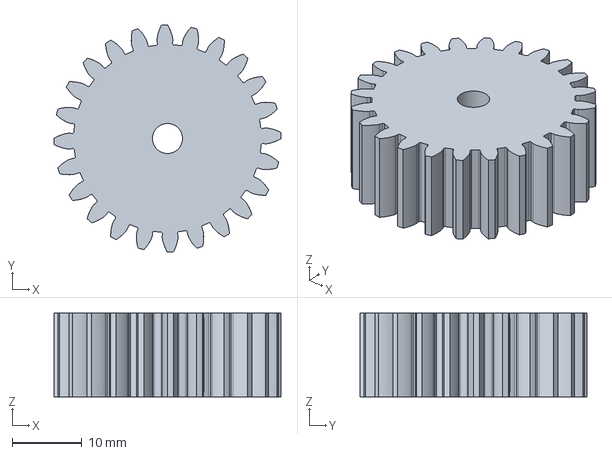
[picture p124: CAD file, 2026-10-12]
assembly/insta360_x5/parallel/STEP/parallel_pinion.step
32.5 x 32.5 x 12.0 mm
