Pruthvi-Neuracore/The-UMI-no-one-wants-hw/handumi/assembly/umi_right_openarm.stl

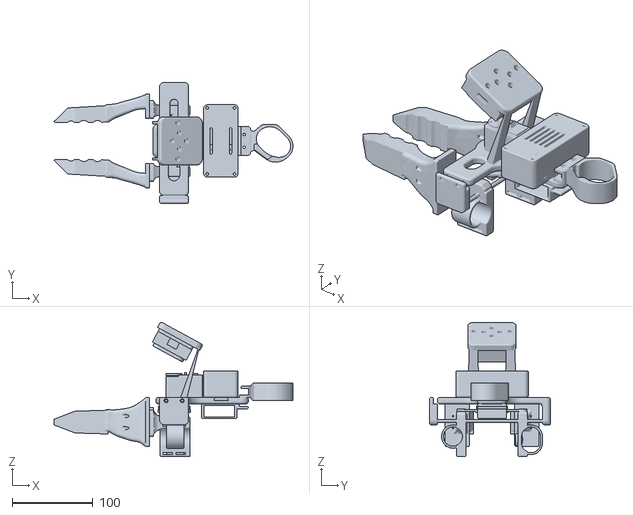
[picture p125: CAD file, 2026-11-06]
handumi/assembly/umi_right_openarm.stl
296.6 x 150.0 x 166.9
