Pruthvi-Neuracore/The-UMI-no-one-wants-hw/handumi/hardware/STEP/right/right_index_middle_finger_link.step

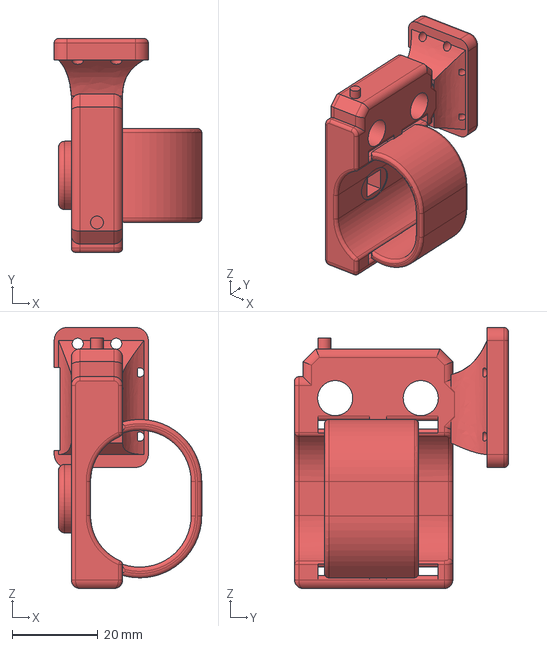
[picture p126: CAD file, 2026-11-05]
handumi/hardware/STEP/right/right_index_middle_finger_link.step
34.5 x 50.0 x 61.0 mm
