Pruthvi-Neuracore/The-UMI-no-one-wants-hw/handumi/hardware/STL/gripper_tips/Robotiq-Hand-E/Hand-E-Rack-Shim.stl

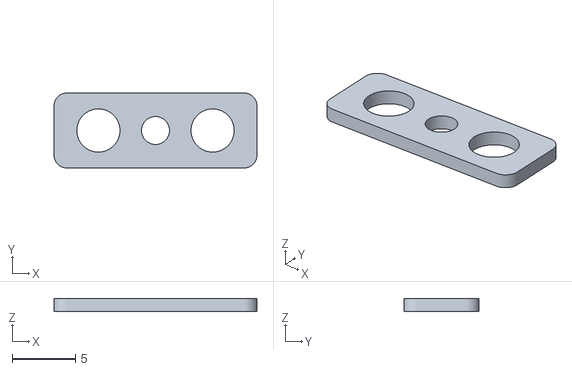
[picture p127: CAD file, 2026-11-05]
handumi/hardware/STL/gripper_tips/Robotiq-Hand-E/Hand-E-Rack-Shim.stl
16.0 x 5.90 x 1.00
