Pruthvi-Neuracore/The-UMI-no-one-wants-hw/handumi/hardware/STL/left/crank_mechanism_plate.stl

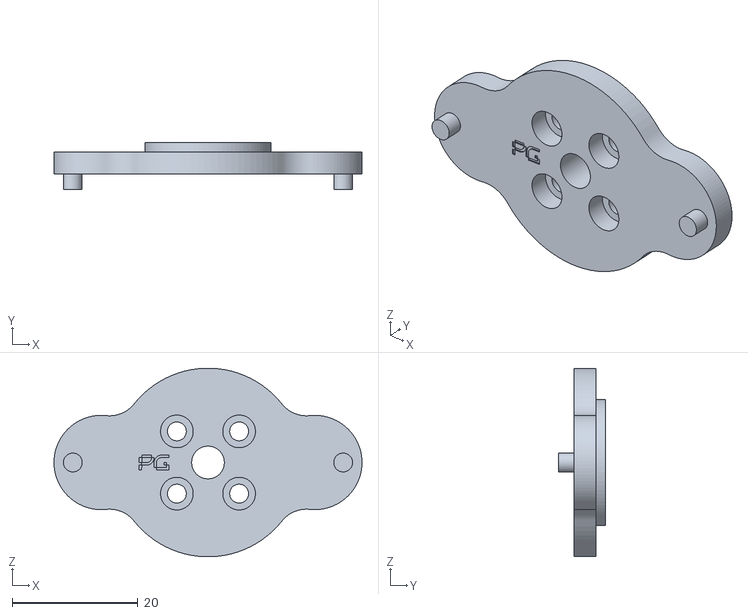
[picture p128: CAD file, 2026-10-13]
handumi/hardware/STL/left/crank_mechanism_plate.stl
49.0 x 7.50 x 30.0
