Pruthvi-Neuracore/The-UMI-no-one-wants-hw/pg-chopstick/d405/chop-umi/STEP/quest_arm_right.step

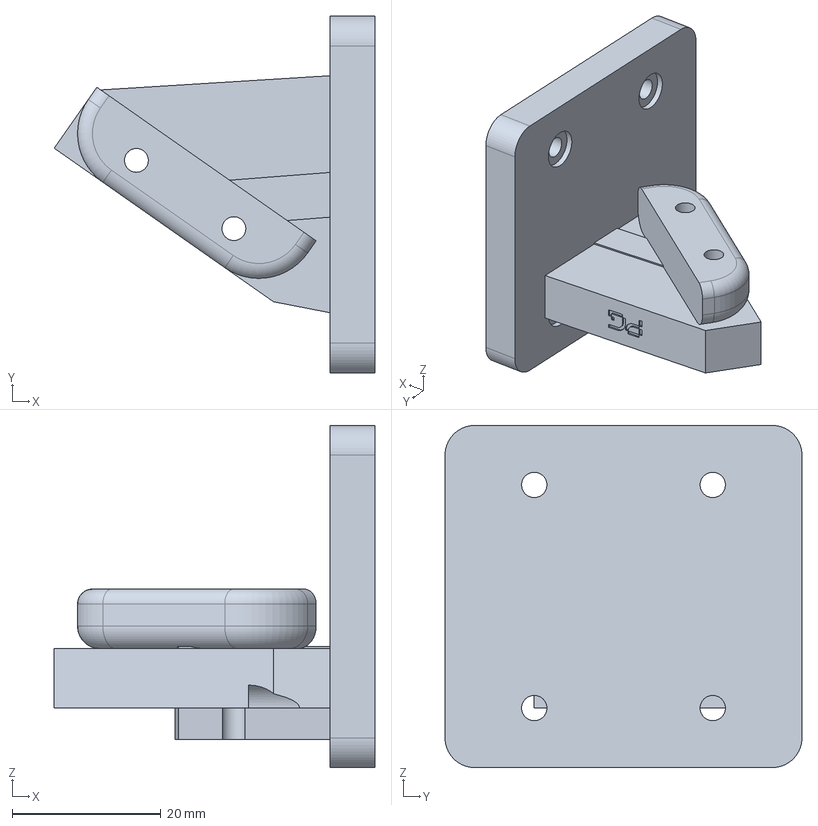
[picture p129: CAD file, 2026-10-13]
pg-chopstick/d405/chop-umi/STEP/quest_arm_right.step
43.1 x 48.0 x 46.0 mm
