Pruthvi-Neuracore/The-UMI-no-one-wants-hw/pg-chopstick/d405/chopstick/STEP/chopstick_clip_sa.step

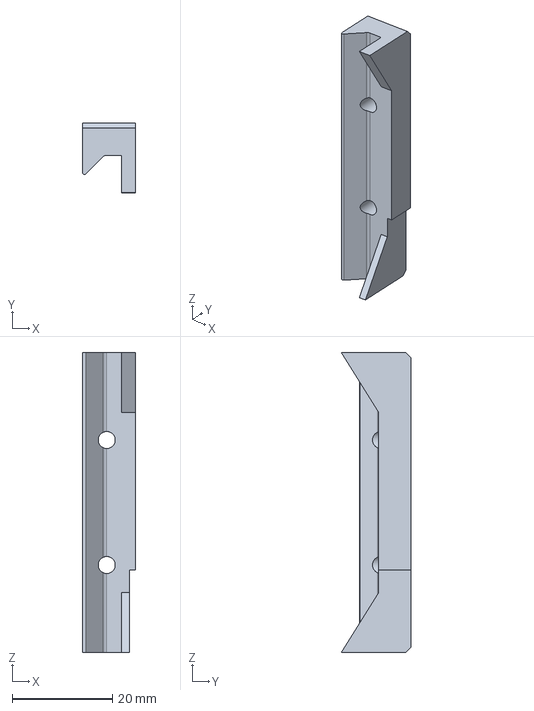
[picture p130: CAD file, 2026-10-13]
pg-chopstick/d405/chopstick/STEP/chopstick_clip_sa.step
10.6 x 13.9 x 60.0 mm
