Pruthvi-Neuracore/The-UMI-no-one-wants-hw/pg-chopstick/d405/parallel/STEP/left/end_cover.step

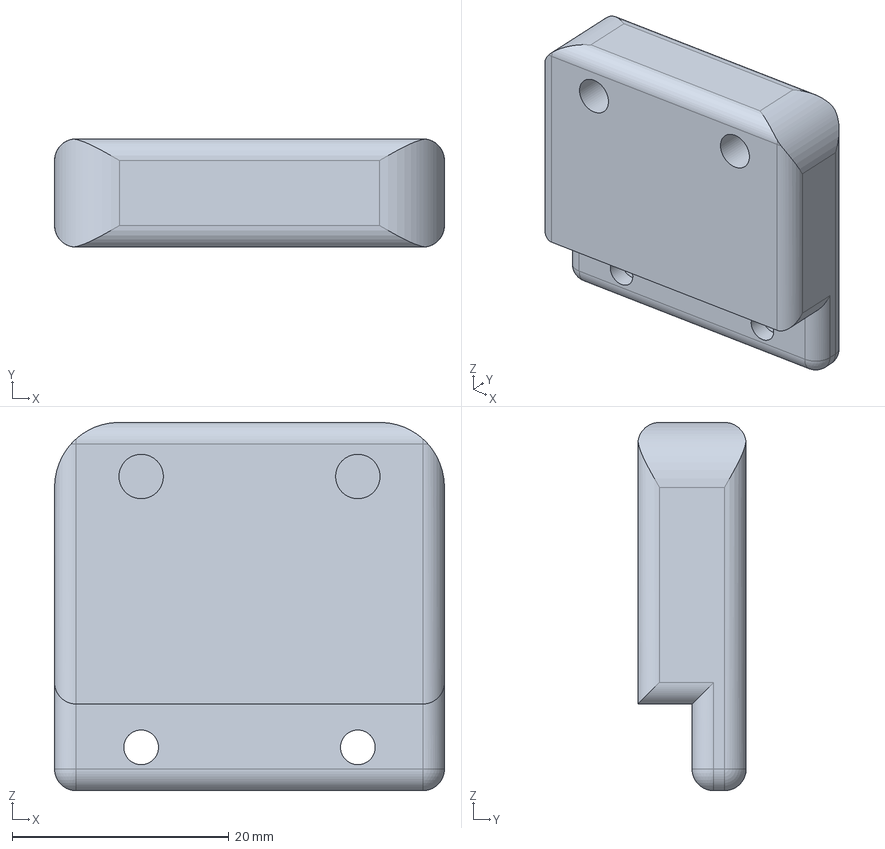
[picture p131: CAD file, 2026-10-13]
pg-chopstick/d405/parallel/STEP/left/end_cover.step
36.0 x 10.0 x 34.0 mm
