Pruthvi-Neuracore/The-UMI-no-one-wants-hw/pg-chopstick/insta360_x5/chop-umi/STEP/x5_lite_frame.step

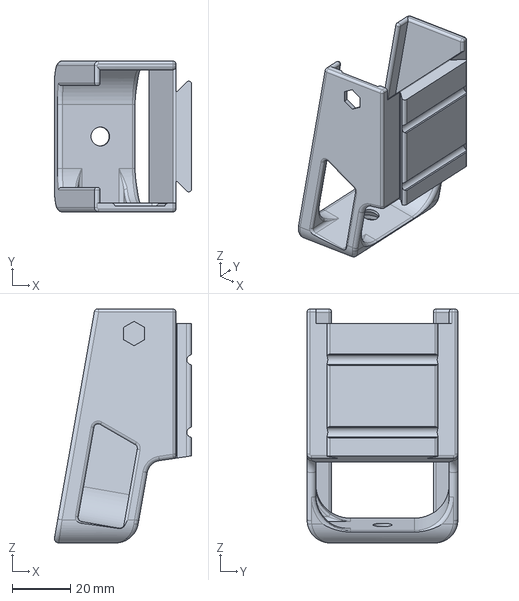
[picture p132: CAD file, 2026-10-13]
pg-chopstick/insta360_x5/chop-umi/STEP/x5_lite_frame.step
47.3 x 52.0 x 80.7 mm
