Pruthvi-Neuracore/The-UMI-no-one-wants-hw/pg-chopstick/insta360_x5/chopstick/STEP/chopstick_base_dc.step

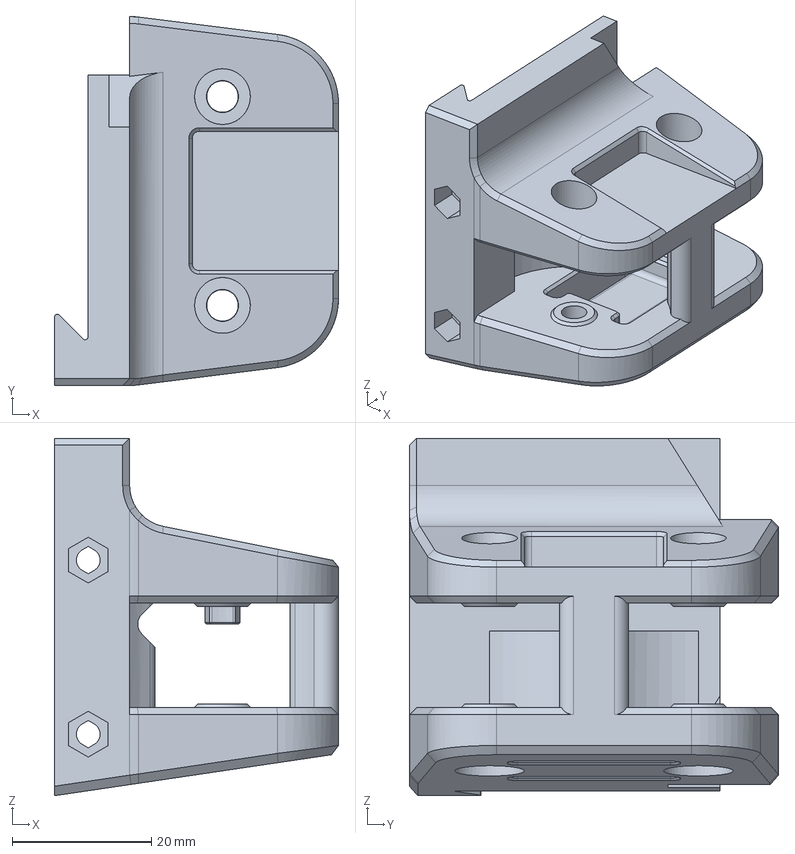
[picture p133: CAD file, 2026-10-13]
pg-chopstick/insta360_x5/chopstick/STEP/chopstick_base_dc.step
40.8 x 53.0 x 51.3 mm
