Pruthvi-Neuracore/The-UMI-no-one-wants-hw/pg-chopstick/insta360_x5/chopstick/urdf/meshes/servo_envelope.stl

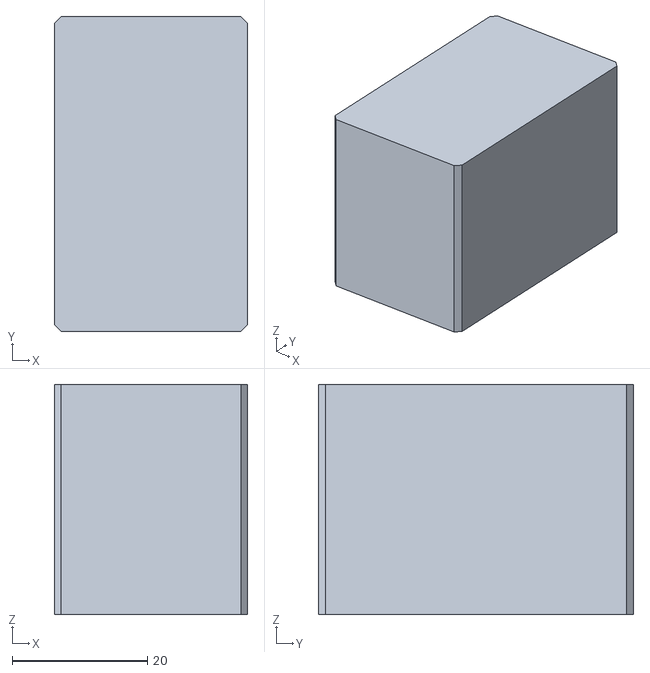
[picture p134: CAD file, 2026-10-13]
pg-chopstick/insta360_x5/chopstick/urdf/meshes/servo_envelope.stl
28.5 x 46.5 x 34.0
