Pruthvi-Neuracore/The-UMI-no-one-wants-hw/scissor-umi/2f-140/STEP/handle_a_lh.step

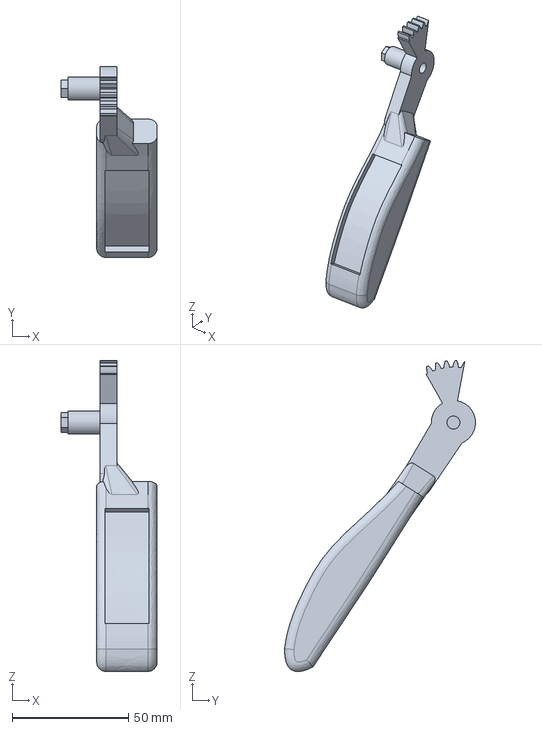
[picture p135: CAD file, 2026-11-05]
scissor-umi/2f-140/STEP/handle_a_lh.step
41.4 x 82.1 x 133.7 mm
