Pruthvi-Neuracore/The-UMI-no-one-wants-hw/scissor-umi/2f-85/STEP/pad_core_2f85.step

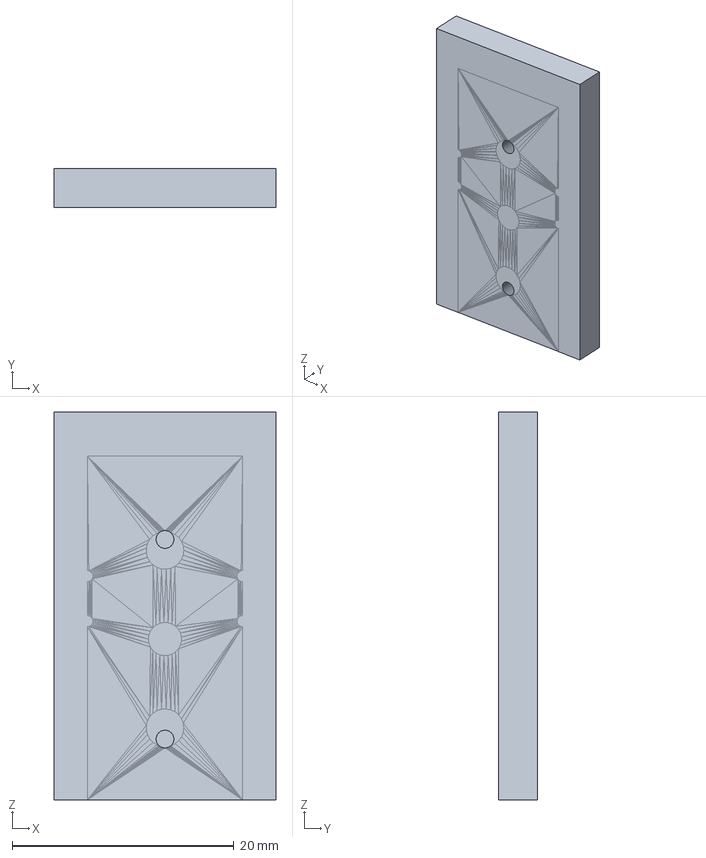
[picture p136: CAD file, 2026-11-05]
scissor-umi/2f-85/STEP/pad_core_2f85.step
20.0 x 3.50 x 35.0 mm
