Pruthvi-Neuracore/The-UMI-no-one-wants-hw/assembly/d405/parallel/STEP/parallel_base_sa.step

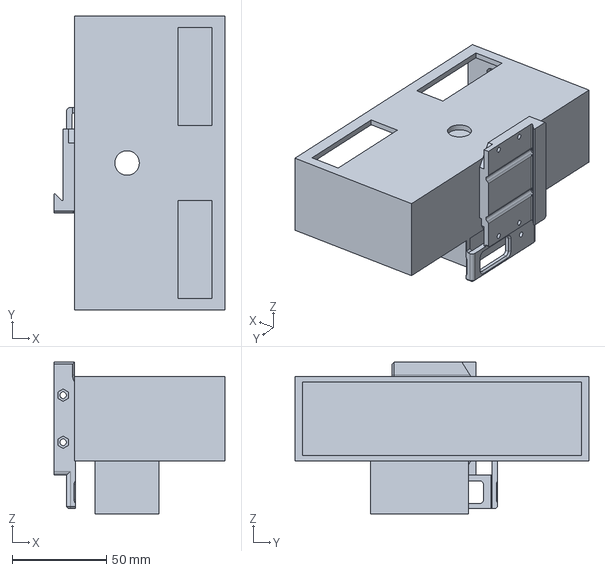
[picture p137: CAD file, 2026-10-12]
assembly/d405/parallel/STEP/parallel_base_sa.step
90.8 x 156.0 x 80.5 mm
