Pruthvi-Neuracore/The-UMI-no-one-wants-hw/assembly/d405/parallel/urdf/meshes/parallel_base_dc.stl

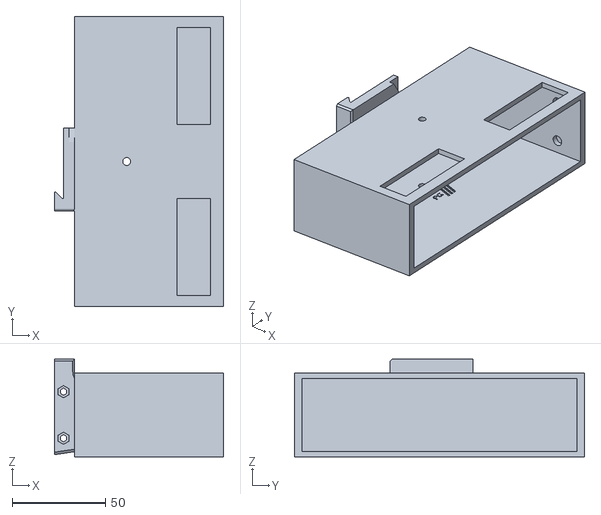
[picture p138: CAD file, 2026-10-12]
assembly/d405/parallel/urdf/meshes/parallel_base_dc.stl
90.8 x 156.0 x 52.5
