Pruthvi-Neuracore/The-UMI-no-one-wants-hw/assembly/insta360_x5/parallel/assembly/parallel_iso50.stl

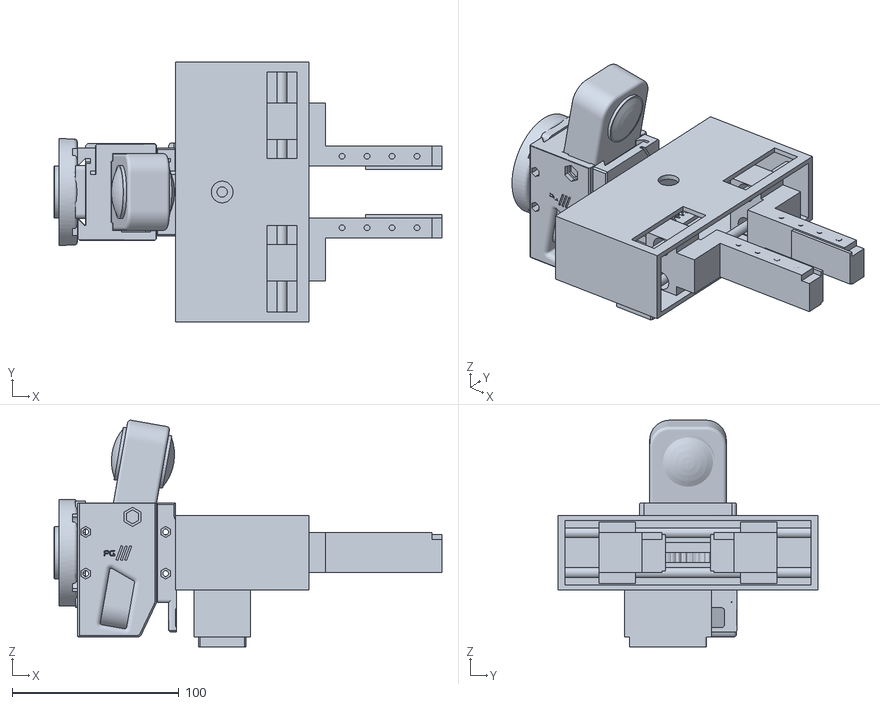
[picture p139: CAD file, 2026-10-12]
assembly/insta360_x5/parallel/assembly/parallel_iso50.stl
233.0 x 156.0 x 136.1
