Pruthvi-Neuracore/The-UMI-no-one-wants-hw/assembly/insta360_x5/parallel/STEP/parallel_button_cover_left.step

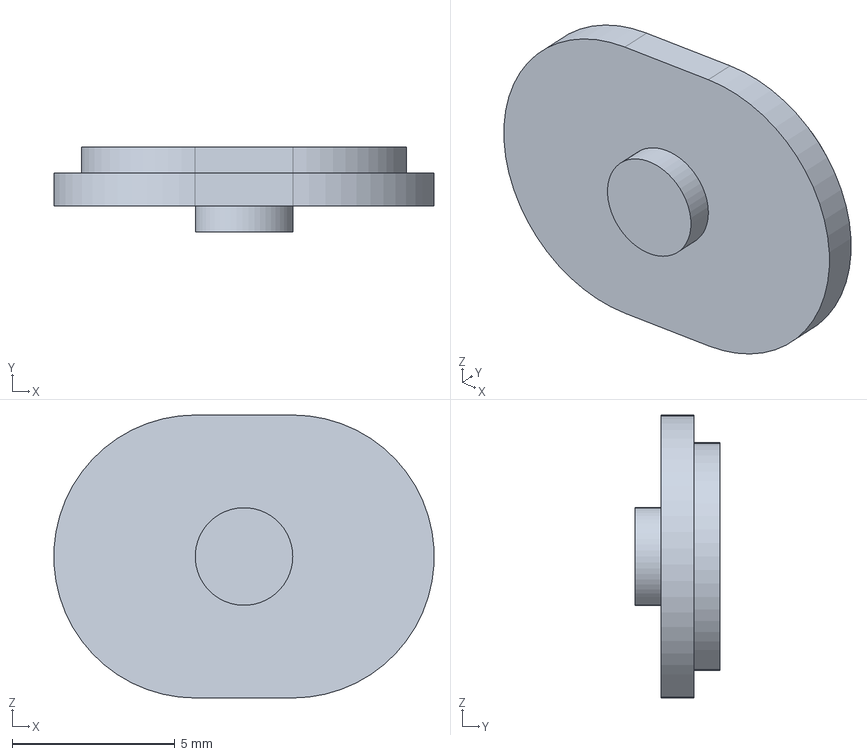
[picture p140: CAD file, 2026-10-12]
assembly/insta360_x5/parallel/STEP/parallel_button_cover_left.step
11.7 x 2.60 x 8.70 mm
