Pruthvi-Neuracore/The-UMI-no-one-wants-hw/handumi/assembly/umi_right_open-enpire.stl

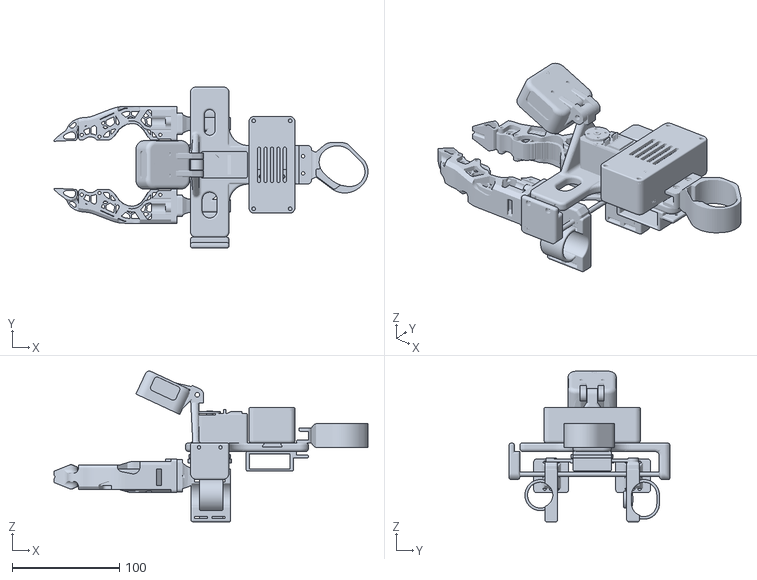
[picture p141: CAD file, 2026-10-13]
handumi/assembly/umi_right_open-enpire.stl
292.6 x 150.0 x 140.6
