Pruthvi-Neuracore/The-UMI-no-one-wants-hw/handumi/hardware/STEP/right/right_controller_support.step

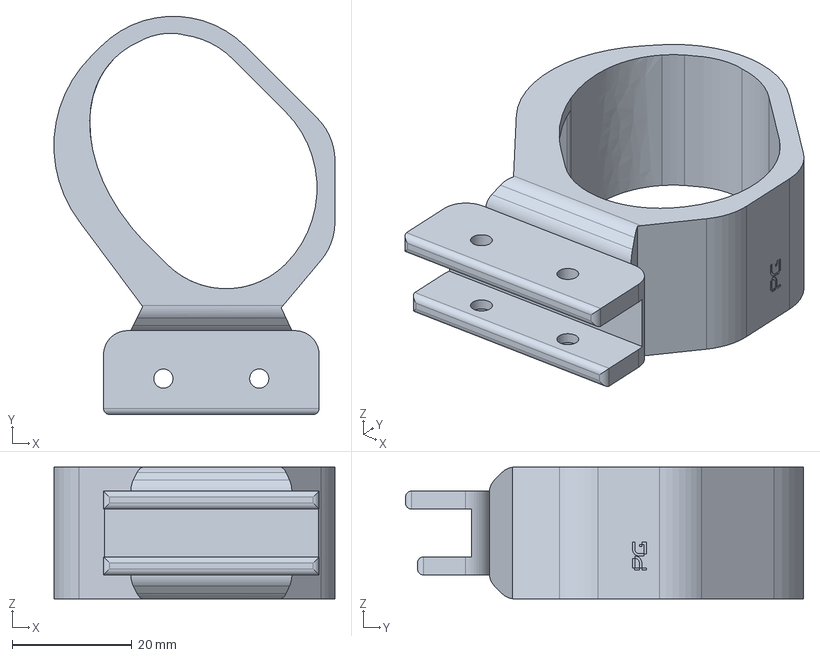
[picture p142: CAD file, 2026-10-13]
handumi/hardware/STEP/right/right_controller_support.step
46.9 x 66.5 x 22.0 mm
