Pruthvi-Neuracore/The-UMI-no-one-wants-hw/handumi/hardware/STL/left/electronics_lid.stl

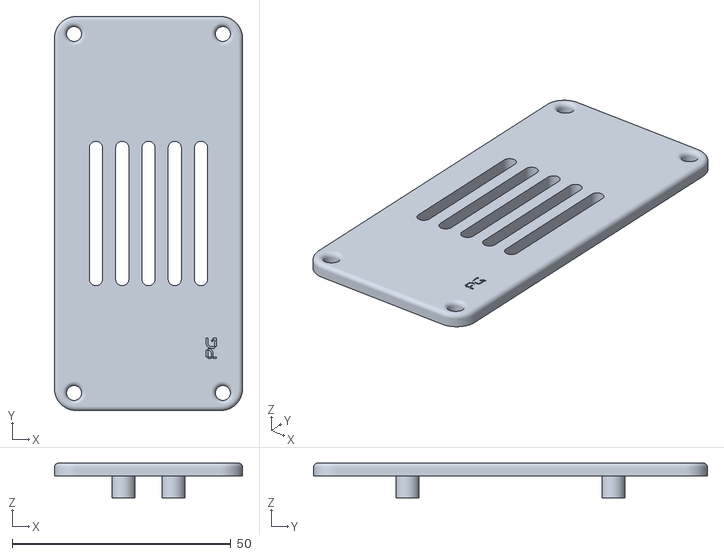
[picture p143: CAD file, 2026-10-13]
handumi/hardware/STL/left/electronics_lid.stl
43.0 x 90.0 x 7.99
