Pruthvi-Neuracore/The-UMI-no-one-wants-hw/pg-chopstick/d405/chopstick/assembly/chopstick_left.stl

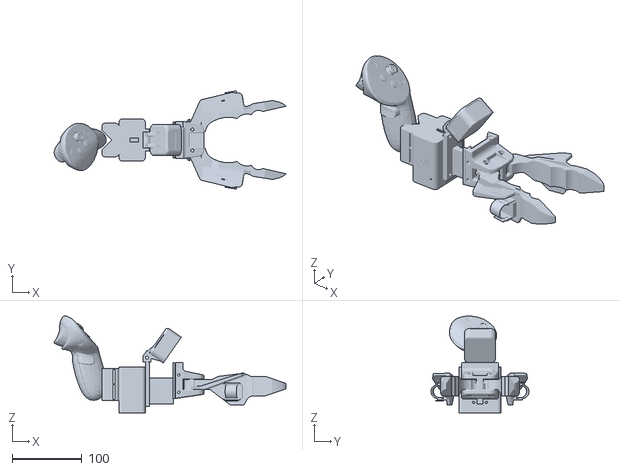
[picture p144: CAD file, 2026-10-13]
pg-chopstick/d405/chopstick/assembly/chopstick_left.stl
332.2 x 140.5 x 138.8
