Pruthvi-Neuracore/The-UMI-no-one-wants-hw/scissor-umi/2f-140/STEP/grip_tpu_a_rh.step

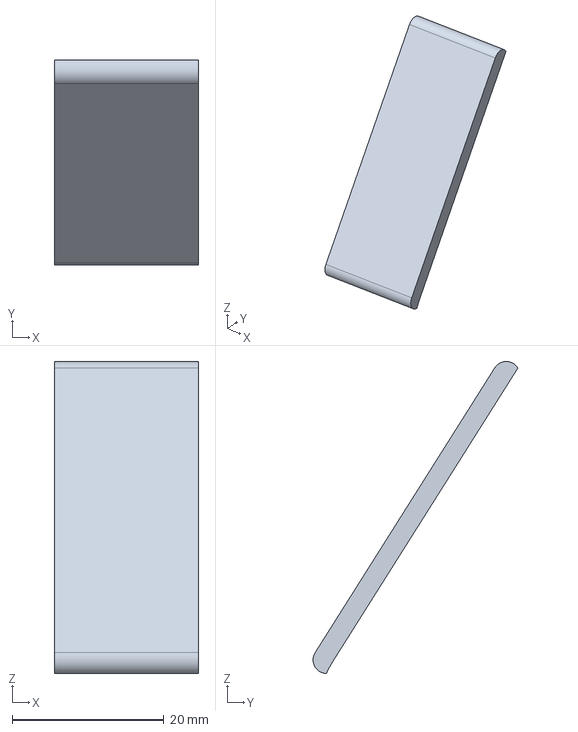
[picture p145: CAD file, 2026-11-05]
scissor-umi/2f-140/STEP/grip_tpu_a_rh.step
19.0 x 27.0 x 41.2 mm
