Pruthvi-Neuracore/The-UMI-no-one-wants-hw/scissor-umi/2f-85/STEP/servo_coupler.step

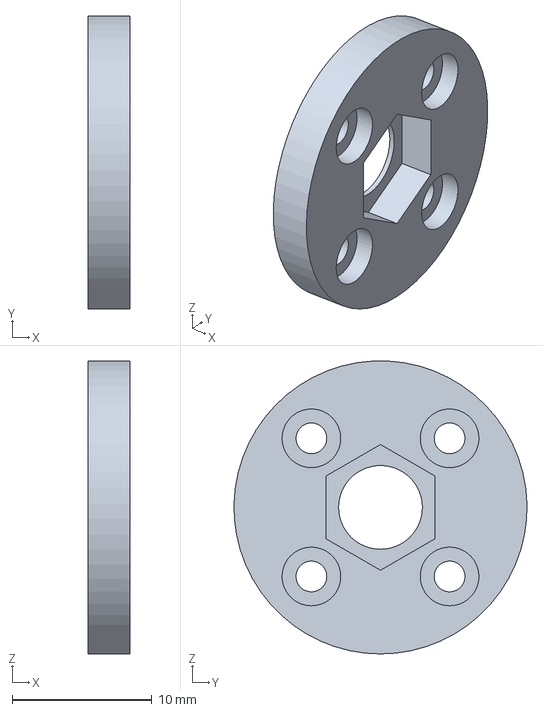
[picture p146: CAD file, 2026-11-05]
scissor-umi/2f-85/STEP/servo_coupler.step
3.00 x 21.0 x 21.0 mm
