Pruthvi-Neuracore/The-UMI-no-one-wants-hw/assembly/d405/parallel/assembly/parallel_right.stl

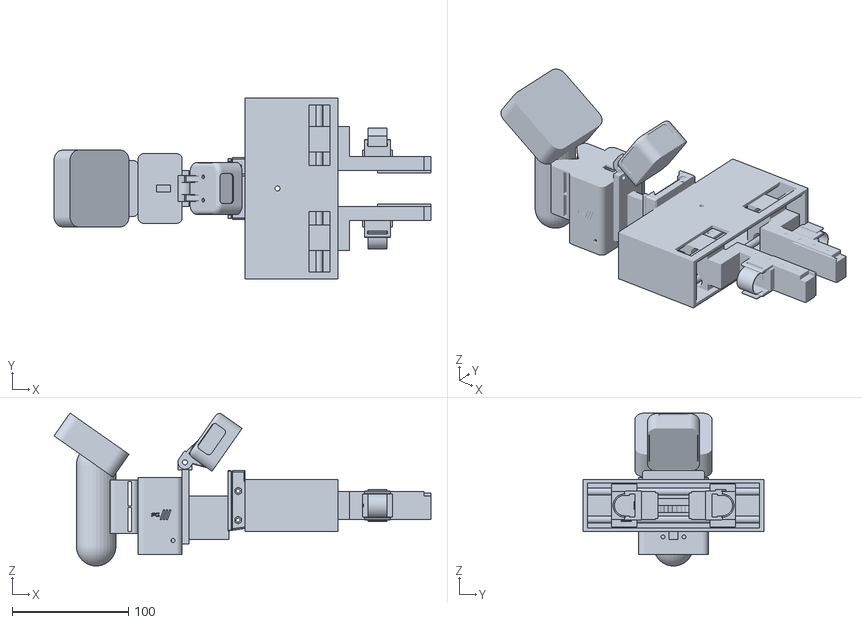
[picture p147: CAD file, 2026-10-12]
assembly/d405/parallel/assembly/parallel_right.stl
324.3 x 156.0 x 131.6
