Pruthvi-Neuracore/The-UMI-no-one-wants-hw/assembly/d405/parallel/urdf/meshes/parallel_rod_bottom.stl

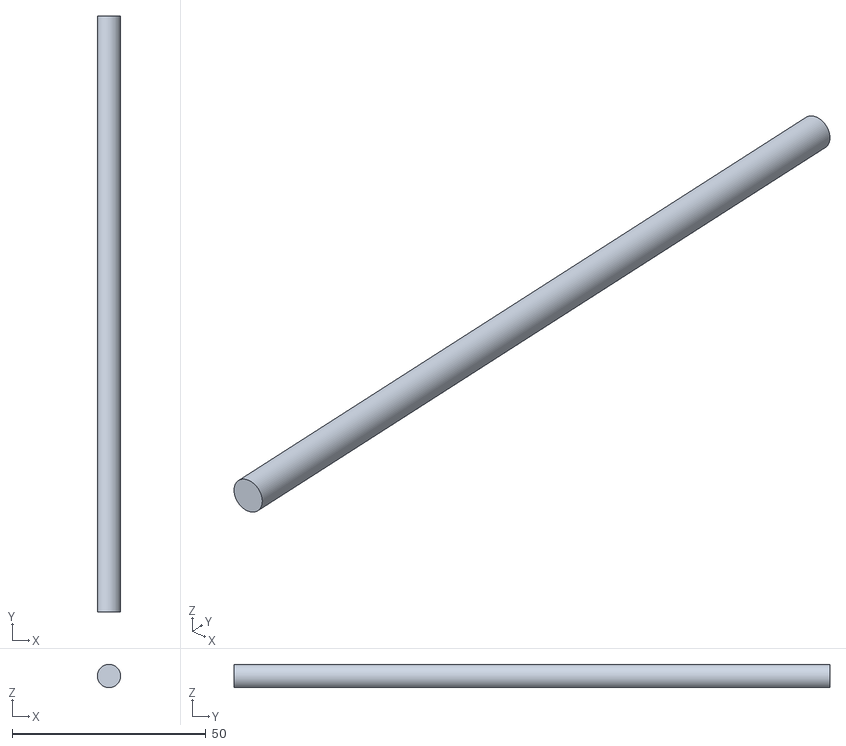
[picture p148: CAD file, 2026-10-12]
assembly/d405/parallel/urdf/meshes/parallel_rod_bottom.stl
6.00 x 154.0 x 6.00
