Pruthvi-Neuracore/The-UMI-no-one-wants-hw/assembly/insta360_x5/parallel/urdf/meshes/parallel_strap_right.stl

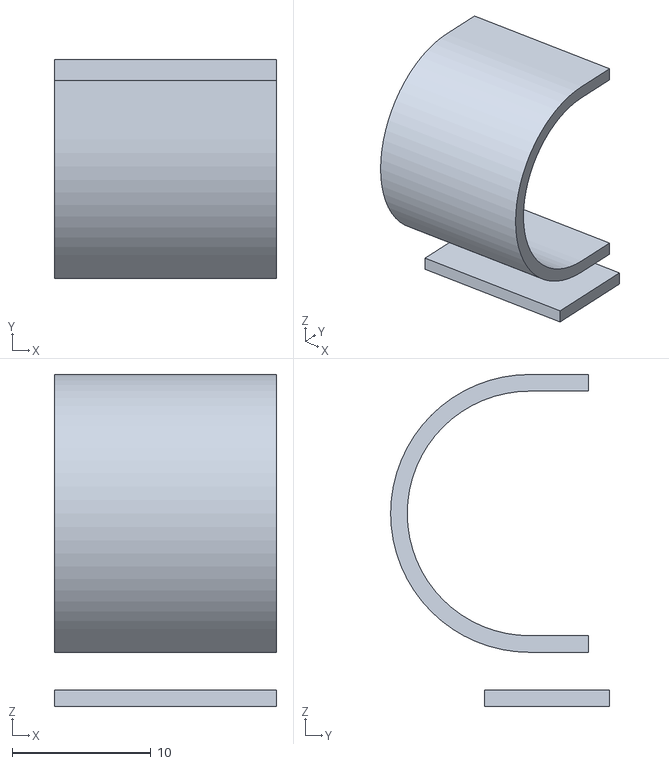
[picture p149: CAD file, 2026-10-12]
assembly/insta360_x5/parallel/urdf/meshes/parallel_strap_right.stl
16.0 x 15.8 x 23.9
