Pruthvi-Neuracore/The-UMI-no-one-wants-hw/handumi/hardware/STL/right/connecting_link_1.stl

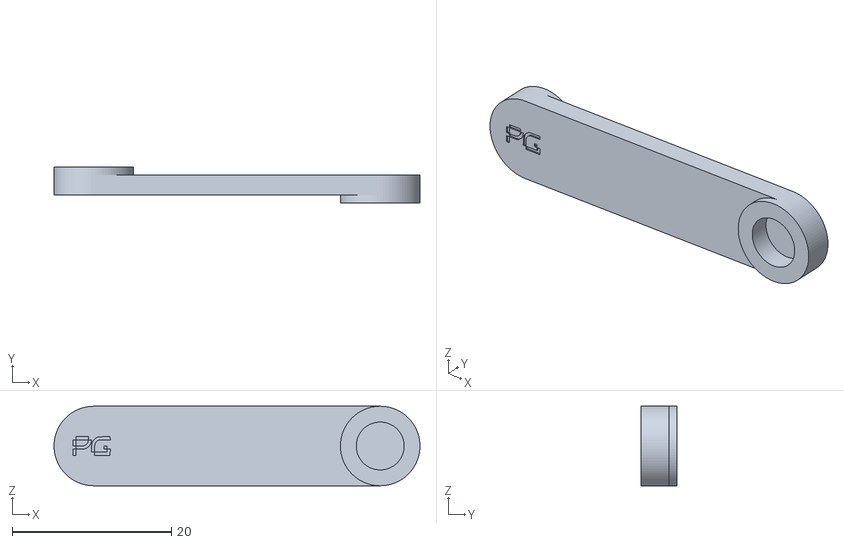
[picture p150: CAD file, 2026-10-13]
handumi/hardware/STL/right/connecting_link_1.stl
46.0 x 4.50 x 10.0
