Pruthvi-Neuracore/The-UMI-no-one-wants-hw/pg-chopstick/d405/chop-umi/STL/d405_frame.stl

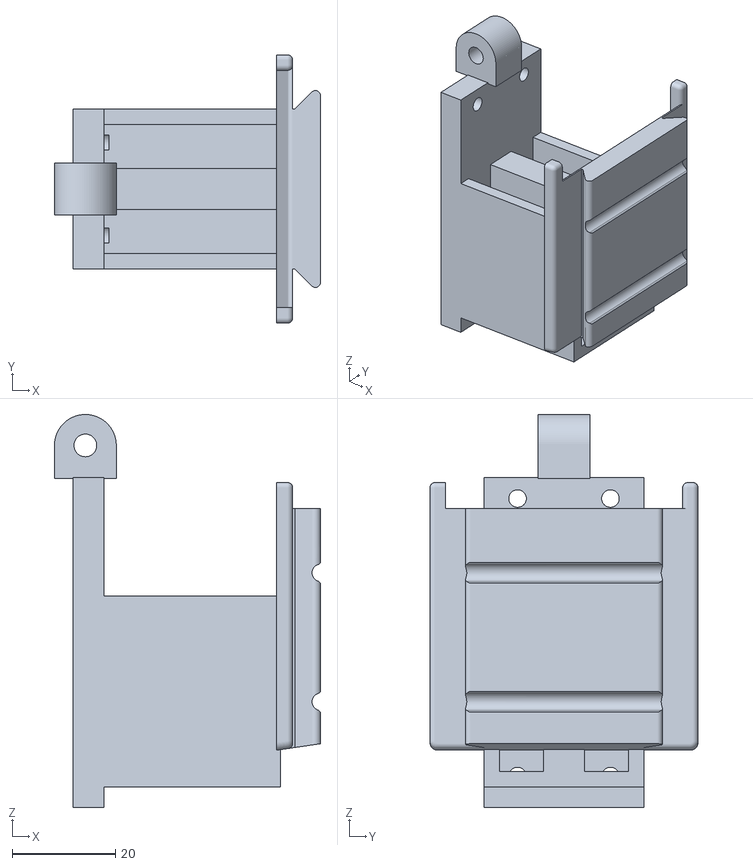
[picture p151: CAD file, 2026-10-13]
pg-chopstick/d405/chop-umi/STL/d405_frame.stl
51.6 x 52.0 x 76.2
