Pruthvi-Neuracore/The-UMI-no-one-wants-hw/(list of files, cad)

Other CAD files:
assembly/insta360_x5/chopstick/STL/tip_tpu_left.stl
assembly/insta360_x5/parallel/urdf/meshes/parallel_pad_right.stl
pg-chopstick/d405/chopstick/STEP/sleeve_button_cover_left.step
pg-chopstick/d405/chopstick/STL/jaw_left_dc_button.stl
pg-chopstick/d405/chopstick/urdf/meshes/jaw_right_dc_button_jawframe.stl
pg-chopstick/d405/hand/urdf/meshes/quest_controller_envelope.stl
pg-chopstick/d405/para-umi/STL/right/right_thumb_link.stl
pg-chopstick/insta360_x5/chop-umi/assembly/chop-umi_left.stl
pg-chopstick/insta360_x5/hand/urdf/meshes/pg_wrist_saddle.stl
pg-chopstick/insta360_x5/parallel/STL/left/left_controller_support.stl
assembly/d405/chopstick/urdf/meshes/quest_cradle.stl
assembly/d405/hand/STL/d405_frame.stl
assembly/d405/parallel/STEP/right/d405_wrist_mount.step
assembly/insta360_x5/chopstick/STEP/jaw_left_sa.step
assembly/insta360_x5/chopstick/urdf/meshes/chopstick_clip_dc.stl
assembly/insta360_x5/hand/STEP/pg_pod.step
assembly/insta360_x5/parallel/urdf/meshes/parallel_finger_right_sleeve.stl
handumi/hardware/STEP/left/left_index_middle_finger_link.step
handumi/hardware/STL/gripper_tips/Open-ENPIRE/ENPIRE-RIGHT-Jaw.stl
handumi/hardware/STL/right/d405_wrist_mount.stl
pg-chopstick/d405/chop-umi/assembly/chop-umi_left.stl
pg-chopstick/d405/chop-umi/STL/quest_support_left.stl
pg-chopstick/d405/chop-umi/urdf/meshes/d405_cup.stl
pg-chopstick/d405/chopstick/assembly/chopstick_iso50.stl
pg-chopstick/d405/chopstick/STL/openarm_adapter.stl
pg-chopstick/d405/hand/STEP/palm_button.step
pg-chopstick/d405/hand/urdf/meshes/ebox_wrist_saddle.stl
pg-chopstick/insta360_x5/chopstick/assembly/chopstick_openarm.stl
pg-chopstick/insta360_x5/chopstick/STL/x5_frame.stl
pg-chopstick/insta360_x5/hand/STL/pg_wrist_saddle.stl
assembly/d405/chopstick/STEP/d405_frame.step
assembly/d405/chopstick/urdf/meshes/chopstick_base_sa.stl
assembly/d405/parallel/assembly/parallel_iso50.stl
assembly/d405/parallel/STL/parallel_finger_right_dots.stl
assembly/insta360_x5/chopstick/STEP/jaw_right_dc_button.step
assembly/insta360_x5/chopstick/urdf/meshes/x5_frame.stl
assembly/insta360_x5/parallel/urdf/meshes/chopstick_clip_sa.stl
handumi/hardware/STL/right/right_thumb_link.stl
pg-chopstick/d405/chop-umi/STEP/quest_arm_left.step
pg-chopstick/d405/chop-umi/STL/jaw_right_dc_button.stl
pg-chopstick/d405/chop-umi/urdf/meshes/quest_support_left.stl
pg-chopstick/d405/chopstick/STEP/jaw_left_dc.step
pg-chopstick/d405/chopstick/STL/chopstick_clip_dc.stl
pg-chopstick/d405/hand/STEP/ebox_wrist_saddle.step
pg-chopstick/insta360_x5/chop-umi/STEP/openarm_adapter.step
pg-chopstick/insta360_x5/chopstick/assembly/chopstick_left.stl
pg-chopstick/insta360_x5/chopstick/STEP/jaw_right_dc.step
pg-chopstick/insta360_x5/chopstick/urdf/meshes/sleeve_button_cover_left_jawframe.stl
assembly/d405/chopstick/STEP/ebox_lid.step
assembly/d405/chopstick/urdf/meshes/jaw_left_dc_jawframe.stl
assembly/d405/parallel/STEP/parallel_pinion.step
assembly/insta360_x5/chopstick/STEP/chopstick_clip_sa.step
assembly/insta360_x5/parallel/assembly/parallel_right.stl
assembly/insta360_x5/parallel/STEP/parallel_base_sa.step
handumi/hardware/STL/left/left_controller_support.stl
pg-chopstick/d405/chop-umi/STEP/sleeve_button_cover_right.step
pg-chopstick/d405/chopstick/STEP/jaw_right.step
pg-chopstick/d405/hand/STEP/ebox.step
assembly/d405/chopstick/STEP/jaw_right_dc.step
assembly/d405/chopstick/assembly/chopstick_iso50.stl
assembly/d405/chopstick/assembly/chopstick_left.stl
assembly/d405/chopstick/assembly/chopstick_openarm.stl
assembly/d405/chopstick/urdf/meshes/ebox.stl
assembly/d405/chopstick/urdf/meshes/ebox_lid.stl
assembly/d405/parallel/STEP/ebox.step
assembly/d405/parallel/STEP/parallel_base_dc.step
assembly/d405/parallel/STEP/parallel_button_cover_left.step
assembly/d405/parallel/STEP/parallel_button_cover_right.step
assembly/d405/parallel/STEP/parallel_carriage_right.step
assembly/d405/parallel/STEP/parallel_finger_left.step
assembly/d405/parallel/STEP/parallel_finger_left_button.step
assembly/d405/parallel/STEP/parallel_finger_left_sleeve.step
assembly/d405/parallel/STEP/parallel_finger_right.step
assembly/d405/parallel/STEP/parallel_finger_right_button.step
assembly/d405/parallel/STEP/parallel_pad_left.step
assembly/d405/parallel/STEP/parallel_pad_right.step
assembly/d405/parallel/STEP/parallel_pinion_servo.step
assembly/d405/parallel/STEP/quest_cradle.step
assembly/d405/parallel/STL/parallel_button_cover_left.stl
assembly/d405/parallel/STL/parallel_button_cover_right.stl
assembly/d405/parallel/STL/parallel_carriage_left.stl
assembly/d405/parallel/STL/parallel_carriage_right.stl
assembly/d405/parallel/STL/parallel_finger_left_button.stl
assembly/d405/parallel/STL/parallel_finger_right_sleeve.stl
assembly/d405/parallel/STL/parallel_pad_right.stl
assembly/d405/parallel/STL/parallel_pinion_servo.stl
assembly/d405/parallel/STL/quest_cradle.stl
assembly/d405/parallel/assembly/parallel_left.stl
assembly/d405/parallel/urdf/meshes/parallel_button_cover_left.stl
assembly/d405/parallel/urdf/meshes/parallel_button_cover_right.stl
assembly/d405/parallel/urdf/meshes/parallel_carriage_left.stl
assembly/d405/parallel/urdf/meshes/parallel_carriage_right.stl
assembly/d405/parallel/urdf/meshes/parallel_finger_left.stl
assembly/d405/parallel/urdf/meshes/parallel_pad_left.stl
assembly/d405/parallel/urdf/meshes/parallel_pinion_pinionframe.stl
assembly/d405/parallel/urdf/meshes/parallel_rod_top.stl
assembly/d405/parallel/urdf/meshes/quest_controller_envelope.stl
assembly/insta360_x5/hand/STL/pg_pod.stl
assembly/insta360_x5/parallel/STEP/parallel_base_dc.step
assembly/insta360_x5/parallel/STEP/parallel_button_cover_right.step
assembly/insta360_x5/parallel/STEP/parallel_carriage_left.step
assembly/insta360_x5/parallel/STEP/parallel_carriage_right.step
assembly/insta360_x5/parallel/STEP/parallel_finger_left.step
assembly/insta360_x5/parallel/STEP/parallel_finger_left_button.step
assembly/insta360_x5/parallel/STEP/parallel_finger_left_sleeve.step
assembly/insta360_x5/parallel/STEP/parallel_finger_right.step
assembly/insta360_x5/parallel/STEP/parallel_finger_right_button.step
assembly/insta360_x5/parallel/STEP/parallel_finger_right_sleeve.step
assembly/insta360_x5/parallel/STEP/parallel_pad_left.step
assembly/insta360_x5/parallel/STEP/parallel_pinion_servo.step
assembly/insta360_x5/parallel/STL/parallel_base_dc.stl
assembly/insta360_x5/parallel/STL/parallel_base_sa.stl
assembly/insta360_x5/parallel/STL/parallel_finger_left.stl
assembly/insta360_x5/parallel/STL/parallel_finger_left_sleeve.stl
assembly/insta360_x5/parallel/STL/parallel_finger_right.stl
assembly/insta360_x5/parallel/STL/parallel_finger_right_button.stl
assembly/insta360_x5/parallel/STL/parallel_pad_left.stl
assembly/insta360_x5/parallel/STL/parallel_pinion.stl
assembly/insta360_x5/parallel/urdf/meshes/insta360_x5_envelope.stl
assembly/insta360_x5/parallel/urdf/meshes/parallel_base_sa.stl
assembly/insta360_x5/parallel/urdf/meshes/parallel_finger_left_button.stl
assembly/insta360_x5/parallel/urdf/meshes/parallel_finger_left_sleeve.stl
assembly/insta360_x5/parallel/urdf/meshes/parallel_finger_right.stl
assembly/insta360_x5/parallel/urdf/meshes/parallel_finger_right_button.stl
assembly/insta360_x5/parallel/urdf/meshes/parallel_strap_left.stl
handumi/hardware/STL/left/d405_hood.stl
handumi/hardware/STL/left/end_cover.stl
handumi/hardware/STL/left/hand_support_base.stl
handumi/hardware/STL/left/left_index_middle_finger_link.stl
handumi/hardware/STL/right/button_cover_tpu.stl
handumi/hardware/STL/right/d405_hood.stl
handumi/hardware/STL/right/electronics_box.stl
handumi/hardware/STL/right/right_controller_support.stl
handumi/hardware/STL/right/right_index_middle_finger_link.stl
handumi/hardware/STL/robot/hande_camera_plate.stl
pg-chopstick/d405/chop-umi/STEP/openarm_adapter.step
pg-chopstick/d405/chopstick/STEP/ebox_lid.step
pg-chopstick/d405/chopstick/STL/sleeve_button_cover_left.stl
pg-chopstick/d405/hand/STL/ebox_wrist_saddle.stl
pg-chopstick/insta360_x5/chop-umi/STEP/jaw_left_dc.step
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
