Pruthvi-Neuracore/The-UMI-no-one-wants-hw/assembly/tags/README.md

# Tags

`pg_tags_4x4_50_14mm.pdf`: ArUco DICT_4X4_50, 14 mm markers, ids 0–49, on A4 at true scale (check the 100 mm scale
bar after printing). Stick one on each device's base; the id names the device. Regenerate with
`cad/d405/make_tags.py`.
