Pruthvi-Neuracore/The-UMI-no-one-wants-hw/scissor-umi/2f-85/assembly/ASSEMBLY.md

# Scissor-UMI · 2f-85: assembly

IKEA-style, drawn from the CAD: new parts in blue, pulled out along the way they go in; parts already built in grey; screws and dowels at their real holes, with the hardware for each step (to scale) at the top. All pages as one PDF: [`assembly.pdf`](assembly.pdf).

Drawn for the right-hand build. The left-hand build is the same with `handle_a_lh` / `handle_b_lh`, `grip_tpu_*_lh` and `quest_arm_left` (palm bar and finger loop swap sides).

Tools: soldering iron (heat-set inserts), 2.5 / 2 / 1.5 mm hex keys, small Phillips, CA glue, threadlocker, a vice or arbor press for the dowels.

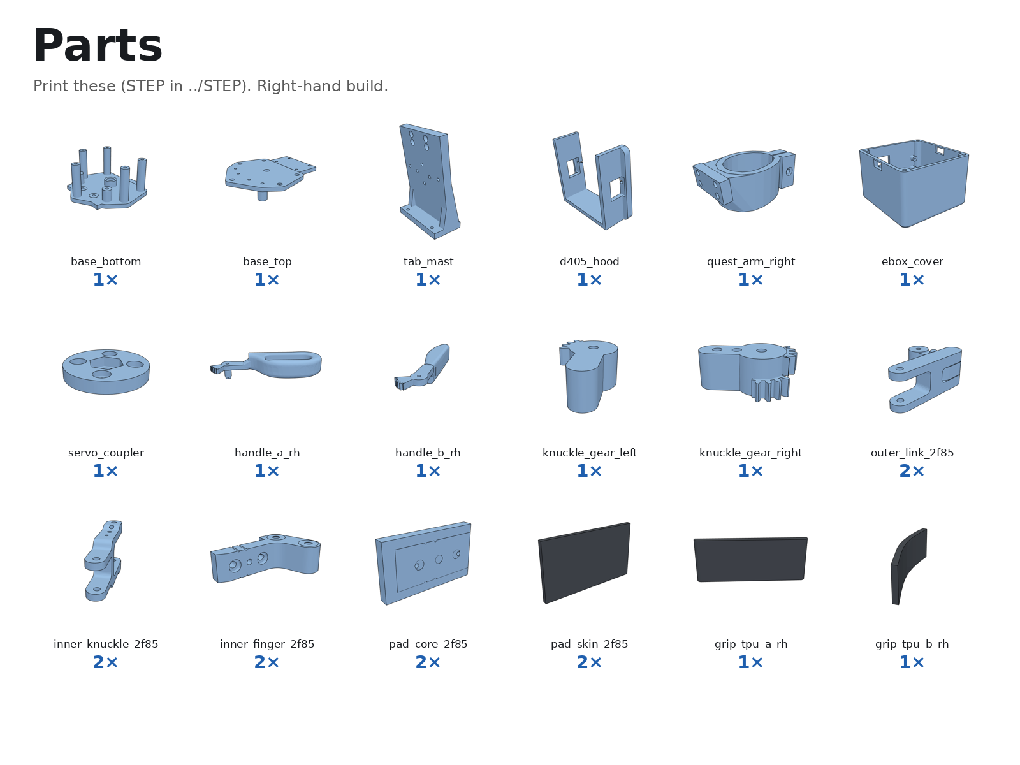
[picture p178: scissor-umi/2f-85/assembly/page_00_parts.png]
page_00_parts


page_01_inserts

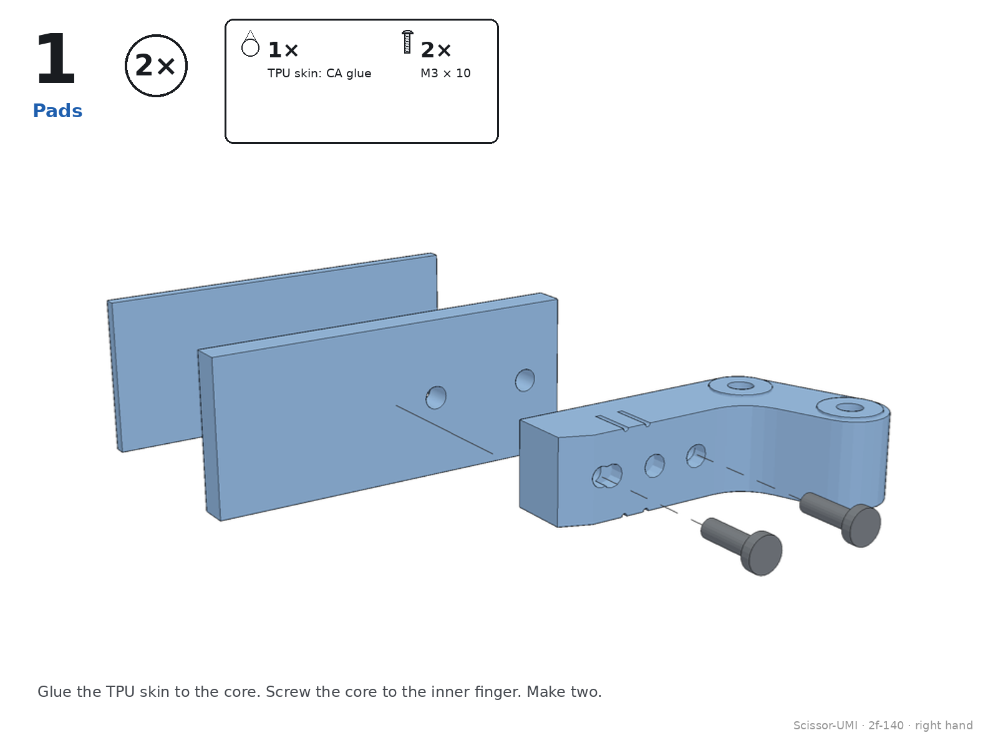
[picture p179: scissor-umi/2f-140/assembly/step_01.png]
step_01


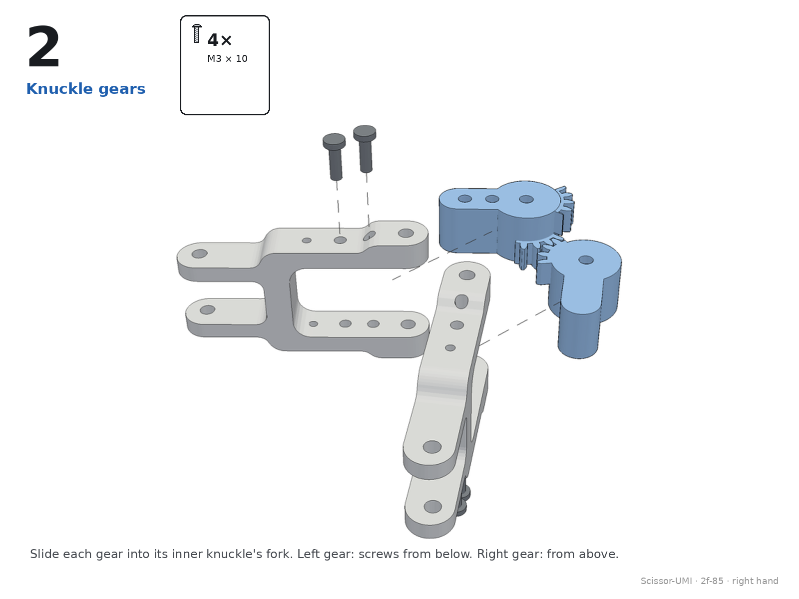
[picture p180: scissor-umi/2f-85/assembly/step_02.png]
step_02


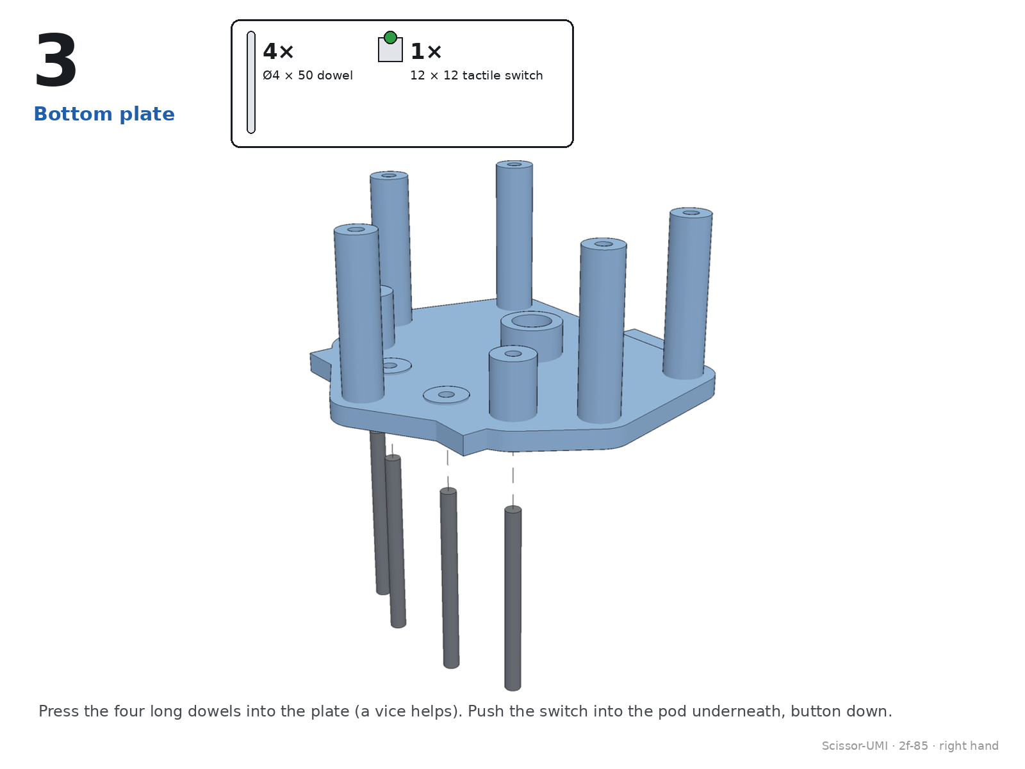
[picture p181: scissor-umi/2f-85/assembly/step_03.png]
step_03


step_04

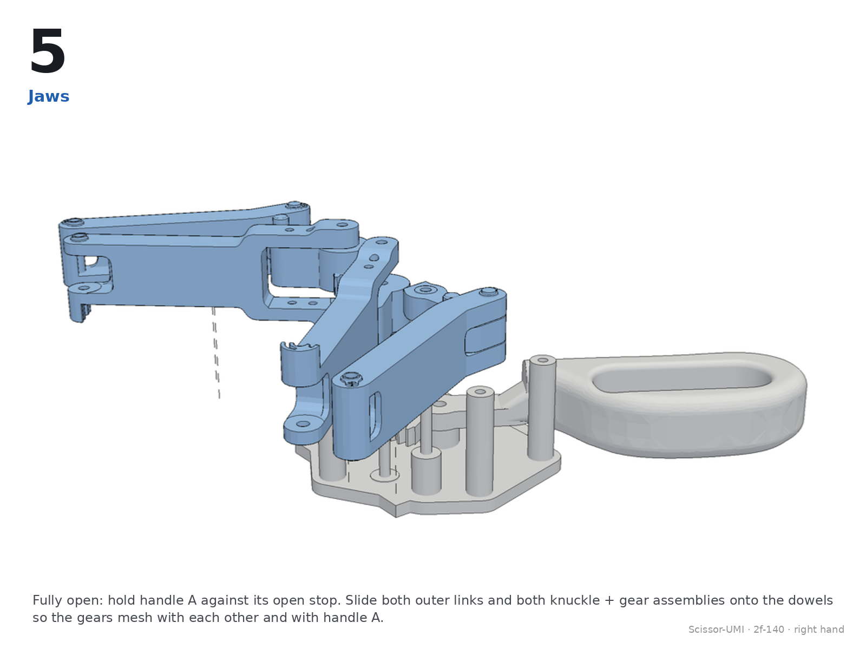
[picture p182: scissor-umi/2f-140/assembly/step_05.png]
step_05


step_06

step_07

step_08

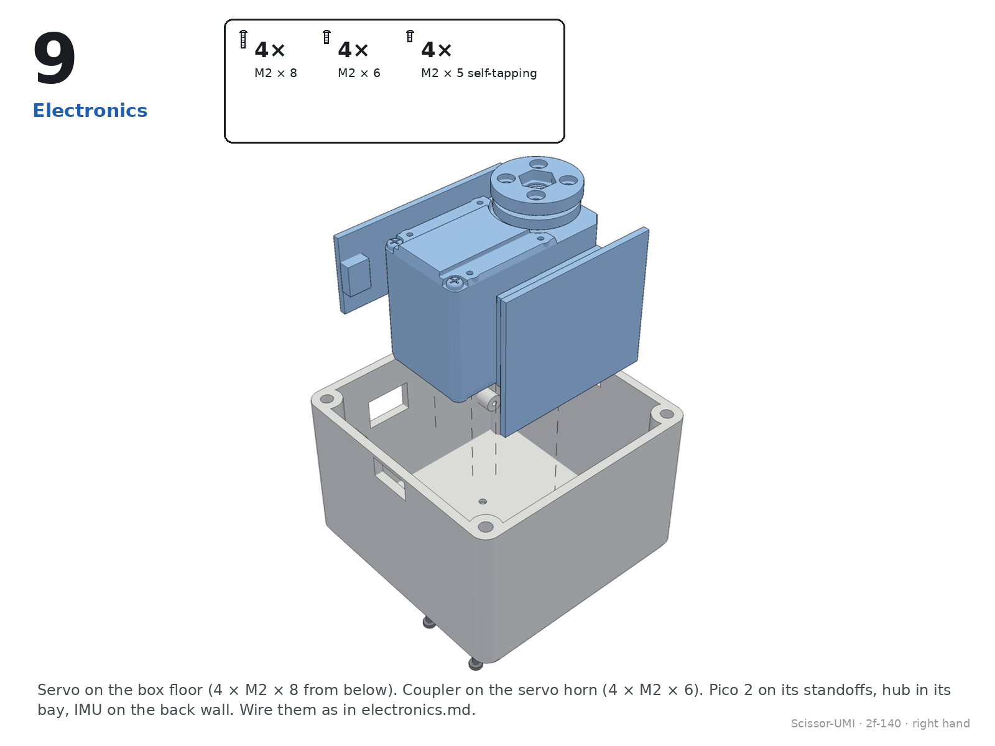
[picture p183: scissor-umi/2f-140/assembly/step_09.png]
step_09


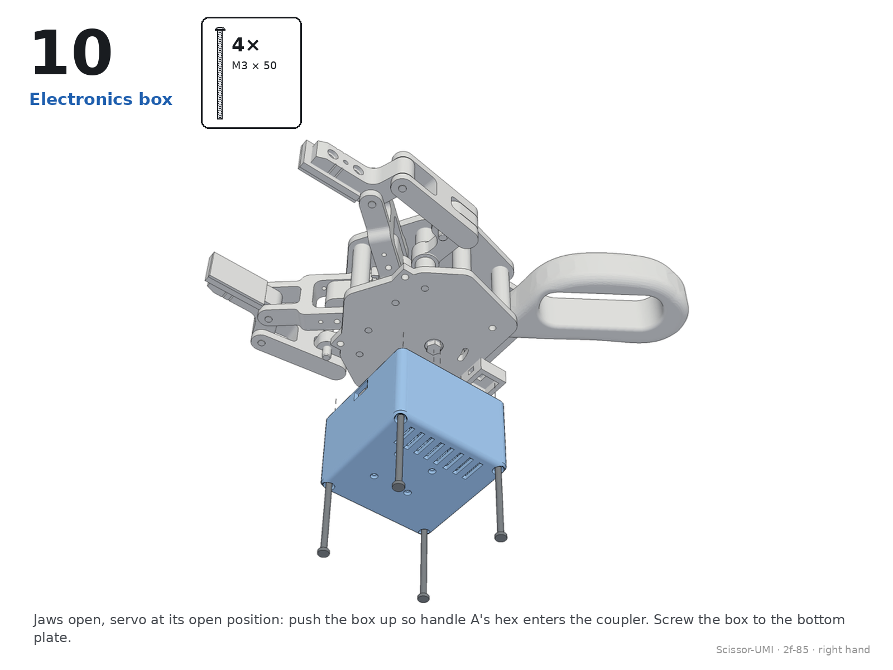
[picture p184: scissor-umi/2f-85/assembly/step_10.png]
step_10


step_11

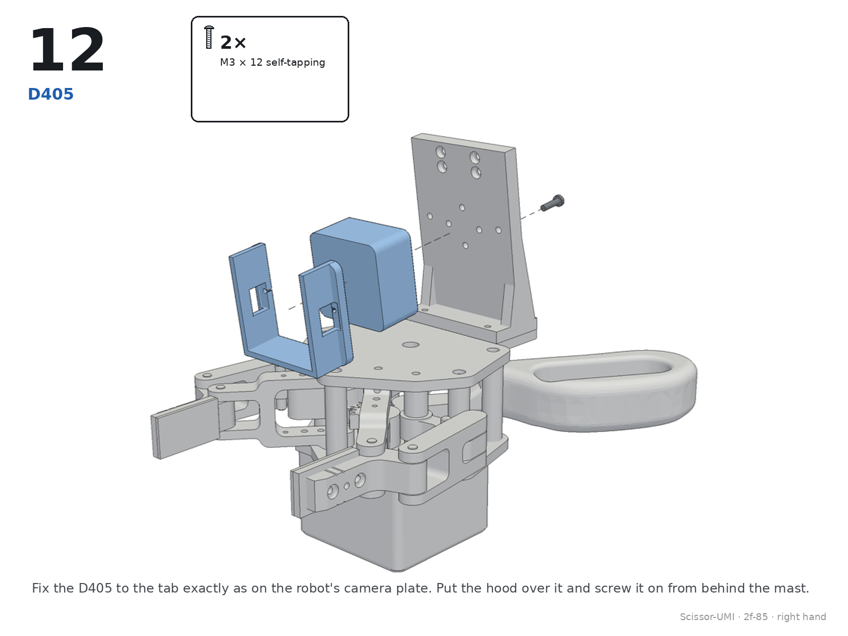
[picture p185: scissor-umi/2f-85/assembly/step_12.png]
step_12


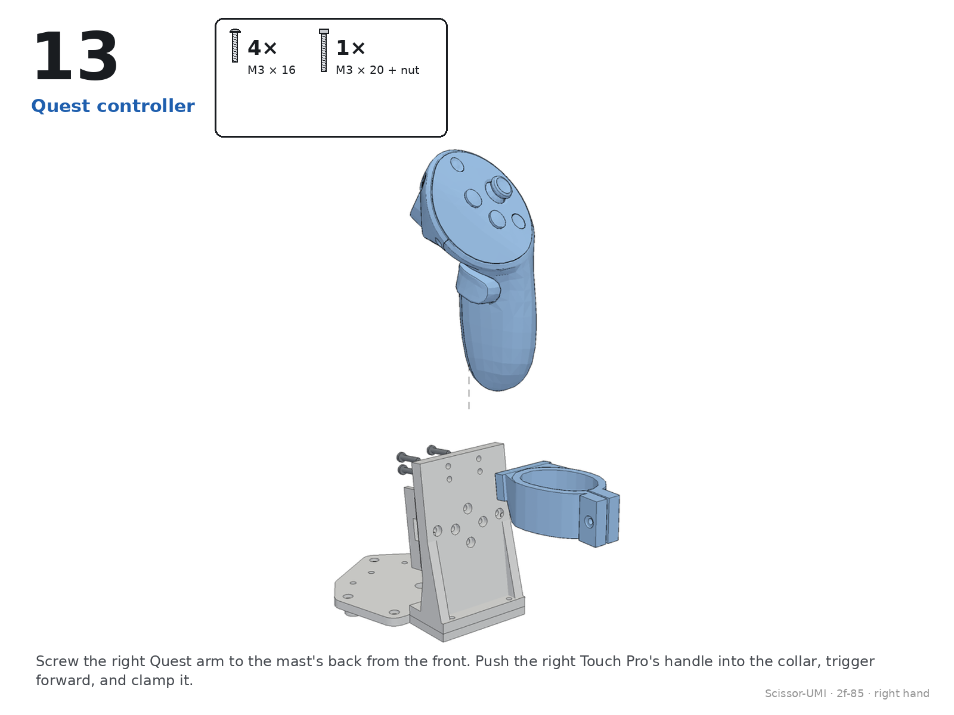
[picture p186: scissor-umi/2f-85/assembly/step_13.png]
step_13


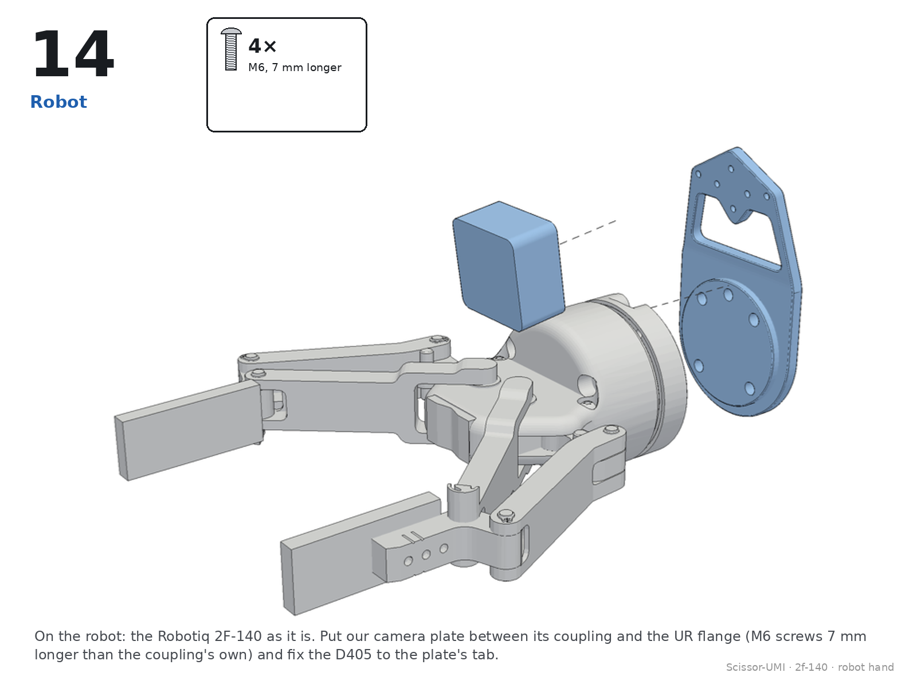
[picture p187: scissor-umi/2f-140/assembly/step_14_robot.png]
step_14_robot
