Pruthvi-Neuracore/The-UMI-no-one-wants-hw/scissor-umi/2f-140/assembly/ASSEMBLY.md

# Scissor-UMI · 2f-140: assembly

IKEA-style, drawn from the CAD: new parts in blue, pulled out along the way they go in; parts already built in grey; screws and dowels at their real holes, with the hardware for each step (to scale) at the top. All pages as one PDF: [`assembly.pdf`](assembly.pdf).

Drawn for the right-hand build. The left-hand build is the same with `handle_a_lh` / `handle_b_lh`, `grip_tpu_*_lh` and `quest_arm_left` (palm bar and finger loop swap sides).

Tools: soldering iron (heat-set inserts), 2.5 / 2 / 1.5 mm hex keys, small Phillips, CA glue, threadlocker, a vice or arbor press for the dowels.

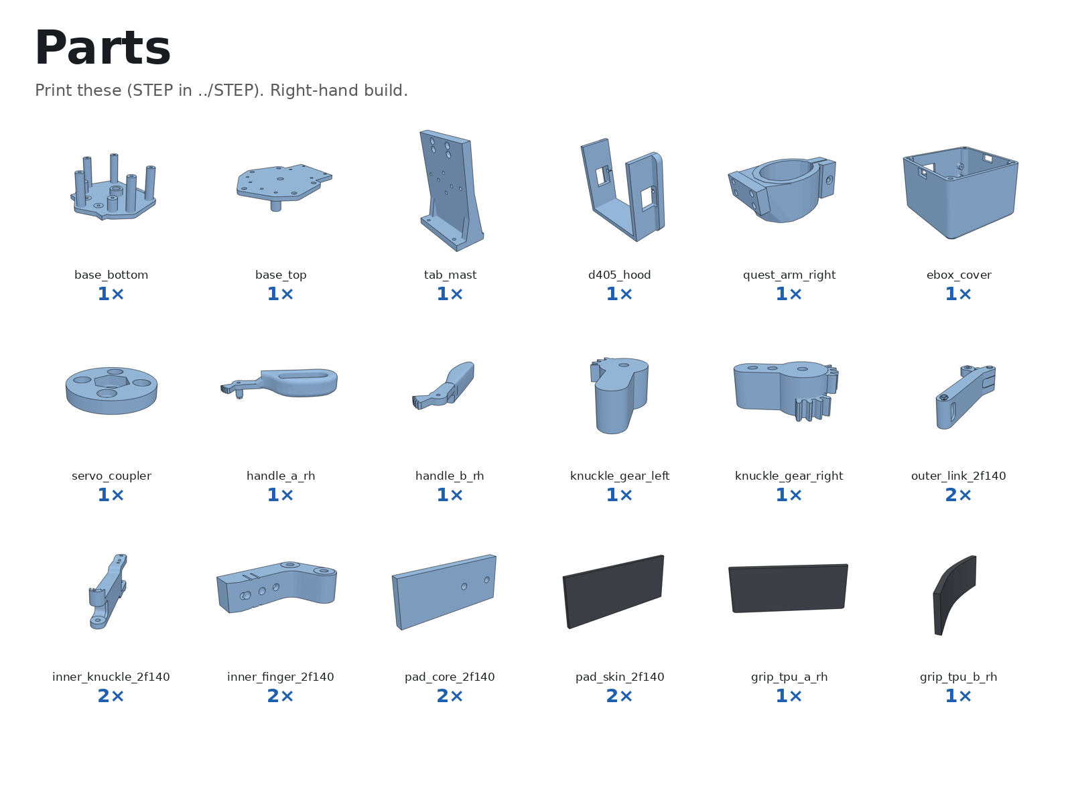
[picture p188: scissor-umi/2f-140/assembly/page_00_parts.png]
page_00_parts


page_01_inserts

step_01

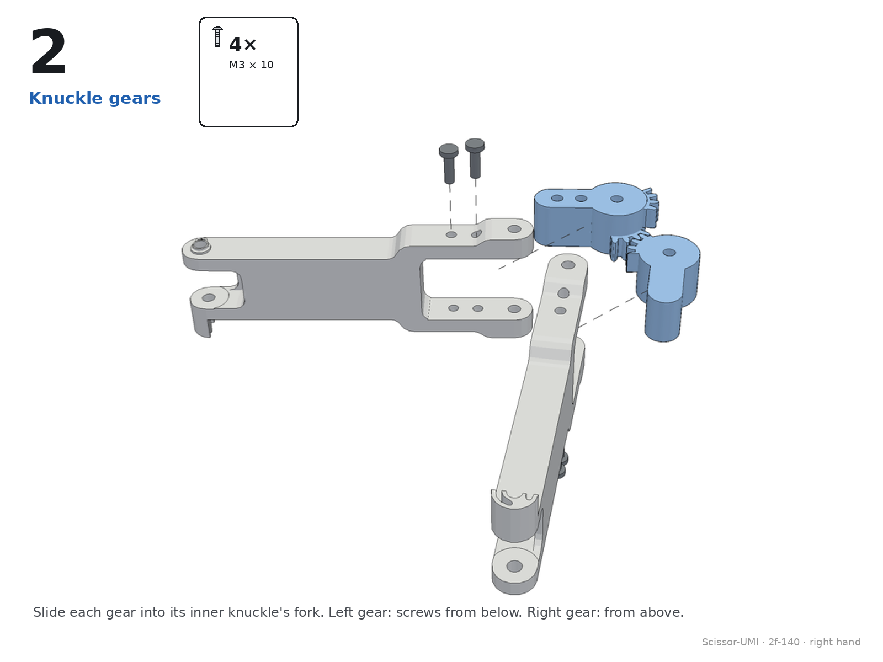
[picture p189: scissor-umi/2f-140/assembly/step_02.png]
step_02


step_03

step_04

step_05

step_06

step_07

step_08

step_09

step_10

step_11

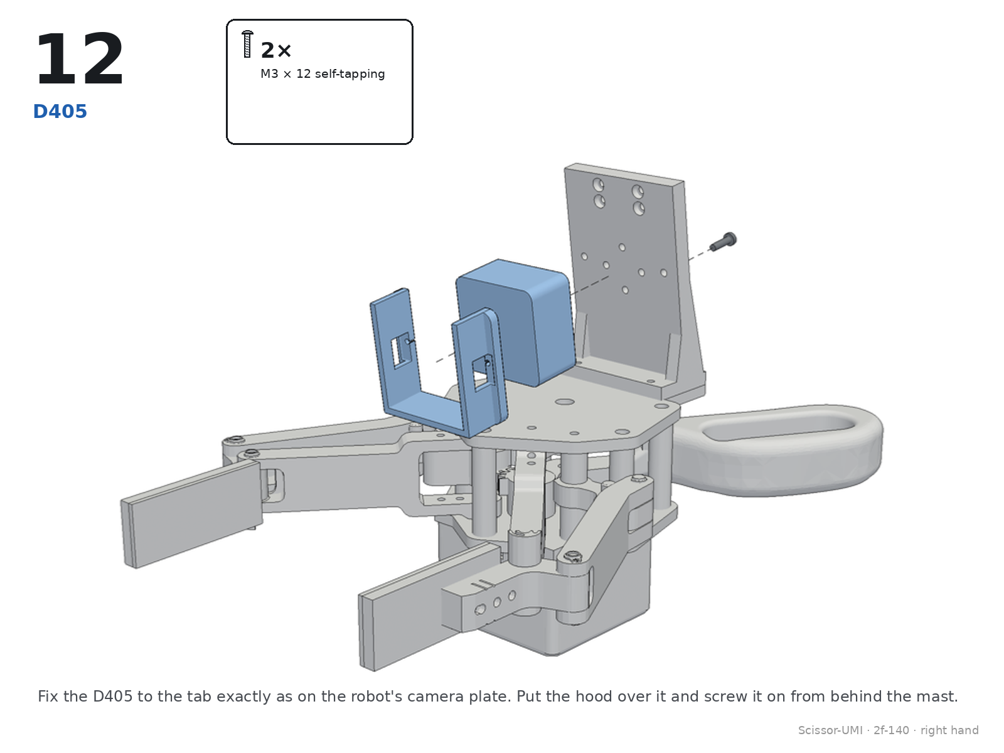
[picture p190: scissor-umi/2f-140/assembly/step_12.png]
step_12


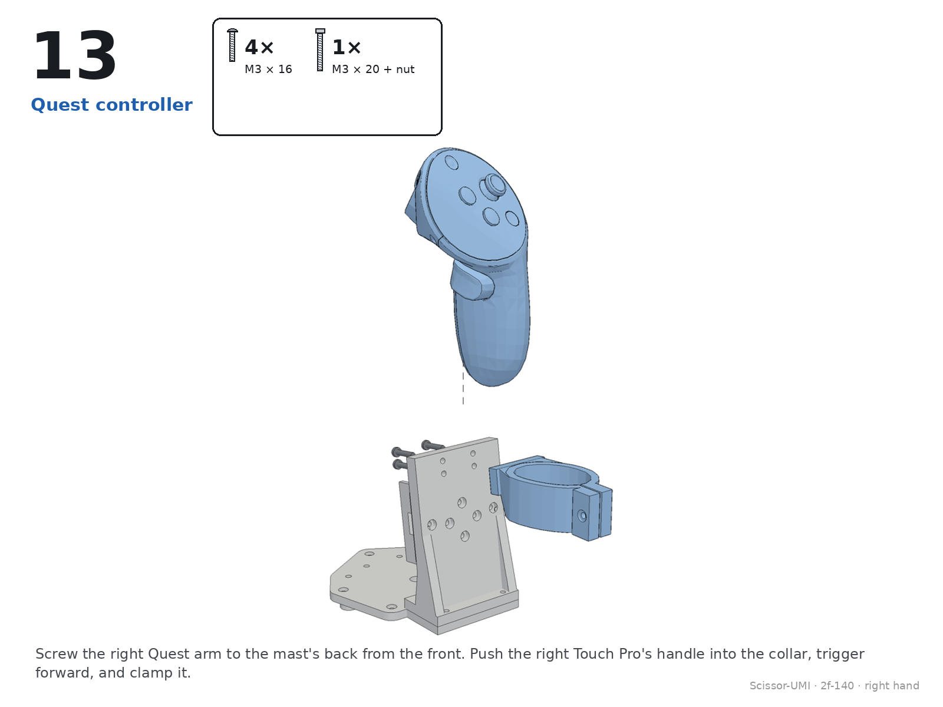
[picture p191: scissor-umi/2f-140/assembly/step_13.png]
step_13


step_14_robot
