Pruthvi-Neuracore/The-UMI-no-one-wants-hw/pg-chopstick/d405/chop-umi/assembly_guide/ASSEMBLY.md

# Chop-UMI · D405 + Quest: assembly

IKEA-style pages drawn from the kit's own assembly (`assembly/chop-umi_right.glb`): new parts in blue, pulled out along the way they go in, parts already built in grey, the hardware for each step at the top. Right hand shown; the left hand mirrors it. Hardware as in [`../bom.md`](../bom.md).

All pages as one PDF: [`assembly.pdf`](assembly.pdf).

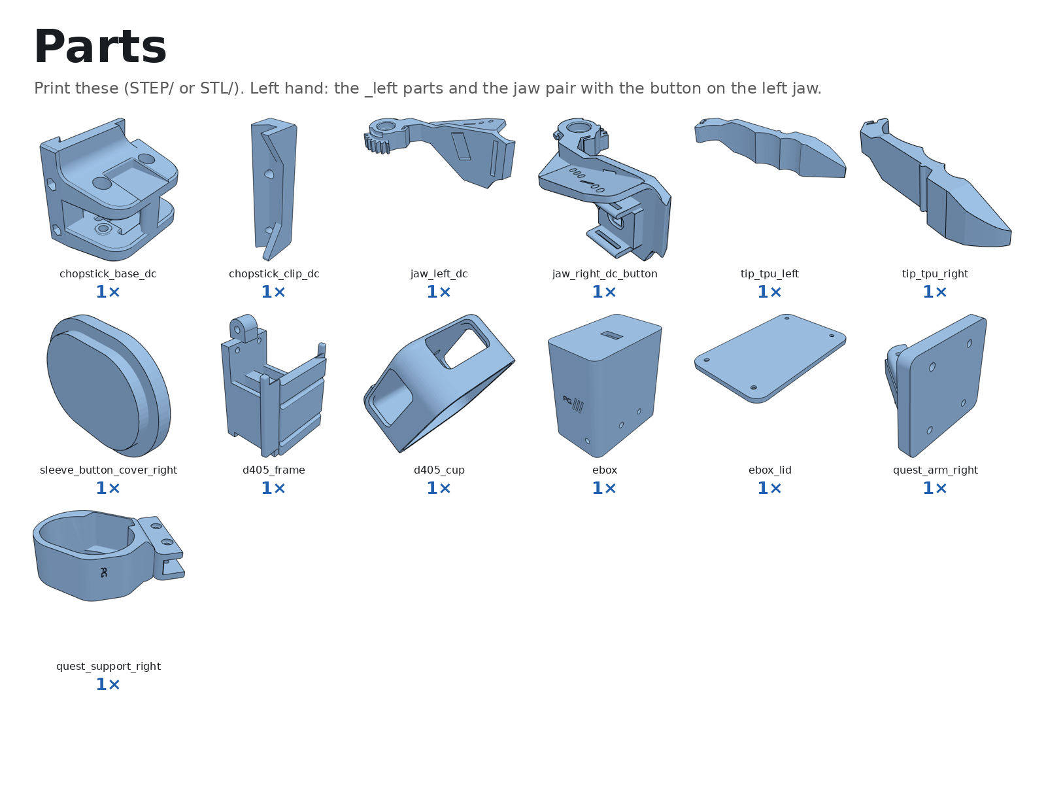
[picture p192: pg-chopstick/d405/chop-umi/assembly_guide/page_00_parts.png]
page_00_parts


step_01

step_02

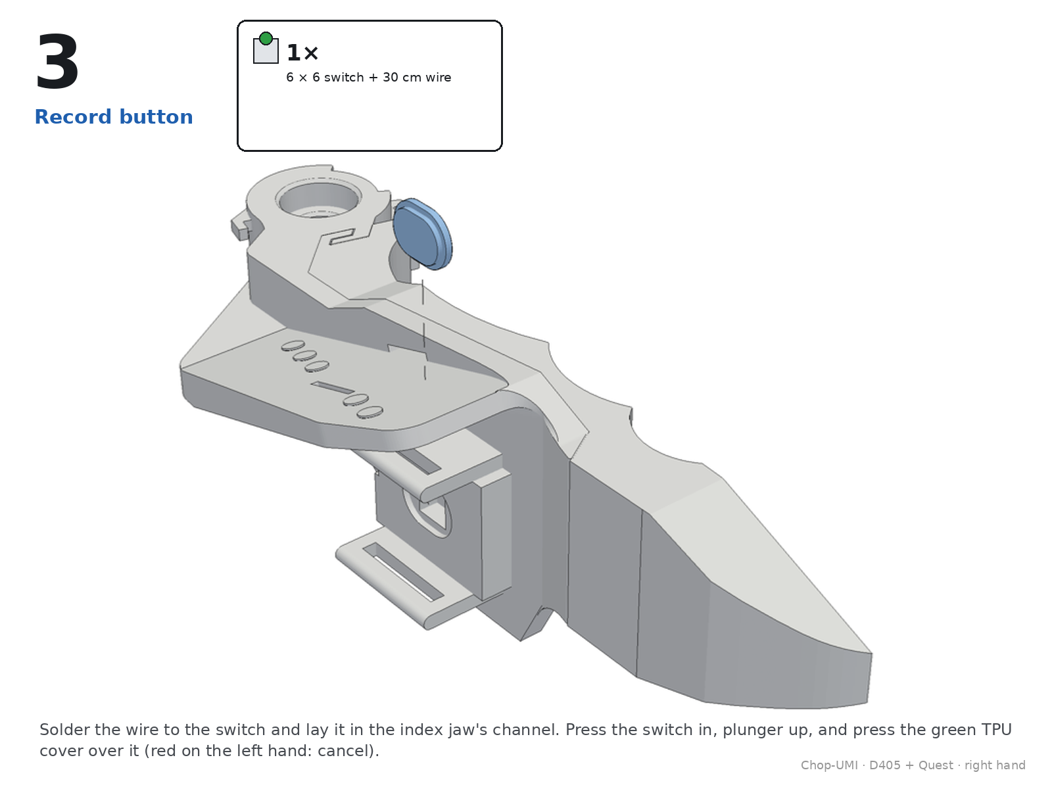
[picture p193: pg-chopstick/d405/chop-umi/assembly_guide/step_03.png]
step_03


step_04

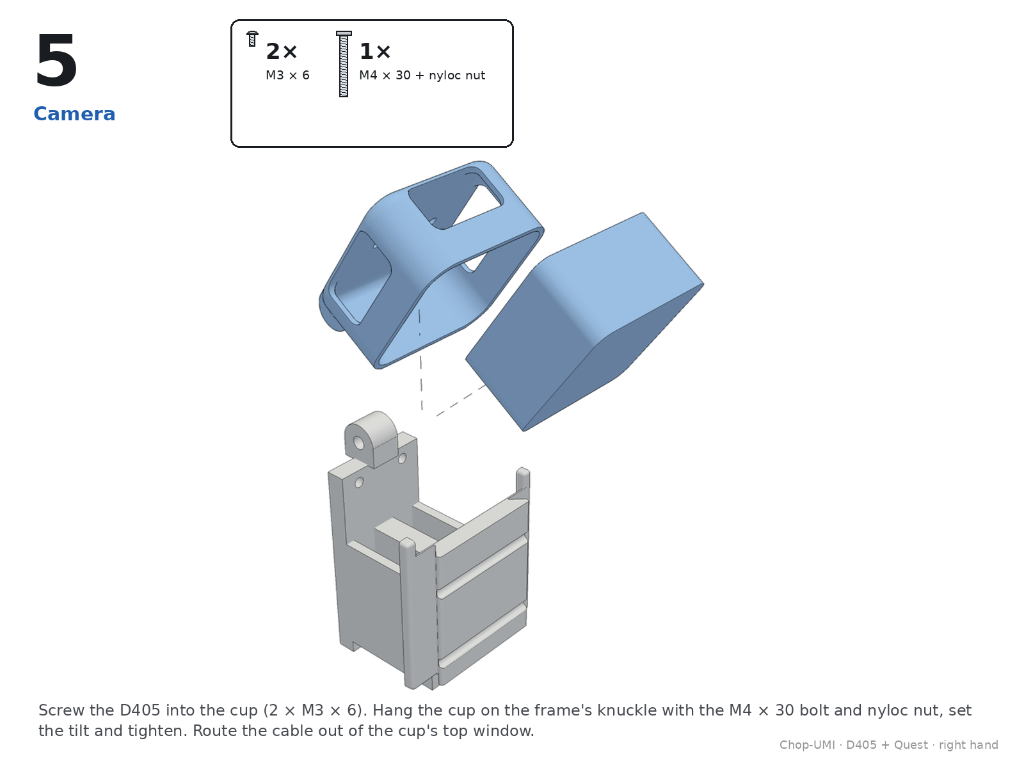
[picture p194: pg-chopstick/d405/chop-umi/assembly_guide/step_05.png]
step_05


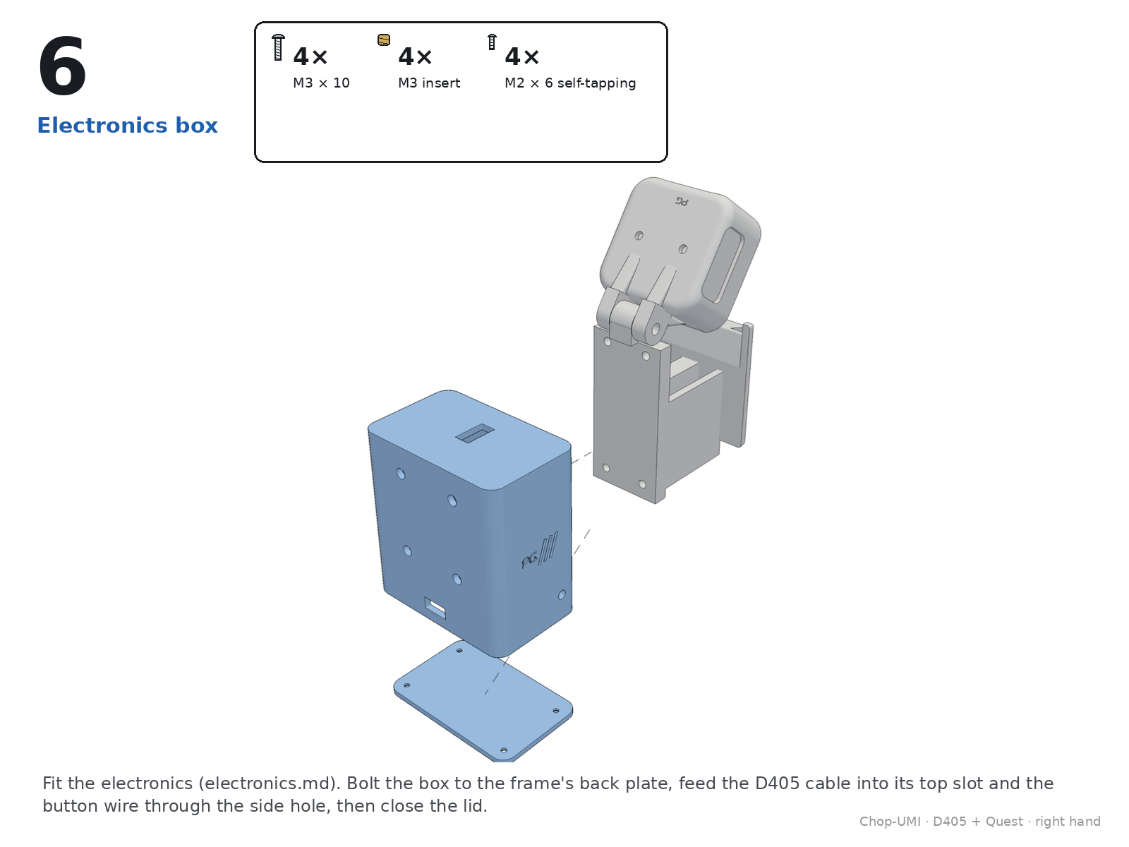
[picture p195: pg-chopstick/d405/chop-umi/assembly_guide/step_06.png]
step_06


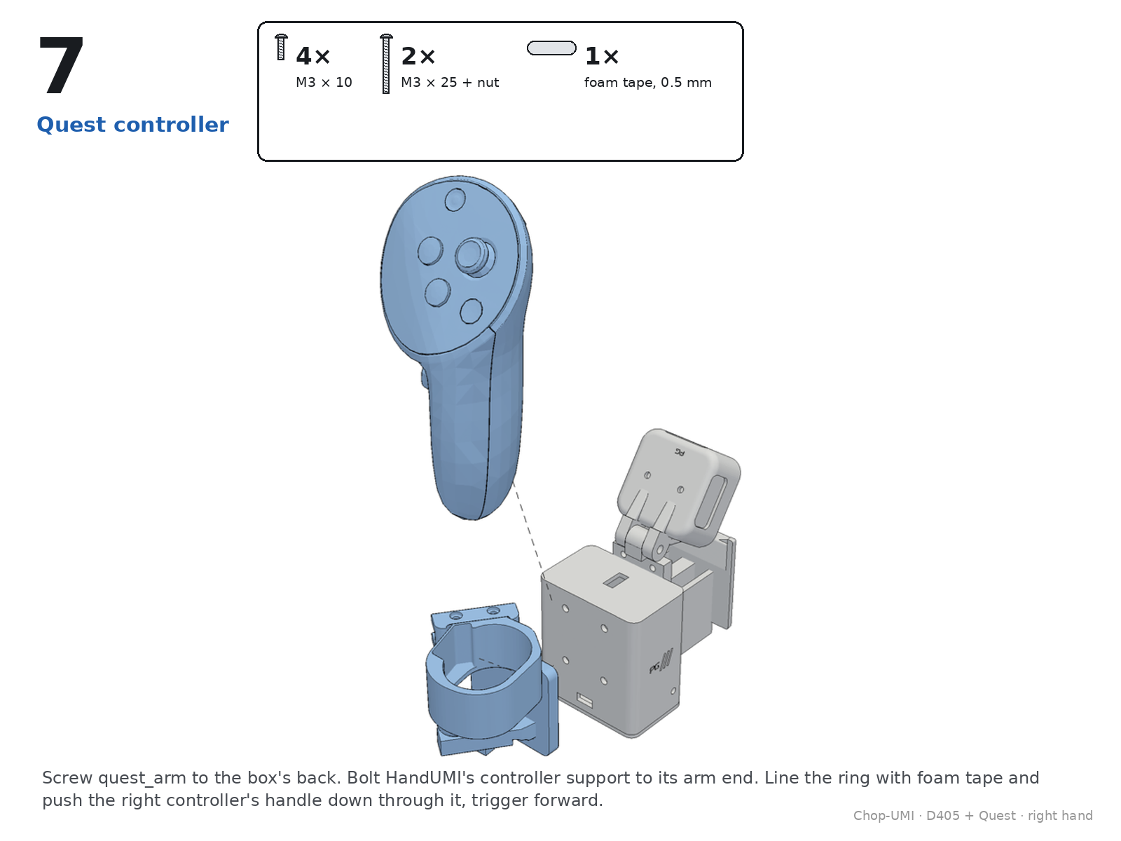
[picture p196: pg-chopstick/d405/chop-umi/assembly_guide/step_07.png]
step_07


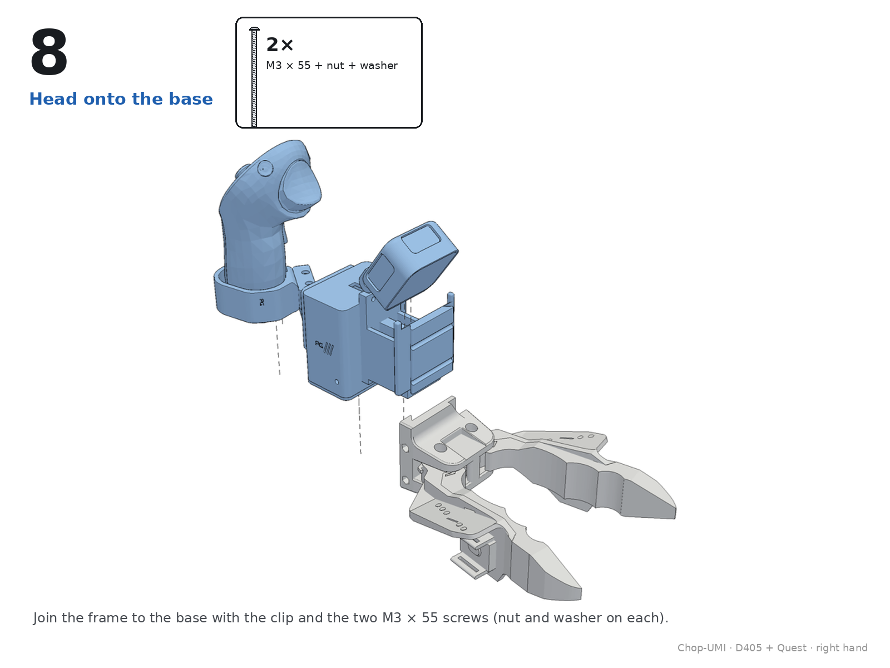
[picture p197: pg-chopstick/d405/chop-umi/assembly_guide/step_08.png]
step_08


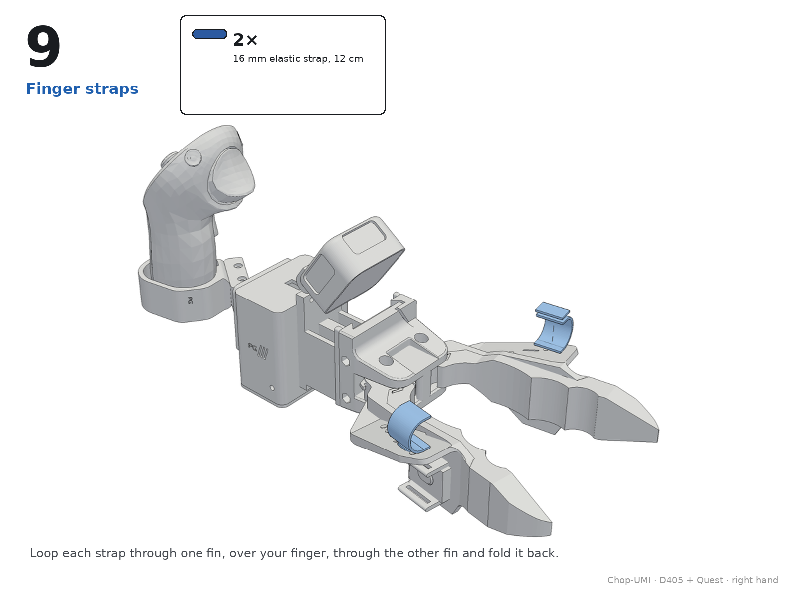
[picture p198: pg-chopstick/d405/chop-umi/assembly_guide/step_09.png]
step_09
