Pruthvi-Neuracore/The-UMI-no-one-wants-hw/assembly/tags/pg_tags_4x4_50_14mm.pdf

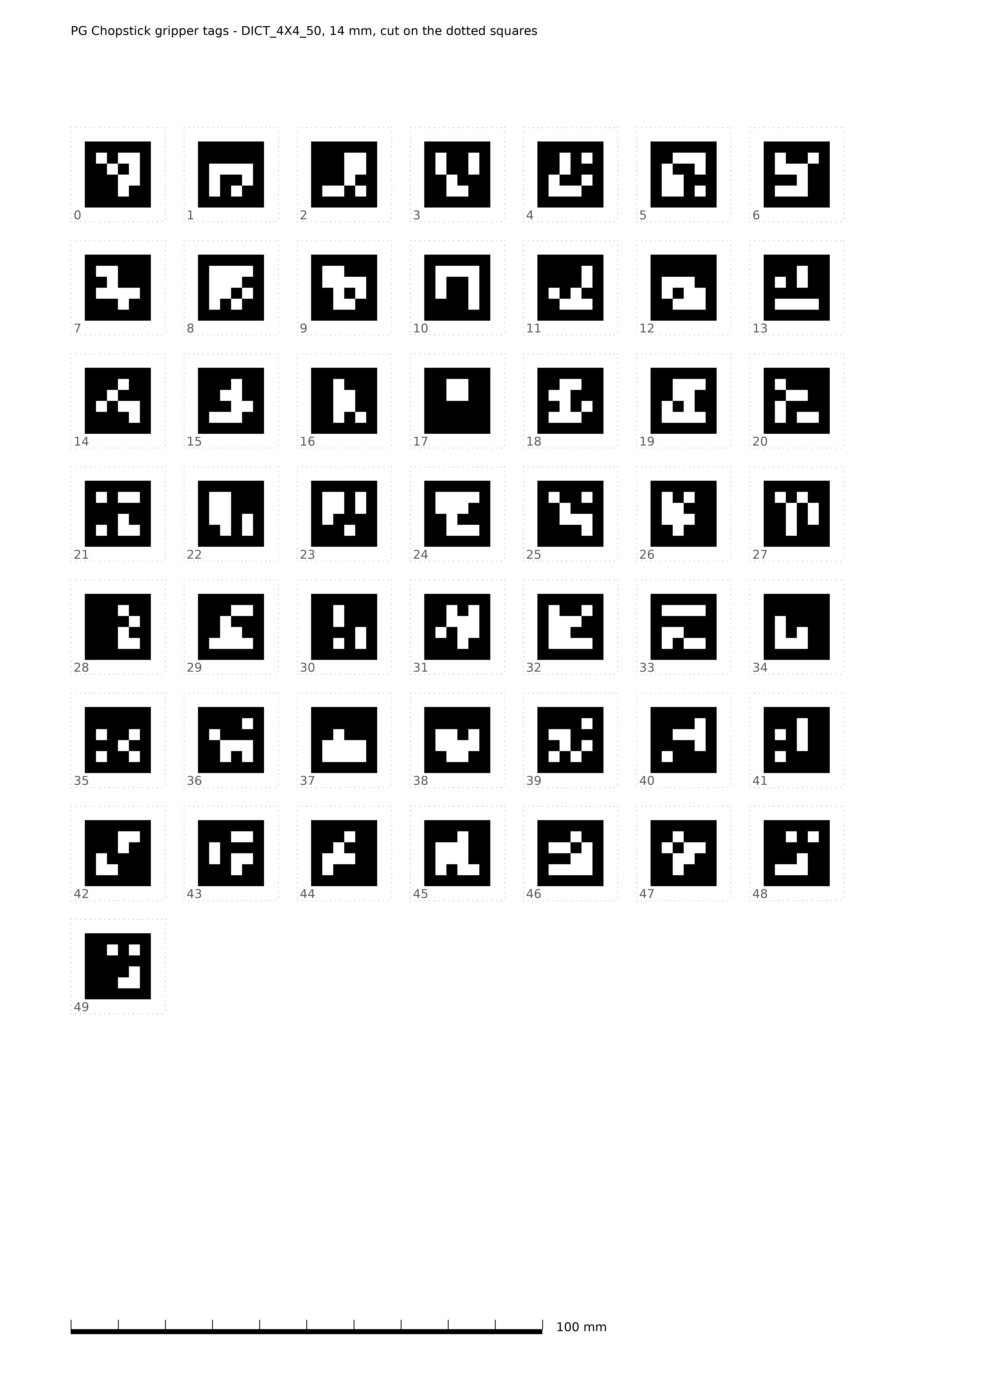
[picture p199: page 1]
