Pruthvi-Neuracore/The-UMI-no-one-wants-hw/assembly/d405/parallel/img/parallel_back.png

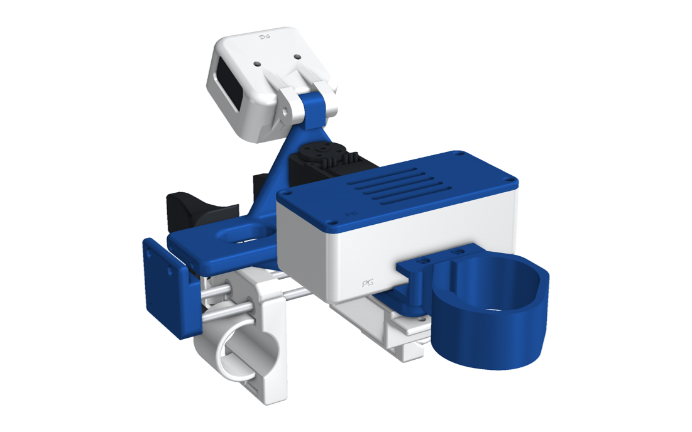
assembly/d405/parallel/img/parallel_back.png
