Pruthvi-Neuracore/The-UMI-no-one-wants-hw/assembly/d405/parallel/img/tips_agilex-piper.png

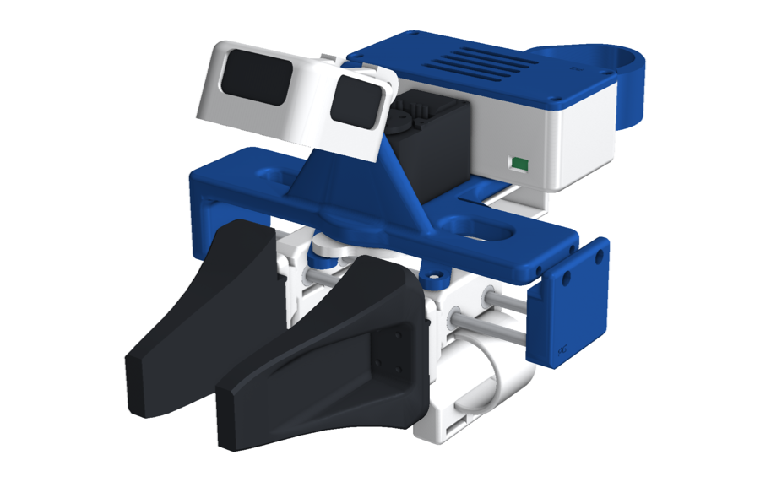
assembly/d405/parallel/img/tips_agilex-piper.png
