Pruthvi-Neuracore/The-UMI-no-one-wants-hw/assembly/d405/parallel/img/tips_robot_fanuc_crx5ia.png

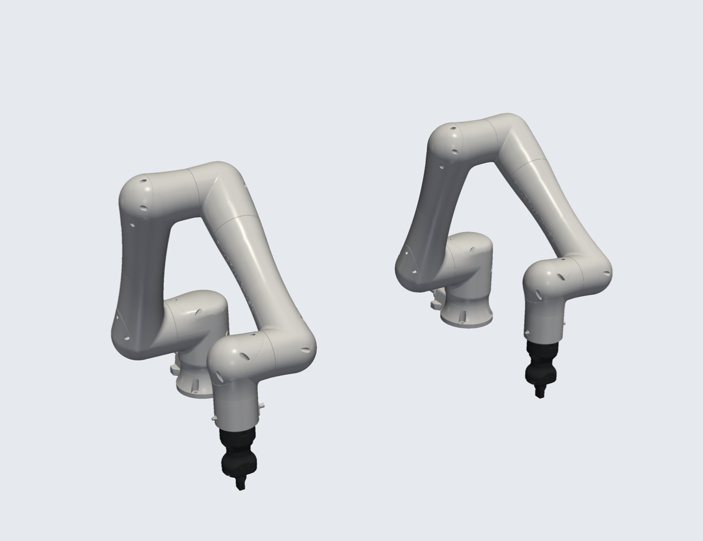
assembly/d405/parallel/img/tips_robot_fanuc_crx5ia.png
