Pruthvi-Neuracore/The-UMI-no-one-wants-hw/assembly/d405/parallel/img/tips_robotiq-hand-e.png

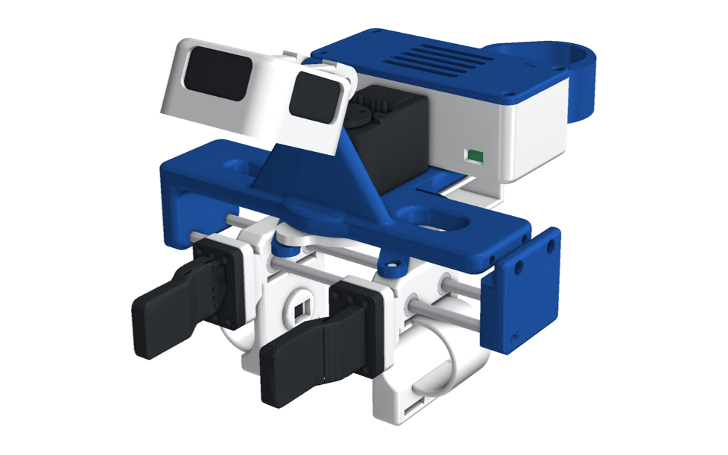
assembly/d405/parallel/img/tips_robotiq-hand-e.png
