Pruthvi-Neuracore/The-UMI-no-one-wants-hw/handumi/docs/assembly_guide/step_04.png

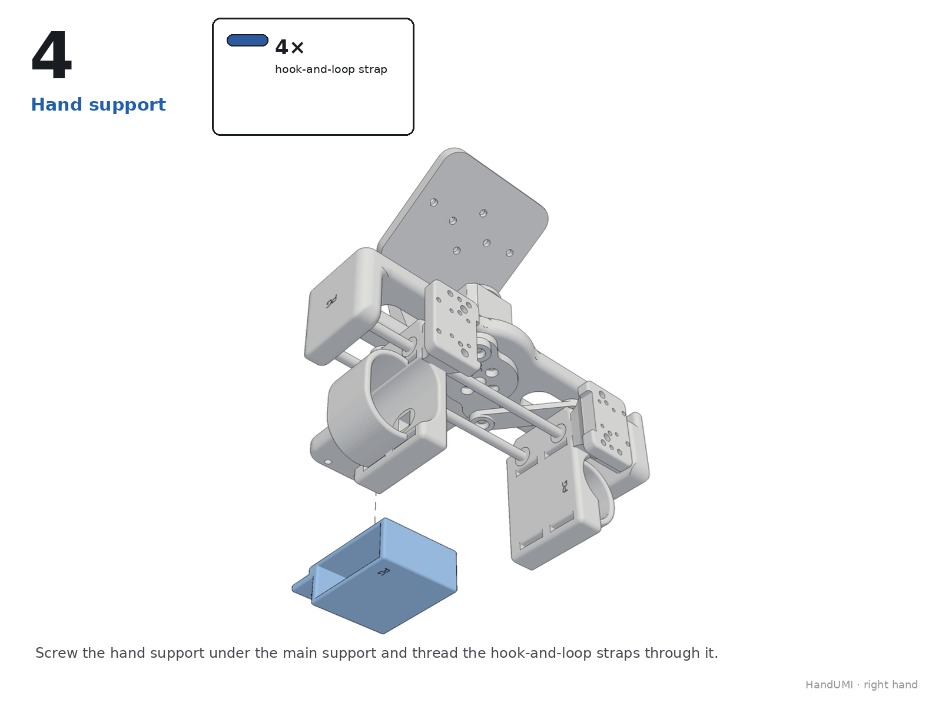
handumi/docs/assembly_guide/step_04.png
