Pruthvi-Neuracore/The-UMI-no-one-wants-hw/handumi/docs/assembly_guide/step_10.png

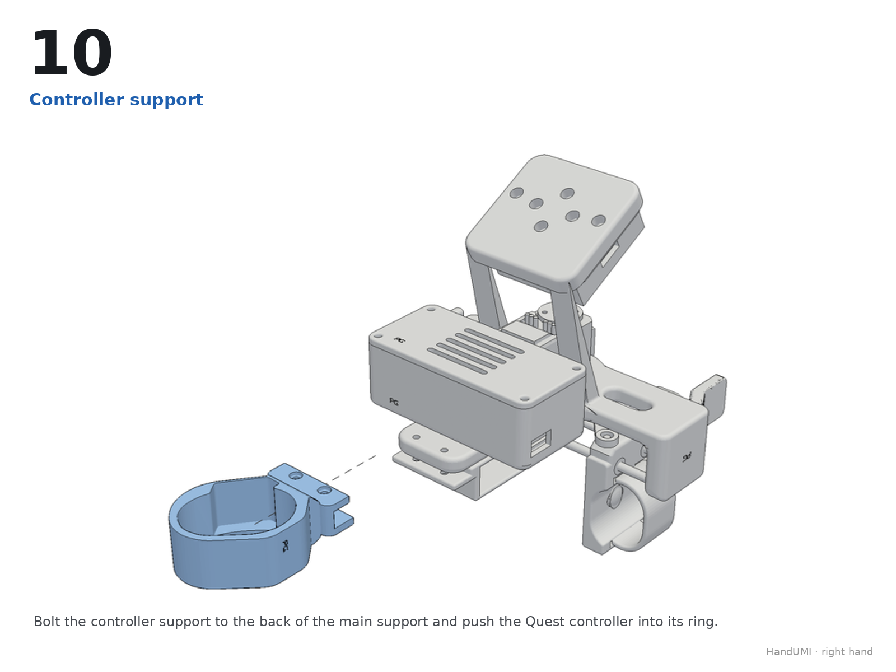
handumi/docs/assembly_guide/step_10.png
