Pruthvi-Neuracore/The-UMI-no-one-wants-hw/pg-chopstick/d405/chop-umi/img/openarm_bimanual.png

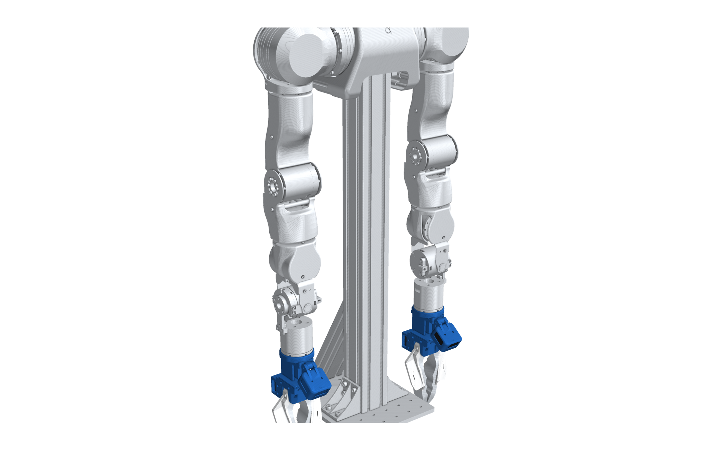
pg-chopstick/d405/chop-umi/img/openarm_bimanual.png
