Pruthvi-Neuracore/The-UMI-no-one-wants-hw/assembly/d405/chopstick/urdf/pg_chopstick_left.urdf

<?xml version="1.0"?>
<!-- PG Chopstick D405 hardware, generated by cad/urdf.py. Units: m, rad. -->
<robot name="pg_chopstick_left">
  <material name="pg_blue"><color rgba="0.12 0.37 0.68 1"/></material>
  <material name="pg_white"><color rgba="0.96 0.96 0.97 1"/></material>
  <material name="tpu"><color rgba="0.87 0.9 0.93 1"/></material>
  <material name="pg_green"><color rgba="0.18 0.62 0.27 1"/></material>
  <material name="pg_red"><color rgba="0.84 0.16 0.16 1"/></material>
  <material name="pg_strap"><color rgba="0.17 0.35 0.63 1"/></material>
  <material name="camera"><color rgba="0.11 0.12 0.13 1"/></material>
  <link name="pg_base">
    <visual name="d405_frame"><origin xyz="0 0 0" rpy="0 0 0"/><geometry><mesh filename="meshes/d405_frame.stl" scale="0.001 0.001 0.001"/></geometry><material name="pg_blue"/></visual>
    <collision name="d405_frame"><origin xyz="0 0 0" rpy="0 0 0"/><geometry><mesh filename="meshes/d405_frame.stl" scale="0.001 0.001 0.001"/></geometry></collision>
    <visual name="d405_cup"><origin xyz="0 0 0" rpy="0 0 0"/><geometry><mesh filename="meshes/d405_cup.stl" scale="0.001 0.001 0.001"/></geometry><material name="pg_blue"/></visual>
    <collision name="d405_cup"><origin xyz="0 0 0" rpy="0 0 0"/><geometry><mesh filename="meshes/d405_cup.stl" scale="0.001 0.001 0.001"/></geometry></collision>
    <visual name="ebox"><origin xyz="0 0 0" rpy="0 0 0"/><geometry><mesh filename="meshes/ebox.stl" scale="0.001 0.001 0.001"/></geometry><material name="pg_white"/></visual>
    <collision name="ebox"><origin xyz="0 0 0" rpy="0 0 0"/><geometry><mesh filename="meshes/ebox.stl" scale="0.001 0.001 0.001"/></geometry></collision>
    <visual name="ebox_lid"><origin xyz="0 0 0" rpy="0 0 0"/><geometry><mesh filename="meshes/ebox_lid.stl" scale="0.001 0.001 0.001"/></geometry><material name="pg_white"/></visual>
    <collision name="ebox_lid"><origin xyz="0 0 0" rpy="0 0 0"/><geometry><mesh filename="meshes/ebox_lid.stl" scale="0.001 0.001 0.001"/></geometry></collision>
    <visual name="quest_cradle"><origin xyz="0 0 0" rpy="0 0 0"/><geometry><mesh filename="meshes/quest_cradle.stl" scale="0.001 0.001 0.001"/></geometry><material name="pg_blue"/></visual>
    <collision name="quest_cradle"><origin xyz="0 0 0" rpy="0 0 0"/><geometry><mesh filename="meshes/quest_cradle.stl" scale="0.001 0.001 0.001"/></geometry></collision>
    <visual name="quest_controller_envelope"><origin xyz="0 0 0" rpy="0 0 0"/><geometry><mesh filename="meshes/quest_controller_envelope.stl" scale="0.001 0.001 0.001"/></geometry><material name="camera"/></visual>
    <collision name="quest_controller_envelope"><origin xyz="0 0 0" rpy="0 0 0"/><geometry><mesh filename="meshes/quest_controller_envelope.stl" scale="0.001 0.001 0.001"/></geometry></collision>
    <visual name="chopstick_clip_dc"><origin xyz="0 0 0" rpy="0 0 0"/><geometry><mesh filename="meshes/chopstick_clip_dc.stl" scale="0.001 0.001 0.001"/></geometry><material name="pg_blue"/></visual>
    <collision name="chopstick_clip_dc"><origin xyz="0 0 0" rpy="0 0 0"/><geometry><mesh filename="meshes/chopstick_clip_dc.stl" scale="0.001 0.001 0.001"/></geometry></collision>
    <visual name="chopstick_base_dc"><origin xyz="0 0 0" rpy="0 0 0"/><geometry><mesh filename="meshes/chopstick_base_dc.stl" scale="0.001 0.001 0.001"/></geometry><material name="pg_blue"/></visual>
    <collision name="chopstick_base_dc"><origin xyz="0 0 0" rpy="0 0 0"/><geometry><mesh filename="meshes/chopstick_base_dc.stl" scale="0.001 0.001 0.001"/></geometry></collision>
    <visual name="d405_envelope"><origin xyz="0 0 0" rpy="0 0 0"/><geometry><mesh filename="meshes/d405_envelope.stl" scale="0.001 0.001 0.001"/></geometry><material name="camera"/></visual>
    <collision name="d405_envelope"><origin xyz="0 0 0" rpy="0 0 0"/><geometry><mesh filename="meshes/d405_envelope.stl" scale="0.001 0.001 0.001"/></geometry></collision>
    <inertial><origin xyz="-0.0238334 -1.82398e-05 0.0229093" rpy="0 0 0"/><mass value="0.29945"/><inertia ixx="0.0003772" ixy="4.538e-07" ixz="5.747e-06" iyy="0.001153" iyz="-6.629e-08" izz="0.0009037"/></inertial>
  </link>
  <link name="pg_jaw_left">
    <visual name="tip_tpu_left"><origin xyz="0 0 0" rpy="0 0 0"/><geometry><mesh filename="meshes/tip_tpu_left_jawframe.stl" scale="0.001 0.001 0.001"/></geometry><material name="tpu"/></visual>
    <collision name="tip_tpu_left"><origin xyz="0 0 0" rpy="0 0 0"/><geometry><mesh filename="meshes/tip_tpu_left_jawframe.stl" scale="0.001 0.001 0.001"/></geometry></collision>
    <visual name="sleeve_strap_left"><origin xyz="0 0 0" rpy="0 0 0"/><geometry><mesh filename="meshes/sleeve_strap_left_jawframe.stl" scale="0.001 0.001 0.001"/></geometry><material name="pg_strap"/></visual>
    <collision name="sleeve_strap_left"><origin xyz="0 0 0" rpy="0 0 0"/><geometry><mesh filename="meshes/sleeve_strap_left_jawframe.stl" scale="0.001 0.001 0.001"/></geometry></collision>
    <visual name="jaw_left_dc_button"><origin xyz="0 0 0" rpy="0 0 0"/><geometry><mesh filename="meshes/jaw_left_dc_button_jawframe.stl" scale="0.001 0.001 0.001"/></geometry><material name="pg_white"/></visual>
    <collision name="jaw_left_dc_button"><origin xyz="0 0 0" rpy="0 0 0"/><geometry><mesh filename="meshes/jaw_left_dc_button_jawframe.stl" scale="0.001 0.001 0.001"/></geometry></collision>
    <visual name="sleeve_button_cover_left"><origin xyz="0 0 0" rpy="0 0 0"/><geometry><mesh filename="meshes/sleeve_button_cover_left_jawframe.stl" scale="0.001 0.001 0.001"/></geometry><material name="pg_red"/></visual>
    <collision name="sleeve_button_cover_left"><origin xyz="0 0 0" rpy="0 0 0"/><geometry><mesh filename="meshes/sleeve_button_cover_left_jawframe.stl" scale="0.001 0.001 0.001"/></geometry></collision>
    <inertial><origin xyz="0.0651897 0.00373761 -0.0037349" rpy="0 0 0"/><mass value="0.054547"/><inertia ixx="9.099e-06" ixy="7.189e-06" ixz="1.244e-06" iyy="6.957e-05" iyz="1.849e-07" izz="7.156e-05"/></inertial>
  </link>
  <link name="pg_tip_left"/>
  <link name="pg_jaw_right">
    <visual name="tip_tpu_right"><origin xyz="0 0 0" rpy="0 0 0"/><geometry><mesh filename="meshes/tip_tpu_right_jawframe.stl" scale="0.001 0.001 0.001"/></geometry><material name="tpu"/></visual>
    <collision name="tip_tpu_right"><origin xyz="0 0 0" rpy="0 0 0"/><geometry><mesh filename="meshes/tip_tpu_right_jawframe.stl" scale="0.001 0.001 0.001"/></geometry></collision>
    <visual name="sleeve_strap_right"><origin xyz="0 0 0" rpy="0 0 0"/><geometry><mesh filename="meshes/sleeve_strap_right_jawframe.stl" scale="0.001 0.001 0.001"/></geometry><material name="pg_strap"/></visual>
    <collision name="sleeve_strap_right"><origin xyz="0 0 0" rpy="0 0 0"/><geometry><mesh filename="meshes/sleeve_strap_right_jawframe.stl" scale="0.001 0.001 0.001"/></geometry></collision>
    <visual name="jaw_right_dc"><origin xyz="0 0 0" rpy="0 0 0"/><geometry><mesh filename="meshes/jaw_right_dc_jawframe.stl" scale="0.001 0.001 0.001"/></geometry><material name="pg_white"/></visual>
    <collision name="jaw_right_dc"><origin xyz="0 0 0" rpy="0 0 0"/><geometry><mesh filename="meshes/jaw_right_dc_jawframe.stl" scale="0.001 0.001 0.001"/></geometry></collision>
    <inertial><origin xyz="0.0651715 -0.00372102 -0.00404317" rpy="0 0 0"/><mass value="0.054576"/><inertia ixx="9.295e-06" ixy="-7.161e-06" ixz="1.284e-06" iyy="6.991e-05" iyz="-4.596e-07" izz="7.166e-05"/></inertial>
  </link>
  <link name="pg_tip_right"/>
  <link name="pg_camera"/>
  <link name="pg_tcp"/>
  <joint name="pg_jaw" type="revolute">
    <parent link="pg_base"/><child link="pg_jaw_left"/>
    <origin xyz="0.06733 0.015 0" rpy="0 0 0"/><axis xyz="0 0 1"/>
    <limit lower="0.00000" upper="1.25664" effort="4" velocity="6"/>
  </joint>
  <joint name="pg_tip_left_joint" type="fixed"><parent link="pg_jaw_left"/><child link="pg_tip_left"/><origin xyz="0.137417 -0.015085 -0.003671" rpy="0 0 0"/></joint>
  <joint name="pg_jaw_right" type="revolute">
    <parent link="pg_base"/><child link="pg_jaw_right"/>
    <origin xyz="0.06733 -0.015 0" rpy="0 0 0"/><axis xyz="0 0 1"/>
    <limit lower="-1.25664" upper="0.00000" effort="4" velocity="6"/>
    <mimic joint="pg_jaw" multiplier="-1" offset="0"/>
  </joint>
  <joint name="pg_tip_right_joint" type="fixed"><parent link="pg_jaw_right"/><child link="pg_tip_right"/><origin xyz="0.137417 0.015085 -0.003671" rpy="0 0 0"/></joint>
  <joint name="pg_camera_joint" type="fixed"><parent link="pg_base"/><child link="pg_camera"/><origin xyz="0.038570578 0 0.047885939" rpy="0 0.610864816 0"/></joint>
  <joint name="pg_tcp_joint" type="fixed"><parent link="pg_base"/><child link="pg_tcp"/><origin xyz="0.204747 0 -0.003671" rpy="0 0 0"/></joint>
</robot>
