Pruthvi-Neuracore/The-UMI-no-one-wants-hw/assembly/d405/parallel/urdf/pg_parallel_iso50.urdf

<?xml version="1.0"?>
<!-- PG Chopstick D405 hardware, generated by cad/urdf.py. Units: m, rad. -->
<robot name="pg_parallel_iso50">
  <material name="pg_blue"><color rgba="0.12 0.37 0.68 1"/></material>
  <material name="pg_white"><color rgba="0.96 0.96 0.97 1"/></material>
  <material name="tpu"><color rgba="0.87 0.9 0.93 1"/></material>
  <material name="pg_green"><color rgba="0.18 0.62 0.27 1"/></material>
  <material name="pg_red"><color rgba="0.84 0.16 0.16 1"/></material>
  <material name="pg_strap"><color rgba="0.17 0.35 0.63 1"/></material>
  <material name="camera"><color rgba="0.11 0.12 0.13 1"/></material>
  <link name="pg_flange"/>
  <link name="pg_base">
    <visual name="d405_frame"><origin xyz="0 0 0" rpy="0 0 0"/><geometry><mesh filename="meshes/d405_frame.stl" scale="0.001 0.001 0.001"/></geometry><material name="pg_blue"/></visual>
    <collision name="d405_frame"><origin xyz="0 0 0" rpy="0 0 0"/><geometry><mesh filename="meshes/d405_frame.stl" scale="0.001 0.001 0.001"/></geometry></collision>
    <visual name="d405_cup"><origin xyz="0 0 0" rpy="0 0 0"/><geometry><mesh filename="meshes/d405_cup.stl" scale="0.001 0.001 0.001"/></geometry><material name="pg_blue"/></visual>
    <collision name="d405_cup"><origin xyz="0 0 0" rpy="0 0 0"/><geometry><mesh filename="meshes/d405_cup.stl" scale="0.001 0.001 0.001"/></geometry></collision>
    <visual name="chopstick_clip_sa"><origin xyz="0 0 0" rpy="0 0 0"/><geometry><mesh filename="meshes/chopstick_clip_sa.stl" scale="0.001 0.001 0.001"/></geometry><material name="pg_blue"/></visual>
    <collision name="chopstick_clip_sa"><origin xyz="0 0 0" rpy="0 0 0"/><geometry><mesh filename="meshes/chopstick_clip_sa.stl" scale="0.001 0.001 0.001"/></geometry></collision>
    <visual name="parallel_base_sa"><origin xyz="0 0 0" rpy="0 0 0"/><geometry><mesh filename="meshes/parallel_base_sa.stl" scale="0.001 0.001 0.001"/></geometry><material name="pg_blue"/></visual>
    <collision name="parallel_base_sa"><origin xyz="0 0 0" rpy="0 0 0"/><geometry><mesh filename="meshes/parallel_base_sa.stl" scale="0.001 0.001 0.001"/></geometry></collision>
    <visual name="iso_flange_plate"><origin xyz="0 0 0" rpy="0 0 0"/><geometry><mesh filename="meshes/iso_flange_plate.stl" scale="0.001 0.001 0.001"/></geometry><material name="pg_blue"/></visual>
    <collision name="iso_flange_plate"><origin xyz="0 0 0" rpy="0 0 0"/><geometry><mesh filename="meshes/iso_flange_plate.stl" scale="0.001 0.001 0.001"/></geometry></collision>
    <visual name="d405_envelope"><origin xyz="0 0 0" rpy="0 0 0"/><geometry><mesh filename="meshes/d405_envelope.stl" scale="0.001 0.001 0.001"/></geometry><material name="camera"/></visual>
    <collision name="d405_envelope"><origin xyz="0 0 0" rpy="0 0 0"/><geometry><mesh filename="meshes/d405_envelope.stl" scale="0.001 0.001 0.001"/></geometry></collision>
    <visual name="parallel_rod_top"><origin xyz="0 0 0" rpy="0 0 0"/><geometry><mesh filename="meshes/parallel_rod_top.stl" scale="0.001 0.001 0.001"/></geometry><material name="pg_blue"/></visual>
    <collision name="parallel_rod_top"><origin xyz="0 0 0" rpy="0 0 0"/><geometry><mesh filename="meshes/parallel_rod_top.stl" scale="0.001 0.001 0.001"/></geometry></collision>
    <visual name="parallel_rod_bottom"><origin xyz="0 0 0" rpy="0 0 0"/><geometry><mesh filename="meshes/parallel_rod_bottom.stl" scale="0.001 0.001 0.001"/></geometry><material name="pg_blue"/></visual>
    <collision name="parallel_rod_bottom"><origin xyz="0 0 0" rpy="0 0 0"/><geometry><mesh filename="meshes/parallel_rod_bottom.stl" scale="0.001 0.001 0.001"/></geometry></collision>
    <visual name="servo_envelope"><origin xyz="0 0 0" rpy="0 0 0"/><geometry><mesh filename="meshes/servo_envelope.stl" scale="0.001 0.001 0.001"/></geometry><material name="camera"/></visual>
    <collision name="servo_envelope"><origin xyz="0 0 0" rpy="0 0 0"/><geometry><mesh filename="meshes/servo_envelope.stl" scale="0.001 0.001 0.001"/></geometry></collision>
    <inertial><origin xyz="0.0694031 -0.00429931 -0.00623435" rpy="0 0 0"/><mass value="0.44314"/><inertia ixx="0.0009228" ixy="2.334e-05" ixz="0.0002228" iyy="0.00114" iyz="-6.266e-05" izz="0.001062"/></inertial>
  </link>
  <link name="pg_finger_left">
    <visual name="parallel_carriage_left"><origin xyz="0 0 0" rpy="0 0 0"/><geometry><mesh filename="meshes/parallel_carriage_left.stl" scale="0.001 0.001 0.001"/></geometry><material name="pg_white"/></visual>
    <collision name="parallel_carriage_left"><origin xyz="0 0 0" rpy="0 0 0"/><geometry><mesh filename="meshes/parallel_carriage_left.stl" scale="0.001 0.001 0.001"/></geometry></collision>
    <visual name="parallel_finger_left"><origin xyz="0 0 0" rpy="0 0 0"/><geometry><mesh filename="meshes/parallel_finger_left.stl" scale="0.001 0.001 0.001"/></geometry><material name="pg_white"/></visual>
    <collision name="parallel_finger_left"><origin xyz="0 0 0" rpy="0 0 0"/><geometry><mesh filename="meshes/parallel_finger_left.stl" scale="0.001 0.001 0.001"/></geometry></collision>
    <visual name="parallel_pad_left"><origin xyz="0 0 0" rpy="0 0 0"/><geometry><mesh filename="meshes/parallel_pad_left.stl" scale="0.001 0.001 0.001"/></geometry><material name="tpu"/></visual>
    <collision name="parallel_pad_left"><origin xyz="0 0 0" rpy="0 0 0"/><geometry><mesh filename="meshes/parallel_pad_left.stl" scale="0.001 0.001 0.001"/></geometry></collision>
    <inertial><origin xyz="0.148394 0.016035 0.000155316" rpy="0 0 0"/><mass value="0.036548"/><inertia ixx="8.587e-06" ixy="7.976e-06" ixz="4.867e-07" iyy="4.148e-05" iyz="6.79e-08" izz="4.574e-05"/></inertial>
  </link>
  <link name="pg_tip_left"/>
  <link name="pg_finger_right">
    <visual name="parallel_carriage_right"><origin xyz="0 0 0" rpy="0 0 0"/><geometry><mesh filename="meshes/parallel_carriage_right.stl" scale="0.001 0.001 0.001"/></geometry><material name="pg_white"/></visual>
    <collision name="parallel_carriage_right"><origin xyz="0 0 0" rpy="0 0 0"/><geometry><mesh filename="meshes/parallel_carriage_right.stl" scale="0.001 0.001 0.001"/></geometry></collision>
    <visual name="parallel_finger_right"><origin xyz="0 0 0" rpy="0 0 0"/><geometry><mesh filename="meshes/parallel_finger_right.stl" scale="0.001 0.001 0.001"/></geometry><material name="pg_white"/></visual>
    <collision name="parallel_finger_right"><origin xyz="0 0 0" rpy="0 0 0"/><geometry><mesh filename="meshes/parallel_finger_right.stl" scale="0.001 0.001 0.001"/></geometry></collision>
    <visual name="parallel_pad_right"><origin xyz="0 0 0" rpy="0 0 0"/><geometry><mesh filename="meshes/parallel_pad_right.stl" scale="0.001 0.001 0.001"/></geometry><material name="tpu"/></visual>
    <collision name="parallel_pad_right"><origin xyz="0 0 0" rpy="0 0 0"/><geometry><mesh filename="meshes/parallel_pad_right.stl" scale="0.001 0.001 0.001"/></geometry></collision>
    <inertial><origin xyz="0.142532 -0.0168772 0.000276745" rpy="0 0 0"/><mass value="0.038444"/><inertia ixx="9.322e-06" ixy="-8.958e-06" ixz="7.938e-07" iyy="6.229e-05" iyz="4.336e-07" izz="6.688e-05"/></inertial>
  </link>
  <link name="pg_tip_right"/>
  <link name="pg_pinion">
    <visual name="parallel_pinion_servo"><origin xyz="0 0 0" rpy="0 0 0"/><geometry><mesh filename="meshes/parallel_pinion_servo_pinionframe.stl" scale="0.001 0.001 0.001"/></geometry><material name="pg_blue"/></visual>
    <collision name="parallel_pinion_servo"><origin xyz="0 0 0" rpy="0 0 0"/><geometry><mesh filename="meshes/parallel_pinion_servo_pinionframe.stl" scale="0.001 0.001 0.001"/></geometry></collision>
    <inertial><origin xyz="-1.12064e-17 1.48228e-15 -2.72907e-18" rpy="0 0 0"/><mass value="0.005166"/><inertia ixx="3.739e-07" ixy="3.335e-22" ixz="-1.401e-24" iyy="3.739e-07" iyz="-3.308e-25" izz="6.239e-07"/></inertial>
  </link>
  <link name="pg_camera"/>
  <link name="pg_tcp"/>
  <joint name="pg_mount_joint" type="fixed"><parent link="pg_flange"/><child link="pg_base"/><origin xyz="0 0 0.016" rpy="0 -1.57079633 0"/></joint>
  <joint name="pg_finger" type="prismatic">
    <parent link="pg_base"/><child link="pg_finger_left"/>
    <origin xyz="0 0 0" rpy="0 0 0"/><axis xyz="0 1 0"/>
    <limit lower="0.00000" upper="0.03000" effort="60" velocity="0.2"/>
  </joint>
  <joint name="pg_tip_left_joint" type="fixed"><parent link="pg_finger_left"/><child link="pg_tip_left"/><origin xyz="0.214 0 0" rpy="0 0 0"/></joint>
  <joint name="pg_finger_right" type="prismatic">
    <parent link="pg_base"/><child link="pg_finger_right"/>
    <origin xyz="0 0 0" rpy="0 0 0"/><axis xyz="0 1 0"/>
    <limit lower="-0.03000" upper="0.00000" effort="60" velocity="0.2"/>
    <mimic joint="pg_finger" multiplier="-1" offset="0"/>
  </joint>
  <joint name="pg_tip_right_joint" type="fixed"><parent link="pg_finger_right"/><child link="pg_tip_right"/><origin xyz="0.214 0 0" rpy="0 0 0"/></joint>
  <joint name="pg_pinion_joint" type="continuous">
    <parent link="pg_base"/><child link="pg_pinion"/>
    <origin xyz="0.082 0 0" rpy="0 0 0"/><axis xyz="0 0 1"/>
    <mimic joint="pg_finger" multiplier="66.6667" offset="0"/>
  </joint>
  <joint name="pg_camera_joint" type="fixed"><parent link="pg_base"/><child link="pg_camera"/><origin xyz="0.038570578 0 0.047885939" rpy="0 0.610864816 0"/></joint>
  <joint name="pg_tcp_joint" type="fixed"><parent link="pg_base"/><child link="pg_tcp"/><origin xyz="0.206 0 0" rpy="0 0 0"/></joint>
</robot>
