Pruthvi-Neuracore/The-UMI-no-one-wants-hw/(commit log)

2026-10-12 PG Chopstick: Insta360 X5 and D405 + Quest kits, each with chopstick, parallel and hand
    - assembly/<kit>/<family>/: README, bom.md, electronics.md, STEP, STL, assemblies, URDFs and renders per variant
    - Insta360 X5 kit: wireless, PG pod (ESP32-S3 + IMU); D405 kit: HandUMI tilt cup, Pico 2 + IMU + USB 3 hub box,
    Quest 3S controller cradle for tracking
    - Elastic finger sleeves, one button under the index finger (green: record, right hand; red: cancel, left hand),
    blue tracking dots
    - Robot twins on OpenArm and ISO 9409-1-50-4-M6 flanges; renders on UR5, ABB GoFa, FANUC CRX-5iA and OpenArm
    - cad/<kit>/: generators; package.py copies each kit into the assembly tree
2026-10-12 Overview video: chopstick and parallel grippers, robot twins docking on UR5e, ABB GoFa, FANUC CRX and OpenArm, wrist mount, D405 + Quest builds
    - cad/<kit>/animate.py renders the segments; cad/make_video.py adds title cards and crossfades and makes the GIF
    - robots.py: approach axis from tool0's +Z where tool0 sits on the flange (fixes the ABB mount), and a camera-up
    fallback when the tool points straight up
2026-10-12 Re-render the ABB GoFa images with the plate on the correct flange face
2026-10-12 Parallel = HandUMI T-plate gripper (X5 cradle on its hinge), real Quest Touch Pro, realistic hand and robot-hand renders
    - Parallel family in both kits is now HandUMI unchanged (parts, tips, assembly code vendored in cad/<kit>/handumi),
    built by t_gripper.py. X5 kit: the only new part is x5_wrist_mount, the X5 standing upright on HandUMI's Ø12/M4
    hinge; clash-free at every opening with every tip set, tilts 63° back to fully forward. D405 kit: HandUMI as-is.
    The rack-and-pinion parallel module is removed from both pipelines.
    - D405 kit: the Quest controller is Meta's Touch Pro model, fitted upright in the cradle on 2 mm foam (file git-ignored).
    - Hand renders: posed human hand and for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
2026-10-12 D405 parallel = HandUMI as-is; real Quest Touch Pro controller; realistic hand and robot-hand renders
    Synced from pg-chopstick: cad/d405 and assembly/d405. The parallel gripper is HandUMI unchanged (vendored in
    cad/d405/handumi, built by t_gripper.py, no interferences at any opening with any tip set). The cradle now holds Meta's
    Touch Pro controller model (file git-ignored). The hand render shows a posed hand and forearm with the strap, and
    hand_robot.png the same head on a Shadow Hand on a UR5e. README and video updated.
2026-10-13 Main: render gallery README; PG Chopstick as Chop-UMI / Para-UMI / Hand with the Quest in HandUMI's support, thumb strap and palm button, robot camera posts
2026-11-02 Scissor-UMI for the Robotiq 2F-140: FOMI-style scissor handles driving the 2F-140's own four-bar jaws, D405 + Quest Touch Pro head shared with the robot via an ISO 50 collar
    - cad/kin.py: 2F-140 jaw kinematics from Robotiq's URDF (parametric, so a 2F-85 entry can be added)
    - cad/scissor.py: plates, synced 20T knuckle gears, 40T scissor-handle sectors (2:1), outer links, fingers, TPU pads,
    ebox, head (HandUMI D405 cup knuckle + Quest ring arm end), robot collar; STEP only
    - cad/assembly.py: placement over q and clearance checks; render.py, urdf.py, package.py
    - scissor-umi/2f-140: STEP, renders (incl. matched D405 views handheld vs robot), BOM, electronics, URDF + head xacro
2026-11-02 Scissor-UMI 2F-140: jaws are printed copies of the Robotiq 2F-140 jaw parts
    - cad/replica.py: outer knuckle + outer finger, inner knuckle, inner finger and pad from Robotiq's 2F-140 geometry
    at the URDF joint frames; only hidden features changed (bores, modelled pins removed, drive lever trimmed,
    gear key holes, 0.3 mm joint clearance, pad split into PETG core + TPU face)
    - knuckle gears sit in the inner knuckles' base clevis, keyed with 2 x M3; plates moved out to +-20.5..25.5 mm,
    electronics box under the bottom plate; 0.08 mm flank clearance on all gears
    - cad/verify.py: gear engagement and backlash over the stroke, jaws vs the robot's 2F-140 meshes, interference
    - STEP, renders, BO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
2026-11-02 Scissor-UMI 2F-140: ergonomic handles, STS3215 jaw encoder, camera on the UR camera plate's tab, Quest collar above the camera
    - handles: rounded thumb ring and two-finger bow with finger rest (R 3.4 edges, 7 mm walls), lofted arms
    - Feetech STS3215 coaxial with the scissor axle under the base (torque off, as on HandUMI), in a larger
    electronics box with the Pico 2, IMU and USB hub; replaces the AS5047P
    - robot side: the team's UR camera plate unchanged with the D405 on its tab, no Quest
    - handheld: tab_mast copies that tab (same pose and holes), open d405_hood, quest_arm with a split collar
    bored to the Touch Pro's handle, standing on the centre plane above the camera
    - verify/check cov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
2026-11-02 Scissor-UMI 2F-140: garden-scissor grips, Quest behind the camera, camera tab check, Pico firmware for the STS3215 encoder
    - handles: palm bar (B) and four-finger D-loop (A) after a spring-action garden scissor, 26 mm tall, every edge
    rounded, soft TPU inserts (grip_tpu_a / grip_tpu_b); hold from below, index finger on the record button
    - Quest Touch Pro right behind the camera: quest_arm pad on the mast's back (M3 from the front) + split collar
    - verify.camera(): handheld tab_mast vs the robot's ur_camera_plate tab, measured from the STEP files
    (faces and all six holes coincide), so the D405 pose is the same on both
    - firmware/pico/main.py (MicroPython): STS3215 encoder over the half-du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
2026-11-05 Scissor-UMI 2F-140: IKEA-style assembly instructions from the CAD, hand-held renders, renders from the front, FOMI credits removed
2026-11-05 Scissor-UMI 2F-140: compress the assembly PDF (1.7 MB, lossless)
2026-11-05 IKEA-style assembly guides for HandUMI and Chop-UMI (D405); Quest controllers trigger-forward in the D405 renders; overview video on a light background with the real hand
2026-11-05 Scissor-UMI 2F-140: fix the outer link (the modelled pin at the finger joint was left in: OCC's cut failed silently on the mesh solid; now cut on the mesh), and make the clearance check close every m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
2026-11-05 Scissor-UMI: 2F-85 support (kinematics, Robotiq 2F-85 jaw replicas built on the meshes, generic robot twin and guides)
2026-11-05 Scissor-UMI 2F-85: parts, checks, renders, assembly guide, URDFs and docs; firmware selects the gripper
2026-11-05 HandUMI: finger flanges for Piper, Hand-E, YAM and OpenArm fingers; fixed D405 mount
    - Finger links carry each robot's real finger mount (AgileX Piper 4x M2 8x12, Robotiq
    Hand-E 2x M3 9 mm + 2 mm dowel, I2RT YAM 2x M4 21 mm + key slot, OpenArm v1 4x M2.5
    10x15), placed per link so the jaws meet on the centre plane. The old M2/M3/M4 plate
    patterns are gone.
    - Tips now use the robots' own mounts: Hand-E finger with its real rack mount (+ shim for
    real Robotiq fingers), unmodified Open-ENPIRE YAM finger, new OpenArm hard-shell finger.
    - D405 fixed on a tab at the end of the camera post (same 65 deg view) with a hood,
    replacing the hinge and cup; M4 hinge bolt dropped from the BOM.
    - A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
2026-11-06 HandUMI: D405 mount matched to a new Hand-E robot plate (Scissor-UMI approach)
    - The D405 sits on Scissor-UMI's tab and hood, on an arch over the encoder, 96 mm from the fingers, 61 deg down;
    the jaws stay in view from closed to fully open.
    - New robot part hardware/{STEP,STL}/robot/hande_camera_plate: the team's ur_camera_plate ring with a ribbed blade
    down beside the Hand-E to the same tab, at the same pose relative to the fingers.
    - Renders (camera view, HandUMI/robot twin, robot plate, hero, parts), assemblies, assembly guide, README, BOM, NOTICE.
